valiklushnikov/input-duo/README.md

# Переключатель одной мыши между двумя ноутбуками

Устройство состоит из двух совместимых с Pro Micro плат на ATmega32U4, **5 В / 16 МГц**. К плате master подключается мышь, а receiver представляется второму ноутбуку как USB HID-мышь. Каждая плата получает питание по USB **от своего** ноутбука.

## Что прошивать

- `legacy/` — точно восстановленный исходный код. Это архивная версия для сравнения; не рекомендуется для новой сборки.
- `improved/` — рекомендуемая версия для новой сборки. Она допускает подключение плат в любом порядке и повторяет инициализацию мыши при неудаче.

Откройте в Arduino IDE `improved/mouse_switch_master/mouse_switch_master.ino` и прошейте её в плату со стороны мыши. Затем откройте `improved/mouse_switch_receiver/mouse_switch_receiver.ino` и прошейте её в другую плату, подключённую ко второму ноутбуку.

При обновлении уже работающей версии v4 до v5 достаточно заново прошить только master. Код receiver и протокол между платами не изменились.

Для компиляции выберите **Arduino Leonardo**: это совместимая цель для ATmega32U4/16 МГц. Для загрузки выбирайте фактическое определение платы Pro Micro, если оно доступно в вашей установке IDE. Если плата обычно не появляется как порт, дважды кратко нажмите Reset: второй сброс открывает загрузчик на несколько секунд. Выберите появившийся порт и начните загрузку сразу.

## Подключение

Перед подключением мыши проверьте распиновку USB-A. На версии Pro Micro 5V/16 MHz питание гнезда мыши берётся с рабочей линии VCC. Не полагайтесь на ориентацию разъёма «на глаз» — сверяйте её с конкретным гнездом и по возможности прозванивайте контакты.

```text
USB-A mouse pin 1 VBUS -> master VCC (только Pro Micro 5V/16 MHz)
USB-A mouse pin 2 D-   -> master D9 / PS2 Data
USB-A mouse pin 3 D+   -> master D10 / PS2 Clock
USB-A mouse pin 4 GND  -> master GND

master GND    -> receiver GND
master D2/SDA -> receiver D2/SDA
master D3/SCL -> receiver D3/SCL
```

Не соединяйте VCC или RAW двух плат между собой: USB каждого ноутбука питает только свою плату, а объединение шин питания ноутбуков опасно. D9/D10 используются только между гнездом мыши и master. На receiver они не нужны и в новой сборке их **нельзя** соединять между платами.

Если на платах нет подтяжек I²C, установите **одну** пару резисторов 4,7 кОм: один от SDA к локальным 5 В master, другой от SCL к локальным 5 В master. Общими между платами остаются только GND, SDA и SCL; не добавляйте соединение VCC/RAW и не объединяйте питающие линии ноутбуков.

Нужна мышь, умеющая режим PS/2 через пассивное USB-сопоставление. Произвольная современная мышь только с USB таким способом не заработает.

## Работа

После включения изначально выбран **ноутбук 2**. Боковая кнопка с маской `0x10` переключает ноутбуки один раз при каждом нажатии. Удержание не вызывает повторных переключений.

Вторая боковая кнопка с маской `0x20` всегда запускает на ноутбуке, подключённом к master, последовательность `Enter` → `/target KYPKYMA` → `Enter`. Текущая сторона управления мышью на это не влияет. Перед использованием на master-ноутбуке должна быть включена английская раскладка. Между символами выдерживается случайная задержка 35–80 мс, а после первого `Enter` и перед завершающим `Enter` — 80–140 мс. Макрос работает неблокирующе, поэтому движение мыши и передача на receiver продолжаются во время набора. Удержание `0x20` запускает только один макрос; для следующего запуска кнопку нужно отпустить и нажать снова.

Средняя кнопка полностью игнорируется. Движения, колесо, левая и правая кнопки направляются выбранной стороне.

## Если что-то не работает

- Нет реакции мыши: проверьте, не перепутаны ли D9 (PS/2 Data) и D10 (PS/2 Clock), подключён ли VBUS гнезда мыши к VCC платы 5V/16 MHz и совместима ли мышь с пассивным PS/2.
- Связи между платами нет: проверьте общий GND, SDA D2 и SCL D3; при необходимости добавьте описанную выше одну пару подтяжек I²C 4,7 кОм.
- Receiver не управляет ноутбуком: убедитесь, что в нём прошит `improved/mouse_switch_receiver`, а не master; проверьте адрес receiver I²C, заданный в скетчах.
- Макрос печатает другие символы: перед нажатием `0x20` переключите master-ноутбук на английскую раскладку. Прошивка отправляет американские HID-коды для точной строки `/target KYPKYMA`.
- После обрыва связи «залипла» кнопка: восстановите I²C, дождитесь повторного соединения improved-версии и отпустите/нажмите кнопку. Если состояние не очистилось, переподключите receiver к USB и проверьте все три линии I²C.

## Приёмка оборудования

Проверьте сборку до постоянного монтажа:

- [ ] Подключение сначала master, затем receiver; и в обратном порядке.
- [ ] После запуска выбран ноутбук 2.
- [ ] На обеих сторонах работают X/Y, колесо и кнопки.
- [ ] Переключение во время удержания левой и правой кнопок.
- [ ] Каждое нажатие выбранной боковой кнопки `0x10` даёт ровно одно переключение; удержание не повторяет переключение.
- [ ] Каждое нажатие боковой кнопки `0x20` на master вводит и отправляет ровно одну строку `/target KYPKYMA` с двумя `Enter`.
- [ ] Удержание `0x20` не повторяет макрос; после отпускания новое нажатие запускает его один раз.
- [ ] Во время макроса курсор продолжает двигаться плавно на обеих сторонах.
- [ ] Средняя кнопка полностью игнорируется.
- [ ] Отключение и повторное подключение мыши.
- [ ] Отключение и повторное подключение I²C.
