valiklushnikov/input-duo/docs/superpowers/specs/2026-08-02-two-board-diagnostics-design.md

# Диагностика двух Arduino Pro Micro

## Цель

Создать два временных диагностических скетча, которые без мультиметра проверяют обе платы ATmega32U4 и соединение между ними. Тесты не заменяют рабочие прошивки и после диагностики должны быть перезаписаны рабочими скетчами.

## Проверяемые узлы

1. USB CDC/Serial обеих плат.
2. USB HID Mouse второй платы.
3. Соединение `GND–GND`, `D2/SDA–D2/SDA`, `D3/SCL–D3/SCL`.
4. Передача I2C от первой платы ко второй по адресу `0x02`.
5. Ответ второй платы первой через `Wire.onRequest`.
6. Целостность и порядок тестовых пакетов.

PS/2-мышь, `D9` и `D10` проверяются отдельным скетчем `ps2_mouse_diagnostic_v2` и не входят в эту пару тестов.

## Скетч первой платы

`board1_link_tester.ino` работает как I2C-master и USB Serial-устройство.

- Каждую секунду запрашивает двухбайтовое состояние у адреса `0x02`: сигнатуру и номер последнего правильно обработанного пакета.
- При правильном ответе отправляет тестовый пакет с возрастающим номером последовательности.
- Пакет содержит сигнатуру, номер, направление небольшого движения и XOR-контрольную сумму.
- После передачи повторно запрашивает состояние второй платы и проверяет, что номер принятого пакета совпадает.
- В Serial Monitor на скорости 115200 печатает отдельный результат каждого цикла: `PASS`, отсутствие адреса, ошибка передачи, неверный ответ или несовпадение последовательности.
- Не использует PS/2-мышь и не формирует USB HID-команды.

## Скетч второй платы

`board2_full_test.ino` работает одновременно как I2C-slave с адресом `0x02`, USB Serial-устройство и HID-мышь.

- После запуска даёт пять секунд на открытие Serial Monitor.
- Один раз перемещает курсор по небольшому квадрату: вправо, вниз, влево, вверх. Нажатия кнопок не выполняются.
- Принимает только пакет ожидаемой длины, сигнатуры и контрольной суммы.
- Обработчик I2C сохраняет входные байты и состояние; вызовы `Mouse.move` выполняются только в `loop()`, не внутри прерывания.
- Для каждого правильного пакета выполняет небольшое движение курсора в заданном направлении.
- Через `Wire.onRequest` возвращает сигнатуру состояния и номер последнего правильно обработанного пакета.
- Serial Monitor показывает автономный HID-тест, правильные пакеты, ошибки длины/контрольной суммы и счётчики.

## Подключение и порядок проверки

### Автономный тест второй платы

1. Отключить провода `D2`, `D3` и `GND` от первой платы.
2. Загрузить `board2_full_test.ino` во вторую плату.
3. Открыть Serial Monitor 115200.
4. Убедиться, что курсор один раз описал квадрат и появилось сообщение `HID SELF-TEST COMPLETE`.

### Тест связи двух плат

1. Полностью отключить обе платы от USB.
2. Соединить только `GND–GND`, `D2–D2`, `D3–D3`; линии питания между платами не соединять.
3. Подключить вторую плату, затем первую.
4. Загрузить `board1_link_tester.ino` в первую плату, если он ещё не загружен.
5. Открыть Serial Monitor первой платы на 115200.
6. Наблюдать последовательные строки `I2C PASS` и небольшие движения курсора на компьютере второй платы.

## Критерии результата

- `HID SELF-TEST COMPLETE` и видимое квадратное движение означают, что USB, ATmega32U4 и HID второй платы работают.
- Последовательные `I2C PASS` без пропусков означают, что обе платы, общая земля и линии `D2/D3` работают в обоих направлениях.
- Отсутствие ответа `0x02` локализует проблему в питании второй платы, общей земле, `D2/D3`, адресе или I2C-периферии.
- Работа автономного HID-теста при неработающем I2C исключает USB/HID второй платы и переносит диагностику на межплатное соединение.

## Безопасность и ограничения

- Тест не нажимает кнопки мыши и не выполняет клавиатурных команд.
- Смещение курсора ограничено небольшими шагами и в автономном тесте возвращается в исходную точку.
- `VCC` и `RAW` двух плат не соединяются.
- Программная проверка не способна обнаружить ненадёжный контакт, который случайно работает во время теста; при нестабильных результатах требуется проверка пайки или прозвонка.

## Проверка реализации

- Оба скетча должны полностью компилироваться и компоноваться для Arduino Leonardo/ATmega32U4 5V 16 MHz.
- Формат пакета и вычисление контрольной суммы должны проверяться отдельными переносимыми unit-тестами до добавления Arduino-обвязки.
- После реализации выполняется полный существующий набор тестов проекта и полная AVR-сборка всех целей.
