valiklushnikov/input-duo/.superpowers/sdd/2026-08-01-dual-laptop-mouse-switch/task-2-report.md

# Task 2 report — I²C packet contract

## Status

Implementation complete and committed.  The required Arduino CLI compile could not reach preprocessing because the sandbox denies Arduino CLI access to its installed AVR platform/cache; the header itself compiled successfully with the already-installed AVR compiler as a local fallback.  No download or installation was performed.

## Files changed

- `improved/mouse_switch_master/mouse_switch_protocol.h`
- `improved/mouse_switch_receiver/mouse_switch_protocol.h`
- `tests/protocol_compile_test/mouse_switch_protocol.h`
- `tests/protocol_compile_test/protocol_compile_test.ino`
- `tests/test_protocol_copies.py`

## RED evidence

Before any protocol header existed, I created `tests/protocol_compile_test/protocol_compile_test.ino` with the required compile-time assertions and ran:

```powershell
& 'C:\Program Files\Arduino IDE\resources\app\lib\backend\resources\arduino-cli.exe' compile --fqbn arduino:avr:leonardo 'tests\protocol_compile_test'
```

It exited `1`, but before preprocessing: Arduino CLI attempted to initialize/install discovery tools and then reported `Access is denied` for `C:\Users\Valentyn\AppData\Local\Arduino15\packages`, followed by `Platform 'arduino:avr' not found`.  Therefore the intended missing-header diagnostic could not be reached; this is an infrastructure/sandbox failure, not a test result.

## GREEN evidence

After adding the three identical headers, the mandated Arduino CLI command was retried (including an isolated, copied local cache) and again exited `1` during CLI initialization with `Access is denied` for its `packages` path.  It did not parse the sketch, and network access was unavailable; no package was installed or downloaded.

The installed AVR compiler successfully compiled the required sketch and static assertions:

```powershell
& '.arduino-cli-temp\packages\arduino\tools\avr-gcc\7.3.0-atmel3.6.1-arduino7\bin\avr-g++.exe' -std=gnu++11 -mmcu=atmega32u4 -x c++ -I 'tests\protocol_compile_test' -c 'tests\protocol_compile_test\protocol_compile_test.ino' -o 'build\protocol_compile_test.o'
```

Output summary: exit `0`, no compiler diagnostics.  This verifies the header syntax, struct-size assertion, checksum assertion, and middle-button edge assertions using the installed AVR toolchain.

The copy-consistency test also passed:

```powershell
python -m unittest tests\test_protocol_copies.py
```

Output summary: `Ran 1 test in 0.001s` / `OK`.

## Commit

Implementation commit: `66450a45ee63913af67a2da34c17ba3f7d7fedb4` (`Define mouse switch packet protocol contract`).

## Self-review

- The packet is packed and asserted to exactly seven bytes in prescribed field order.
- The checksum XORs exactly the six transmitted bytes preceding the checksum.
- Validation rejects unknown types, unsupported button bits, malformed releases, and bad checksums.
- Report construction masks buttons; release construction zeroes motion and buttons.
- All three shipped headers are byte-identical, confirmed by `unittest`.
- The protocol never emits a middle-button output: the only middle-button-related API is the press-edge predicate.

## Concerns

- Arduino CLI 1.5.1 could not be fully exercised in this sandbox because it is denied access to its own platform cache (including an isolated in-repository copy) before compiling.  Direct AVR compilation is the available local fallback.
- `.arduino-cli-temp/` and `build/` are untracked temporary verification artifacts.  Automated removal was denied by the sandbox's destructive-command policy; they are intentionally not staged or committed.
