valiklushnikov/input-duo/docs/superpowers/specs/2026-09-04-file-transfer-design.md

# Передача файлов через общий буфер обмена — дизайн

**Дата:** 2026-09-04
**Статус:** утверждён для планирования
**Объём:** `configurator/` целиком; прошивка, протокол устройства и двоичный
формат конфигурации не меняются.
**Платформа:** Windows ↔ Windows. macOS — отдельный этап, здесь не реализуется.
**Предшествует:** `docs/superpowers/specs/2026-09-03-shared-clipboard-design.md`
(общий буфер обмена: текст, ссылки, изображения). Тот дизайн не отменяется и не
переписывается; файлы идут параллельным путём.

## Зачем

Общий буфер обмена уже переносит текст и картинки между двумя компьютерами и
подтверждён на живых машинах. Файлы остались за бортом, а именно их переносить
неудобнее всего: сейчас `Ctrl+C` в Проводнике отправляет на вторую машину путь
вида `file:///C:/...`, который там ни на что не указывает.

Задача: `Ctrl+C` в Проводнике на одном компьютере, `Ctrl+V` на другом —
включая папки целиком и файлы в гигабайты.

## Что установлено спайком, до всякого дизайна

Спайк от 2026-09-04 проверил выбранный путь экспериментом. Отчёт:
`.superpowers/sdd/2026-09-04-file-transfer-spike.md`, итог:
`.superpowers/sdd/2026-09-04-file-transfer-spike-verdict.md`.

**Путь выполним.** Объект COM, отданный в буфер обмена, оболочка Windows
принимает как настоящие файлы: 200 МиБ переданы, содержимое сверено независимо
посчитанным отпечатком, структура папок воссоздана точно. Проверено человеком
вручную: `Ctrl+V` в живом Проводнике работает, файл открывается, кнопка отмены
на месте.

**Новых зависимостей не нужно.** Всё делается на `ctypes`; `pywin32` и
`comtypes` не понадобились.

**Отдельный процесс не нужен, но потоки появляются.** Без настройки маршалинга
COM разносит чтения через цикл событий Qt и подвешивает его на каждый кусок
(замерено 0.25-0.52 с). С агрегированным free-threaded marshaler чтения уходят
в рабочие потоки RPC внутри нашего же процесса, и цикл событий не встаёт
(худшая пауза 0.063 с). Отложенная уступка про отдельный процесс из
предыдущего дизайна НЕ срабатывает.

**Оболочка ходит к концу файла за размером и обратно к нулю.** Чисто
последовательный сетевой поток не годится: `Seek` и `Stat` обязательны.

**Отмена приходит не сообщением, а отпусканием потока.** Отдельного колбэка
нет.

**Недокачанный файл на диске не остаётся** — это делает сама оболочка.

**Перечислять содержимое на каждый индекс не обязательно.** Проводник не
спрашивает формат, а сразу берёт данные по индексу. (Спайк сперва утверждал
обратное и сам исправил вывод, перепроверив.)

## 1. Объём

**Входит:** копирование файлов и папок между двумя спаренными компьютерами
Windows в обе стороны; любой размер; прогресс и отмена силами системы; ленивая
передача — содержимое уходит при вставке, а не при копировании; честный отказ
при обрыве без остатков на диске.

**Не входит намеренно:** возобновление после обрыва (решение владельца
продукта: начинать заново); macOS; вставка из архивов и других виртуальных
папок — только из настоящей файловой системы; права доступа и альтернативные
потоки NTFS; одновременные встречные передачи; объединение мелких файлов в один
поток.

## 2. Архитектура и потоки

Новые модули, все внутри существующего пакета:

```
clipboard/files/manifest.py     что копируют: список записей и сериализация
clipboard/files/source.py       сторона-источник: читает локальные файлы кусками
clipboard/files/sink.py         сторона-получатель: объявляет виртуальные файлы
clipboard/files/com_types.py    описания интерфейсов COM на ctypes
clipboard/files/data_object.py  объект для буфера обмена
clipboard/files/stream.py       поток на один файл: Read, Seek, Stat
clipboard/files/bridge.py       мост между потоком COM и циклом событий Qt
```

Ограничение предыдущего дизайна остаётся в силе: `duo_input/clipboard/**` не
импортирует `QtWidgets` и `QtGui`.

**Проект теряет свойство «ни одного потока».** До сих пор вся асинхронность
строилась на сигналах и таймерах, и это было сознательным решением. Теперь
поток, созданный COM, обращается к нам синхронно, а сеть живёт в цикле событий
Qt. Это осознанная плата за то, чтобы не заводить второй процесс со своим
запуском, обновлением и журналом.

**Мост — единственное место, где встречаются два мира.** Поток COM просит кусок
и блокируется; запрос уезжает в цикл событий Qt; ответ возвращается и поток
просыпается. Всё остальное — сеть, правила, координатор, интерфейс — остаётся
однопоточным и о потоках не знает.

**Правило, закрепляемое тестом:** никакой код вне `bridge.py` не трогает данные
из потока COM напрямую. Иначе через полгода гонки будут по всему пакету.

Ленивость, модель доверия, связывание, шифрование и обнаружение не меняются
вовсе. Текст и изображения продолжают работать прежним путём.

## 3. Манифест

Запись на каждый файл и каждую папку: относительный путь, размер, признак
каталога, время изменения. Плюс общее число записей и суммарный размер — чтобы
получатель мог показать «2.3 ГБ, 47 файлов» до всякой передачи.

Манифест едет в существующем объявлении отдельным дескриптором с именем формата
`application/x-duo-input-files`. Остальные поля дескриптора сохраняют смысл:
размер — суммарный размер всех файлов, отпечаток — отпечаток самого манифеста, а
не содержимого (содержимое к этому моменту ещё не читалось). Формат объявления
с самого начала был списком дескрипторов, а не парой «текст или картинка»,
поэтому совместимость не ломается: получатель старой версии просто не узнает
этот формат и покажет то, что понимает.

Сам манифест передаётся в теле объявления, а не отдельным запросом: он нужен
получателю сразу, чтобы объявить в буфере правильный набор файлов.

**Потолок: 65 536 записей** на одну операцию копирования. Сверх него — отказ с
внятным сообщением. Предел не в протоколе, а в здравом смысле: манифест на
десять тысяч файлов уже около мегабайта, а на потолке — порядка тринадцати, что
ещё умещается в кадр (32 МиБ), но передаётся заметно.

## 4. Чтение: запрос диапазона, а не поток

Четыре новых типа сообщений добавляются в перечисление `MessageType`
(`clipboard/wire.py`), следом за существующими, без изменения номеров прежних —
иначе разойдутся версии протокола:

```
FILE_READ    {seq, index, offset, length}
FILE_CHUNK   {seq, index, offset} + сырые байты
FILE_ERROR   {seq, index, reason}
FILE_CLOSE   {seq, index}
```

`FILE_CLOSE` отправляет получатель, когда оболочка отпустила поток — по отмене
или по завершении файла. Источник по нему закрывает файловый дескриптор.
Без этого сообщения отменённая передача гигабайта оставила бы открытый файл до
самого разрыва связи, и пользователь не смог бы, например, переименовать папку,
из которой копировал.

Старшая версия протокола буфера обмена поднимается на единицу: добавление типов
сообщений не ломает разбор кадров, но получатель прежней версии не поймёт
объявление с файлами, а расхождение старшей версии уже приводит к внятному
сообщению «обновите вторую машину» (предыдущий дизайн, раздел 11).

`Stat` отвечается из манифеста, не спрашивая сеть: размер уже известен. `Seek`
поэтому становится арифметикой смещения и не стоит ни одного байта по проводу.
Это и есть причина, по которой протокол адресный, а не потоковый — оболочка
ходит к концу файла и обратно, и последовательный поток так не сможет.

**Размер куска: 256 КиБ** — ровно столько запрашивает оболочка, замерено
спайком. Гигабайт это около четырёх тысяч запросов; на локальной сети
приемлемо, и каждый из них можно прервать.

## 5. Целостность и изменившийся источник

**Отпечатки файлов не считаем.** Для гигабайта это лишнее полное чтение на
отправителе, а целостность канала уже даёт TLS. Вместо этого сверяется размер:
если файл изменился между копированием и вставкой, длина разойдётся с
манифестом, и это ошибка.

- **Файл удалён после копирования** — чтение отказывает, пользователь видит
  ошибку оболочки, недописанного файла не остаётся.
- **Файл изменился** — расходится размер, тот же исход.
- **Файл занят другой программой** — открываем на чтение с разделением, как это
  делает сам Проводник; если не вышло, отказываем внятно.

## 6. Сторона получателя

В буфер кладётся объект COM, отдающий описание файлов и содержимое каждого из
них. Для Проводника он неотличим от настоящих файлов.

Существующий ленивый объект для текста и изображений остаётся как есть. Файлы —
отдельный объект: механизмы разные (там `QMimeData` с отложенной отрисовкой,
здесь COM), общий у них только принцип — обещание вместо данных.

Пользователь вставляет куда угодно: в любую папку, на рабочий стол, в
архиватор. О месте назначения мы не знаем ничего и знать не должны.

**Известное поведение, изменить нельзя:** при ошибке посреди передачи оболочка
показывает модальное окно и наш вызов висит, пока человек не ответит. При
обрыве связи пользователь увидит системный диалог ошибки, а не тихий отказ —
что скорее к лучшему, потому что тихий отказ он бы пропустил.

## 7. Отмена и обрыв

Отмена приходит тем, что оболочка отпускает поток. Мы это замечаем, перестаём
запрашивать куски и отправляем `FILE_CLOSE`, чтобы источник закрыл файл.

Отдельно надо предусмотреть то, чего оболочка не делает: если поток отпущен во
время того, как мост ждёт ответа из сети, ожидающий поток обязан проснуться, а
пришедший позже кусок — быть отброшенным, а не записанным в уже закрытый файл.
Это же требование проверяется тестом второго уровня.

Обрыв связи посреди передачи: **начинаем заново** — решение владельца продукта.
Незавершённая передача отказывает, оболочка убирает недокачанное. Состояния на
диске не храним, поэтому склеить повреждённый файл из двух попыток физически
нечем — это и есть причина, по которой возобновление отвергнуто.

## 8. Приватность

**Содержимое файлов не проходит через диск на стороне отправителя:** читаем из
исходного файла кусками и сразу отдаём в сеть. На стороне получателя пишет
Проводник, прямо в целевую папку — временных копий не создаём вовсе.

Маркеры приватности Windows работают как раньше: помеченное как не подлежащее
запоминанию не объявляется. Правило общее для текста, изображений и файлов.

## 9. Тестирование

**Уровень 1, чистая логика без COM и сети.** Манифест: обход папки,
относительные пути, вложенность, пустые каталоги, потолок записей,
сериализация. Арифметика смещений: `Seek` от начала, от конца, за пределы
файла. Быстрые обычные тесты, их большинство.

**Уровень 2, мост.** Самое опасное место, проверяется отдельно и придирчиво:
запрос из чужого потока получает ответ; одновременные запросы из нескольких
потоков не путают ответы; отказ сети будит ожидающий поток, а не оставляет его
висеть; остановка подсистемы во время ожидания не оставляет заблокированных
потоков. Настоящие потоки, никакого COM.

**Уровень 3, объект целиком без Проводника.** Мы сами вызываем те же методы,
что вызывает оболочка: описание, открытие потока, чтение кусками, отпускание на
середине. Основой служит потребитель, написанный в спайке.

**Уровень 4, сквозной на loopback.** Два узла в одном процессе, настоящий TLS,
настоящий манифест, чтение файла через мост целиком и сверка байтов. Медленный,
поэтому таких немного.

**Мутационная проверка** каждого защитного условия — правило, доказавшее себя
на предыдущем этапе. Особенно: сверка размера при чтении, потолок числа
записей, пробуждение потока при отказе. Тест на мост, проходящий при сломанном
мосте, опаснее отсутствия теста: гонки не воспроизводятся по требованию, и,
один раз поверив зелёному, к нему больше не возвращаются.

**Проверяется человеком, автоматика не заменяет:** `Ctrl+V` в живом Проводнике;
вид окна прогресса и работа отмены; обрыв Wi-Fi посреди гигабайта; вставка на
медленный носитель.

## 10. Риски

**Гонки в мосте** — самое вероятное место будущих загадочных ошибок.
Смягчение: мост мал, он единственное место с потоками, проверяется отдельно и
мутационно.

**Утечка объектов COM** — счётчики ссылок ведутся вручную на `ctypes`; ошибка
даёт либо преждевременное освобождение с падением, либо вечно живущий объект.
Смягчение: тест, проверяющий, что после отпускания объект действительно
освобождён.

**Модальное окно ошибки от оболочки** — вызов висит до ответа человека.
Изменить нельзя, фиксируется как известное поведение.

**Большие папки** — десять тысяч мелких файлов это десять тысяч отдельных
обменов, будет медленно. Потолок записей защищает от безумного, но медленно
всё равно будет. Если станет проблемой — объединение мелких файлов в один
поток, следующий этап.

## 11. Порядок работы

Восемь задач, каждая заканчивается работающим и проверенным куском:

1. Манифест: обход, сериализация, потолок, отказы.
2. **Мост между потоками** — раньше всего остального.
3. Описания интерфейсов COM на `ctypes`: перенос выверенного спайком кода в
   production-вид.
4. Поток на один файл: `Read`, `Seek`, `Stat`, отпускание.
5. Объект для буфера обмена.
6. Сторона источника: чтение кусками, исчезнувший и изменившийся файл.
7. Сетевые сообщения и связывание сторон.
8. Подключение к интерфейсу, приёмка, документация.

Первой идёт не самая заметная задача, а самая рискованная — как спайк на
предыдущем этапе, который окупился тем, что нашёл две вещи, о которых
спецификация не знала.

## 12. Открытых вопросов нет

Решения, принятые в обсуждении и зафиксированные здесь: большие файлы и папки
целиком; обрыв означает начать заново, без остатков на диске; отпечатки файлов
не считаем; потолок 65 536 записей; потоки в проекте появляются ради отказа от
отдельного процесса.
