valiklushnikov/input-duo/docs/superpowers/specs/2026-09-03-shared-clipboard-design.md

# Общий буфер обмена между компьютерами — дизайн

**Дата:** 2026-09-03
**Статус:** утверждён для планирования
**Объём:** `configurator/` целиком; прошивка, протокол устройства и двоичный
формат конфигурации не меняются.
**Платформа MVP:** Windows ↔ Windows. macOS — граница абстракции, не реализация.

## Зачем

Два ноутбука делят одну мышь и клавиатуру через Duo Input, но не делят буфер
обмена. Скопированное на одном приходится перенабирать на другом. Задача — дать
`Ctrl+C` на одной машине и `Ctrl+V` на другой, не заводя отдельную программу и
не отправляя ничего в интернет.

## Что установлено исследованием, до всякого дизайна

Три факта ограничивают решение сильнее, чем любые предпочтения.

**USB-HID-устройство не может прочитать буфер обмена хоста.** Ни `Ctrl+C`,
посланный устройством, ни какой-либо HID-механизм не дают ему содержимое.
Поэтому данные обязаны идти между программами на компьютерах, а не через железо.
Это же означает, что фича принципиально требует Duo Input, запущенного на
**обоих** компьютерах.

**У второго компьютера нет канала к железу вообще.** CDC есть только у U1;
`firmware/u2_endpoint/tusb_config.h:28` — `#define CFG_TUD_CDC 0`, с явным
обоснованием, что порт на U2 нежелателен. ПК2 не может спросить устройство ни о
чём.

**TLS доступен из Qt без новых сетевых зависимостей.** Замер на целевой машине:
`QSslSocket.supportsSsl()` равно `True`, backends `cert-only`, `openssl`,
`schannel`, активен openssl (сборка 3.0.7, runtime 3.5.7). Значит защищённый
транспорт живёт в том же event loop, что и всё остальное приложение.

Дополнительно, о существующем приложении: в `configurator/src/duo_input/` нет ни
одного потока и ни одной корутины (`QThread`, `asyncio`, `threading` не
встречаются) — вся асинхронность построена на сигналах Qt и `QTimer`.
Платформенной абстракции нет: единственная ветка по ОС во всём приложении —
`persistence/locations.py:28`. Трея нет: `QSystemTrayIcon` не встречается, а
`main_window.py:908` `closeEvent` просто принимает событие, то есть закрытие
окна сегодня завершает процесс.

## 1. Объём

**Входит в MVP (milestone 1):** фоновый режим и трей; автозапуск по
переключателю; парринг двух компьютеров; TLS с закреплением отпечатка;
обнаружение в LAN и ручной ввод адреса; ленивая синхронизация обычного текста,
Unicode, URL и изображений в обе стороны; три пояса подавления петель;
приватность и уважение маркеров Windows; страница «Общий буфер»; внятные
сообщения об ошибках.

**Отложено явно:** файлы (milestone 2); macOS (milestone 3); история буфера —
не делается без отдельного решения; больше одного пира; сигнал активного хоста
от RP2040; вынос подсистемы в отдельный процесс.

## 2. Архитектура

Один процесс. Новый пакет `configurator/src/duo_input/clipboard/` **импортирует
только `QtCore` и `QtNetwork` и никогда `QtWidgets`**.

Это правило — не стиль, а сохранённая возможность: пока оно соблюдается,
подсистему можно вынести в отдельный процесс, когда передача файлов в
milestone 2 начнёт мешать отрисовке. Оно проверяется тестом на импорты, потому
что правило, которое ничто не проверяет, перестаёт действовать примерно через
месяц.

```
app.main
 ├── DeviceService      (существует)   ── CDC → U1
 ├── ClipboardService   (новое)        ── правила; ничего не знает об ОС и о сокетах
 │    ├── ClipboardBackend             ── граница платформы (реализация: Windows)
 │    ├── PeerLink                     ── одно TLS-соединение
 │    ├── Discovery                    ── UDP-маячок
 │    ├── PairingFlow + TrustStore     ── кто нам свой
 │    └── OfferRegistry                ── что объявлено нами и нам
 ├── MainWindow         (существует, + страница «Общий буфер»)
 └── TrayIcon           (новое, QtWidgets)
```

Разделение проведено так, что о каждом узле можно ответить на три вопроса
самостоятельно: `ClipboardBackend` знает про ОС и ничего про сеть; `PeerLink`
знает про байты и ничего про буфер обмена; `ClipboardService` знает про правила
и ничего про Win32 и сокеты.

Вариант с отдельным фоновым сервисом отклонён по существу: служба Windows
работает в сессии 0 и **не может читать буфер обмена интерактивной сессии**, а
до входа пользователя буфера обмена не существует вовсе. Единственное
преимущество такого разделения — изоляция падений — не окупает второй процесс,
IPC, второй журнал и согласованное обновление двух бинарников, пока файлов нет.

Вариант с платформенными оболочками отклонён как абстракция, у которой сейчас
была бы ровно одна реализация и ни одного второго потребителя, способного
проверить, что граница проведена в верном месте.

## 3. Компоненты

```
clipboard/identity.py        origin_id, ключ и сертификат узла, их создание
clipboard/trust.py           TrustStore: доверенные пиры на диске
clipboard/offer.py           ClipboardOffer и дескрипторы содержимого
clipboard/wire.py            кадрирование и типы сообщений
clipboard/backend.py         ClipboardBackend (Protocol), RemoteMimeData
clipboard/windows_backend.py реализация для Windows
clipboard/peer.py            PeerLink: исходящее и входящее TLS-соединение
clipboard/listener.py        QTcpServer, принимающий только доверенного пира
clipboard/discovery.py       UDP-маячок
clipboard/pairing.py         поток парринга и код сравнения
clipboard/service.py         ClipboardService: связывает всё, держит правила
ui/clipboard_page.py         страница в rail
ui/tray.py                   QSystemTrayIcon и его меню
```

## 4. Жизненный цикл приложения

Сегодня закрытие окна завершает процесс. Становится так:

**Решение продукта (владелец продукта, 2026-09-03):** окно уходит в трей по
закрытию **всегда**, независимо от того, включён общий буфер или нет.
Резидентность больше не следствие включённой фичи — это свойство самой
программы, а не подсистемы общего буфера. Прежнее правило («тот, кто
настраивает макросы и не пользуется общим буфером, не должен получить
постоянно висящее приложение») отменено этим решением явно, а не по ошибке.

- `MainWindow.closeEvent` всегда прячет окно и отвергает событие закрытия —
  ветки по состоянию общего буфера в нём больше нет.
- Значок в трее (`TrayIcon`) создаётся при старте программы и существует всё
  время её работы, при любом состоянии общего буфера. Это необходимое
  условие, а не удобство: раз окно теперь всегда прячется по закрытию, без
  всегда-живого трея скрытое окно стало бы недоступным — показать его нечем,
  выйти из программы нечем, а процесс просто висел бы. Трей и жизненный цикл
  окна собираются в `app.py` отдельно от подсистемы общего буфера
  (`_ClipboardRuntime.__init__`, а не `_start()`), которая по-прежнему
  поднимается и останавливается только переключателем «Общий буфер».
- `QApplication.setQuitOnLastWindowClosed(False)` по-прежнему включается и
  выключается вместе с подсистемой общего буфера (`_start()`/`_stop()`) — это
  не противоречит новому правилу, поскольку `closeEvent` в принципе больше не
  принимает закрытие окна ни при каком состоянии фичи.
- Выход — единственный пункт «Выход» в меню трея; он доступен независимо от
  того, поднята ли подсистема общего буфера.

**Трей** (`QSystemTrayIcon`): открыть Duo Input; состояние пира (не спарен /
поиск / подключён / ошибка); переключатель «Общий буфер»; переключатель
«Передача файлов» — присутствует, но в milestone 1 всегда выключен и
недоступен, чтобы меню не переделывать; Выход. Иконка отражает состояние
соединения: когда окно скрыто, это единственный индикатор. Переключатель
«Общий буфер» в трее всегда отражает настоящее сохранённое состояние настройки
(а не принудительное «включено») и работает в обе стороны даже тогда, когда
подсистема ещё не запущена: галочка поднимает её, снятие — останавливает.

**Автозапуск:** ярлык в `shell:startup`, а не ключ реестра — ярлык виден в
«Автозагрузке» диспетчера задач и убирается руками. Ставится переключателем в
приложении, **по умолчанию выключенным**, и никогда инсталлятором. Прав
администратора не требует, то есть `PrivilegesRequired=lowest` в
`configurator/packaging/duo-input.iss` остаётся в силе. При автозапуске окно не
показывается.

**Один экземпляр:** замок на `QLocalServer`; второй запуск поднимает окно
первого и завершается. Без этого два процесса дерутся за порт и оба реагируют
на изменение буфера — то есть петля возникает на одной машине.

**Пока общий буфер выключен, ни один сокет не открывается.** Брандмауэр не
спрашивает, поведение программы не отличается от сегодняшнего.

Docstring `app.py` сейчас утверждает, что программа не делает сетевых запросов.
Он переписывается на правду: соединения только внутри локальной сети, только к
явно спаренному компьютеру, только при включённой фиче; телеметрии по-прежнему
нет.

## 5. Буфер обмена Windows: снимок и ленивая отдача

**Наблюдение.** `QClipboard.dataChanged` с дебаунсом 200 мс: одна операция
`Ctrl+C` порождает несколько событий, потому что приложения выкладывают форматы
по очереди. Берётся последнее состояние. Буфер бывает заперт другим процессом, и
Qt тогда отдаёт пустой `QMimeData`; пустой снимок не объявляется, попытка
повторяется через 200 мс до трёх раз.

**Снимок делается локально и сразу.** Ленивость относится к сети, а не к
локальному чтению: если отложить чтение до момента вставки, исходный буфер уже
может смениться, и будет отдано не то, что обещано. Снимок живёт в оперативной
памяти исходной машины до следующего копирования. Наружу уходит только описание.
Снимки больше 32 МиБ не объявляются (запись в журнал, без ошибки на экране).

**Отдача.** Подкласс `QMimeData`, у которого `formats()` возвращает объявленные
типы, а `retrieveData()` запрашивает данные у пира. `retrieveData` синхронный, а
сеть асинхронная, поэтому внутри крутится локальный `QEventLoop`: 30 секунд на
всю передачу целиком. Отдельного срока на "первый ответ" нет и не заведено:
содержимое приходит одним кадром `CONTENT`, а не потоком, поэтому у этого слоя
нет наблюдаемой границы между "пир начал отвечать" и "пир закончил отвечать" -
такая константа была объявлена и не использовалась (ревью, M1) и убрана вместе
с этим упоминанием. Windows даёт на `WM_RENDERFORMAT`
порядка 30 секунд, а вставляющее приложение всё равно ждёт. На время отдачи
обработка новых clipboard-событий подавляется — иначе получается реентрантность
в единственном event loop.

**Это допущение проверяется первым шагом реализации, до всего остального.**
Нужно убедиться, что Qt на Windows действительно вызывает `retrieveData` в
момент вставки, а не материализует данные сразу при `setMimeData`. Если
материализует, у ленивой модели остаются два выхода — нативный `IDataObject`
через COM либо отказ от ленивости для мелких данных, — и узнать об этом надо до
того, как вокруг допущения построена подсистема.

**Форматы MVP:** `text/plain` (UTF-8), `text/uri-list`, `image/png`. URL
переносится как обычный текст; отдельного типа он не требует. Изображение
передаётся как PNG: обе стороны Windows, и Qt конвертирует `CF_DIB` в PNG и
обратно средствами `QImage`.

**Имена форматов сравниваются без параметров.** Спайк показал, что Qt
запрашивает `text/plain;charset=utf-8`, тогда как объявляется `text/plain`.
Точное сравнение строк означало бы, что вставка текста не работает никогда, а
выглядело бы как пустой буфер без единой ошибки в журнале. Поэтому всё, что
следует за `;`, отбрасывается перед сравнением.

**Выход из программы — тоже запрос содержимого.** Тот же спайк показал второй
вызов `retrieveData` уже после `exec()`: Windows забирает данные при завершении
процесса-источника, чтобы буфер пережил его закрытие. Значит остановка
подсистемы обязана предшествовать завершению приложения — иначе выход уйдёт в
сеть и будет ждать до предела передачи. После разрыва связи запрос отказывает
сразу, поэтому достаточно останавливать координатор раньше, чем закрывается
приложение.

## 6. Подавление петель

Три пояса, потому что ни один из них не полон в одиночку.

1. **Маркер происхождения.** Кладя удалённое содержимое в свой буфер, узел
   добавляет формат `application/x-duo-input-origin` со значением
   `<origin_id>:<seq>`. Собственный монитор, увидев маркер, ничего не объявляет.
2. **Отпечаток.** Объявление несёт sha256 содержимого. Узел, сделав локальный
   снимок, считает его sha256 и не объявляет снимок, чей хеш совпадает с хешом
   из последнего принятого объявления. Сравниваются именно хеши, а не данные:
   на принимающей стороне содержимого нет — в этом и смысл ленивой модели. Это
   ловит случай, когда приложение-получатель пересоздало содержимое и маркер
   потерялся.
3. **Собственный origin.** Объявление, вернувшееся со своим `origin_id`,
   отбрасывается.

Второй пояс не срабатывает, если пользователь осмысленно скопировал ровно тот же
текст ещё раз; тогда работает третий, и повторная синхронизация корректна.

Каждый пояс проверяется мутационно: при удалённом условии соответствующий тест
обязан упасть.

## 7. Приватность

- **Истории буфера нет.** Она не входит в задачу и умножает риск.
- **Содержимое никогда не пишется на диск.** Только оперативная память, только
  последний снимок. Временных файлов в milestone 1 не существует.
- **Маркеры приватности Windows уважаются.** Если буфер несёт
  `ExcludeClipboardContentFromMonitorProcessing` или
  `CanIncludeInClipboardHistory` со значением 0 — их ставят менеджеры паролей, и
  на них же смотрит собственная «История буфера обмена» Windows — содержимое не
  объявляется. Qt показывает такие форматы как
  `application/x-qt-windows-mime;value="..."`. Проверяется на настоящем
  менеджере паролей: тест на выдуманном формате пройдёт и не докажет ничего.
- **Один переключатель** в трее прекращает всё: снимки не делаются, соединение и
  сокеты закрываются.
- **При разрыве** уже объявленное удалённое содержимое из буфера пользователя не
  стирается: вставка не сработает, трей показывает разрыв, событие идёт в
  журнал. Стирать чужой буфер обмена приложение права не имеет.

## 8. Сеть

**Транспорт:** TCP + TLS через `QSslSocket`, порт 47654 — фиксированный, чтобы
правило брандмауэра было одно. Асинхронно, в том же event loop, без потоков.

QUIC отклонён: общего QUIC API в Qt 6 нет, а мультиплексирование и 0-RTT ничего
не покупают для одного соединения в локальной сети. Голый TCP отклонён: в буфере
бывают пароли, Wi-Fi доверенной сетью не является.

**Аутентификация:** самоподписанный сертификат у каждого узла (RSA-2048, срок
10 лет — доверие даёт отпечаток, а не срок), `VerifyPeer` плюс собственная
проверка точного совпадения отпечатка с закреплённым в `TrustStore`.

Изначально здесь стояла ECDSA P-256 - более дешёвый и современный выбор. Смена
на RSA была вынужденной, а не эстетической: на целевой платформе (Windows,
backend Schannel) `QSslKey` не смог импортировать приватный EC-ключ,
сгенерированный `cryptography` - рукопожатие TLS не поднималось вообще, и это
выглядело бы у пользователя как "нет связи" без единой подсказки почему.
`identity.py` дополнительно проверяет тип ключа при чтении с диска и
пересоздаёт идентичность целиком, если находит EC-ключ, оставшийся от более
старой сборки, - см. `_read_if_consistent()`.

Отсюда единственная новая runtime-зависимость проекта помимо PySide6:
**`cryptography`**, потому что Qt умеет читать ключи, но не создавать их.
Вариант TLS-PSK, который позволил бы обойтись без неё, отклонён: PSK-шифры
поддерживает openssl-backend и не поддерживает schannel, а какой backend
окажется активным на чужой машине, мы не контролируем. Экономия одной
зависимости не стоит канала, который на части машин молча не поднимется.

**Кадр:** 4 байта длины (big-endian, потолок 32 МиБ) + 1 байт типа + payload.
CRC не нужен: целостность даёт TLS.

Payload устроен одинаково у всех типов: 2 байта длины заголовка (big-endian) +
заголовок в виде JSON в UTF-8 + сырые байты. У всех сообщений, кроме `CONTENT`,
сырая часть пуста; у `CONTENT` она и есть содержимое буфера. Один формат вместо
двух — чтобы разбор кадра не зависел от того, какой у кадра тип.

```
HELLO(1)          {protocol_major, protocol_minor, origin_id, machine_name}
OFFER(2)          {seq, descriptors: [{mime, size, sha256}]}
FETCH(3)          {seq, mime}
CONTENT(4)        {seq, mime} + сырые байты
CONTENT_ERROR(5)  {seq, mime, reason}
PING(6) / PONG(7)
PAIR_REQUEST(8)   {origin_id, machine_name}
PAIR_CONFIRM(9)   {accepted}
```

Версия протокола буфера обмена своя, не связанная с `protocol_version`
устройства из `protocol/schema.json`. Расхождение в major при `HELLO` разрывает
соединение с внятным сообщением.

Файлы в milestone 2 добавляются новым типом дескриптора и манифестом; формат
объявления уже является списком дескрипторов, а не парой «текст или картинка»,
поэтому совместимость не ломается.

## 9. Обнаружение

UDP-маячок на группе 239.255.76.67, порт 47655. Содержимое: `origin_id`,
отпечаток сертификата, имя машины, порт, версия протокола. **Содержимое буфера в
маячке не передаётся никогда.**

mDNS отклонён: искать нужно исключительно собственное приложение, поэтому
интероперабельность Bonjour не покупает ничего, а `zeroconf` — это зависимость и
конфликты со службой Bonjour на Windows.

Маячок рассылается активно **только в режиме парринга**. После парринга узлы
соединяются напрямую по последнему известному адресу, а маячок используется
редко и только когда пир не найден — так присутствие Duo Input не светится в
сети постоянно.

**Ручной ввод адреса обязателен** как запасной путь: сети с изоляцией клиентов и
разные подсети встречаются постоянно, и без него фича у части пользователей
просто не заработает.

## 10. Парринг и модель угроз

1. Пользователь на обеих машинах нажимает «Связать компьютеры»; обе входят в
   режим парринга на 2 минуты.
2. Машины находят друг друга и поднимают TLS с пока недоверенными сертификатами.
3. Обе показывают **один и тот же шестизначный код**: `sha256` от двух
   отпечатков, склеенных в отсортированном порядке; первые 8 байт результата
   читаются как целое без знака и берутся по модулю 1 000 000, с ведущими
   нулями. Сортировка отпечатков нужна, чтобы обе стороны получили одно и то же
   число независимо от того, кто из них кто.
4. Пользователь сверяет коды и подтверждает **на обеих машинах**; только тогда
   сертификаты попадают в `TrustStore`.

Код сравнивается, а не вводится: введённый код пришлось бы где-то показать, и он
стал бы секретом, который надо защищать. Сравнение секретом не является и при
этом ловит подмену, потому что подобрать пару сертификатов с тем же кодом
атакующий не может.

| Угроза | Что её закрывает |
|---|---|
| Чужой компьютер в той же сети | Подтверждение на обеих машинах |
| Подмена обнаружения | Маячок не даёт доверия; доверие даёт только парринг |
| MITM | Сравнение кода из обоих отпечатков |
| Инъекция буфера или файлов | Соединение принимается только от закреплённого сертификата |
| Replay | TLS плюс монотонный `seq`; объявление с номером не больше последнего отбрасывается |
| Случайная связь с другим Duo Input | Требуется явное подтверждение на обеих сторонах |
| Утечка другим устройствам | Данные уходят только в установленное соединение с этим пиром |

**Ровно один пир.** Устройство существует про два компьютера. Хранилище
структурно допускает список, логика и интерфейс — нет.

## 11. Ошибки и восстановление

- **Кто кому звонит:** после парринга соединяется узел с меньшим `origin_id`,
  второй слушает. Детерминированно, без переговоров и без гонки встречных
  соединений. Во время самого парринга `origin_id` пира ещё не известен, поэтому
  там соединяются оба, и лишнее из двух соединений закрывается по тому же
  правилу, как только `HELLO` назвал обе стороны.
- **Переподключение:** 1 → 2 → 4 → 8 → 30 секунд, потолок 30.
- **Heartbeat:** `PING` раз в 10 секунд; молчание 30 секунд считается разрывом.
- **Брандмауэр отказал:** обнаруживается отдельно (не удалось слушать либо нет
  входящих при известном адресе) и сообщается словами. «Нет связи» вместо
  «Windows не пустил» — худший ответ, потому что пользователь начнёт чинить не
  то.
- **Пир исчез между копированием и вставкой:** `CONTENT_ERROR` или таймаут,
  пустая вставка, запись в журнал, разрыв в трее.
- **Расхождение major версии протокола:** разрыв и сообщение о необходимости
  обновить вторую машину.

## 12. Интерфейс

Новая страница «Общий буфер» в rail `MainWindow` (`PAGE_CLIPBOARD` в
`PAGE_ORDER`): состояние соединения, имя и отпечаток спаренного компьютера,
кнопки «Связать компьютеры» и «Забыть компьютер», ручной адрес, переключатели
«Общий буфер» и «Автозапуск», последние события. Диалог парринга показывает
шестизначный код и требует подтверждения.

Строки идут в оба каталога переводов, русский по умолчанию, как задано в
`i18n.py`. Идентификаторы протокола не переводятся — по тому же правилу, что уже
записано в `i18n.py`.

Ключи `QSettings`: `clipboard/enabled` (по умолчанию false),
`clipboard/autostart` (false), `clipboard/peer_origin_id`,
`clipboard/manual_address`, `clipboard/files_enabled` (в milestone 1 всегда
false).

Файлы состояния — рядом с журналами, в `%LOCALAPPDATA%\DuoInput\`:
`node-key.pem`, `node-cert.pem`, `peers.json`.

## 13. RP2040

**В MVP не интегрируется.** Причины конкретны: сигнал доступен только ПК1,
потому что у U2 нет CDC; маршрута PC1/PC2 в `GET_STATUS` сегодня нет
(`device/transactions.py:366`), то есть `ACTIVE_HOST_CHANGED` — это новое
CDC-сообщение в `protocol/schema.json`, новая прошивка U1 и подъём версии
протокола; а покупает это ровно предзагрузку содержимого к моменту
переключения, которой в локальной сети нечего оптимизировать. Вдобавок сигнал
асимметричен: до ПК2 он всё равно поедет по той сети, по которой мы уже
общаемся.

Как добавить позже, если понадобится: push из U1 по образцу `CAPTURE_EVENT`
(`device/service.py:324`), `DeviceService` эмитит сигнал, `ClipboardService` его
слушает. Интерфейс «на будущее» сейчас **не заводится**: абстракция с нулём
реализаций хуже, чем её отсутствие, потому что её некому проверить.

## 14. Файлы — milestone 2

Желаемое поведение: `Ctrl+C` в Проводнике, переключение, `Ctrl+V` на второй
машине; содержимое передаётся при вставке, а не при копировании.

Путь реализации выбирается спайком в начале milestone 2 из двух: COM
`IDataObject` с `CFSTR_FILEDESCRIPTORW` и `CFSTR_FILECONTENTS` либо локальный
WebDAV-диск, на который указывает `text/uri-list`. Предпочтителен второй:
Проводник сам даёт потоковое чтение, индикатор прогресса и отмену, то есть три
требования закрываются без собственного кода. `QMimeData` здесь не
переиспользуется вообще — он умеет `text/uri-list`, а тот требует реальных путей
на локальном диске.

К milestone 2 относятся целиком: несколько файлов, каталоги, большие файлы,
прогресс, отмена, временные файлы и их очистка, прерванная передача, проверка
целостности, исчезнувший после копирования исходный файл, сменившийся до вставки
буфер. В milestone 1 этих ситуаций не существует. Вероятно, тогда же сработает
отложенная уступка про отдельный процесс — и уедет в него именно передача
файлов, а не подсистема целиком.

## 15. macOS — milestone 3

Не реализуется. Единственное место, куда macOS придёт, — вторая реализация
`ClipboardBackend`. Всё остальное (сеть, обнаружение, парринг, правила)
платформы не касается. Что потребуется тогда, зафиксировано здесь, чтобы не
выяснять заново: `.app`-бандл вместо Nuitka и Inno Setup, `LSUIElement` для
строки меню, подпись Developer ID и нотаризация, разрешение Local Network (без
него обнаружение и соединение не работают), `NSPasteboard` с ленивым провайдером
вместо `QMimeData`, автозапуск через `SMAppService`.

## 16. Тестирование

1. **Чистая логика** без Qt-сети: сериализация объявления, три пояса подавления
   петель, `TrustStore`, вывод кода парринга.
2. **Эмулятор пира** по образцу `device/emulator.py`: весь сценарий
   «скопировал → объявили → запросили → отдали» без единого сокета.
3. **Настоящая сеть на loopback**: два `ClipboardService` в одном процессе с
   реальным TLS — парринг, закрепление отпечатка, отказ недоверенному
   сертификату, переподключение.
4. **Backend буфера обмена**: сначала выяснить, работает ли `QClipboard` под
   `QT_QPA_PLATFORM=offscreen`, который установлен в `tests/ui/conftest.py`. Если
   нет — эти тесты идут отдельным маркером для Windows. Предполагать нельзя:
   offscreen уже скрывал в этом проекте целый класс дефектов.
5. **Контракт сборки**: в `configurator/tests/packaging/test_dist.py`
   добавляется проверка, что в собранном `dist/DuoInput` TLS реально
   поднимается, а TLS-плагин и OpenSSL на месте. Сейчас их там нет, потому что
   QtNetwork не используется; молча недостающая библиотека превратится в «нет
   связи» у пользователя.
6. **Тест на импорты**: `clipboard/` не тянет `QtWidgets`.
7. **Мутационная проверка каждого защитного условия**: три пояса от петель,
   сверка отпечатка, отказ по расхождению major. Удаляем условие — тест обязан
   упасть.
8. **Тест через `app.main`**: при включённой фиче сервис действительно
   создаётся, трей ставится, `setQuitOnLastWindowClosed` переключается.
   Работающий модуль, до которого production не дотягивается, — это неработающая
   функция.
9. **Трей всегда, подсистема — по галочке** (решение продукта, 2026-09-03):
   значок в трее существует и при выключенном общем буфере; закрытие окна с
   выключенной фичей прячет его, а не завершает программу; галочка «Общий
   буфер» в трее при старте отражает настоящую настройку, а не принудительное
   «включено», и поднимает/останавливает подсистему в обе стороны через
   настоящий пункт меню, а не через запись ключа настроек в обход UI; пока
   фича выключена, ни один сокет не слушается — тест это проверяет пробным
   `QTcpServer` на порту координатора, а не чтением внутреннего состояния.

Ручные проверки, которые автотест не заменяет: настоящий менеджер паролей и его
маркеры; отказ в диалоге брандмауэра; две физические машины на одном Wi-Fi;
Wi-Fi с изоляцией клиентов и ручной адрес.

## 17. Упаковка, автозапуск, зависимости

Nuitka дополнительно тянет QtNetwork, TLS-плагин, OpenSSL и `cryptography` с её
нативной частью; то, что всё это упаковалось, проверяется тестом из пункта 16.5,
а не предполагается. `configurator/packaging/duo-input.iss` не меняется:
автозапуск ставит приложение по переключателю, правило брандмауэра создаётся
операционной системой при первом `listen`, администратор не требуется ни для
чего. `requirements-build.txt` получает `cryptography` с точной версией, по
принятому в файле правилу пиновать всё.

## 18. Риски

**Ленивая отдача может не работать так, как предполагается.** Единственный риск,
способный обвалить принятое решение. Снимается спайком до начала реализации;
запасные пути названы в разделе 5.

**`cryptography` может плохо упаковываться Nuitka** из-за нативной части.
Обнаруживается тестом сборки; запасной путь — создать ключ и сертификат один раз
при первом запуске сторонним способом либо вернуться к PSK ценой привязки к
openssl-backend.

**`QClipboard` может не работать в offscreen**, что оставит backend без
автотестов на CI. Обнаруживается сразу; запасной путь — маркер и запуск на
Windows-агенте с реальной сессией.

**Реентрантность `QEventLoop` внутри `retrieveData`.** Смягчается подавлением
clipboard-событий на время отдачи; проверяется тестом, который копирует во время
незавершённой отдачи.

**Брандмауэр молча блокирует.** Смягчается отдельным обнаружением и отдельным
сообщением, а не общим «нет связи».

## 19. Открытых вопросов нет

Решения, принятые в ходе обсуждения и зафиксированные здесь: MVP только
Windows ↔ Windows; передача при вставке, а не при копировании; текст, URL и
изображения в первом выпуске, файлы во втором; один процесс с узкой
платформенной границей и запретом `QtWidgets` внутри подсистемы; `cryptography`
вместо TLS-PSK; собственный UDP-маячок вместо mDNS; парринг сравнением кода на
обеих машинах.
