valiklushnikov/input-duo/docs/superpowers/plans/2026-09-02-generic-keyboard-report-protocol.md

# Generic Keyboard Report Protocol Implementation Plan

> **For agentic workers:** REQUIRED SUB-SKILL: Use superpowers:subagent-driven-development (recommended) or superpowers:executing-plans to implement this plan task-by-task. Steps use checkbox (`- [ ]`) syntax for tracking.

**Goal:** Route ordinary USB HID keyboards in their declared report protocol so short Aula F75 receiver keystrokes are not lost, while retaining boot fallback and all existing mouse behaviour.
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
