valiklushnikov/input-duo/configurator/requirements-build.txt

# Locked build inputs for the Windows standalone build.
#
# Nothing here is a runtime dependency of the configurator itself: this file
# describes the machine that produces dist/DuoInput, so a build made six months
# from now uses the same Qt and the same compiler front end as this one.
#
# Versions are pinned exactly. Bump them deliberately, rebuild, and re-run
# configurator/tests/packaging/test_dist.py before shipping.

PySide6==6.10.1
# Qt читает ключи, но не создаёт их: сертификат узла для взаимного TLS
# генерируется здесь.
cryptography==46.0.3
Nuitka==4.1.3

# The test suite runs inside the build, so a broken build cannot be packaged.
pytest==9.1.1
pytest-qt==4.5.0
