valiklushnikov/input-duo/firmware/u1_main/ch375/device.cpp

#include "ch375/device.hpp"

#include <cstring>

namespace duo_input::u1::ch375 {

void Ch375Device::tick(std::uint32_t now_us) {
    // A command's status byte is on the wire and nobody has collected it.
    //
    // First, before even chip setup: whatever else this tick might want to do
    // begins by writing to the same port, and the chip answers in the order it
    // was asked, so the next question's byte would arrive behind this one and
    // each reader would take the other's. Collecting it is also the only way
    // to stop it being read as the answer to a command asked minutes later.
    if (pending_command_ != PendingCommand::None) {
        finish_pending_command(now_us);
        return;
    }

    // The chip is put into host mode lazily rather than in a constructor: a
    // controller that is not powered yet would otherwise fail at construction
    // time, with nowhere to report it and no way to try again.
    if (!chip_ready_ && !bring_chip_up(now_us)) {
        return;
    }

    InterruptStatus status = InterruptStatus::Success;
    const bool interrupted = poll_interrupt(status);
    if (transport_.pending_reply() == PendingReply::Status) {
        // Asked, and not answered yet. Nothing else may be said to the chip
        // until it is: the chip answers commands in the order they arrive, so
        // any command written now would be answered after this byte - and each
        // reader would take the other's. This byte is the one that says a
        // device arrived, a transaction finished, or a cable was pulled, so
        // losing it is not something a later tick can repair.
        //
        // Nothing is lost by waiting. Every deadline in this machine is an
        // absolute time, so they all still fire; the tick simply does no work
        // this pass, which costs microseconds rather than the 20 ms the
        // blocking read used to take out of the other channel.
        return;
    }
    if (interrupted) {
        last_status_ = static_cast<std::uint8_t>(status);
        const std::uint8_t raw = last_status_;
        if (raw < 0x10) {
            // DS1 5.12: 00-0F is the device-mode band. A chip in host mode
            // cannot produce one, so this is the port out of step rather than
            // the chip saying something.
            ++status_impossible_;
        } else if (status == InterruptStatus::Connect) {
            ++status_connect_;
        } else if (status == InterruptStatus::Disconnect) {
            ++status_disconnect_;
        } else if (status == InterruptStatus::Success) {
            ++status_success_;
        } else if (is_failure(status)) {
            ++status_failure_;
        }
    }

    // A disconnect outranks whatever was in progress. Anything being held on
    // the far side has to be let go, and no later step can succeed anyway.
    //
    // Except while this code is the one holding the bus down. Bringing a
    // device up means putting the bus into reset (DS1 5.9), and an attached
    // device looks gone to the chip's own detection for as long as that lasts.
    // Believing it means announcing a detach, returning to Absent, finding the
    // device again and resetting the bus again - which on the bench was a
    // mouse attaching and detaching six times over without ever coming up.
    //
    // The exemption covers the reset and the pause after it, and stops there.
    // The chip's detection is not trustworthy until frames are flowing again -
    // on the bench a device was reported gone during that pause every time,
    // and configuring it was never once reached. Past that point a disconnect
    // is somebody pulling a cable, and a missed one leaves keys held down on
    // the far side.
    const bool bringing_up =
        state_ == Ch375State::Resetting || state_ == Ch375State::HostMode;
    if (interrupted && status == InterruptStatus::Disconnect && !bringing_up) {
        ++detach_from_disconnect_;
        handle_detach(now_us);
        return;
    }

    switch (state_) {
        case Ch375State::Absent: {
            // Three questions read this one port while a channel is idle - the
            // idle re-check below, the connect poll after it, and the
            // interrupt status at the top of the tick - and the chip answers
            // in the order it was asked. So exactly one of them is outstanding
            // at a time, and each is collected by the caller that asked it.
            // Two at once means each reader takes the other's byte, which is
            // not hypothetical: it is how a CHECK_EXIST reply was read as an
            // interrupt status and a device that had just been plugged in was
            // reported as a chip that had stopped answering.

            // An idle channel re-proves its chip, not just its socket.
            //
            // Absent asks whether a device is attached and reads silence as
            // "no device". It has no way to notice that the chip stopped
            // being a configured chip at all - and a CH375 whose 5 V was
            // cycled under a running U1 is back at 9600 with no working mode,
            // deaf at the rate this side raised it to. The channel then waits
            // here for ever. There is no reset line to reach it with either
            // (docs/hardware/ch375-wiring.md), so asking is the whole of the
            // available diagnosis.
            //
            // Asked and left, like every other question put to a chip that
            // may not answer: a spin here would cost the other channel its
            // 8 ms poll window once a second.
            if (presence_probe_running_) {
                const ReplyProgress answer = transport_.poll_presence_probe();
                if (answer == ReplyProgress::Waiting) {
                    return;
                }
                presence_probe_running_ = false;
                if (answer == ReplyProgress::Answered &&
                    transport_.presence_probe_matched()) {
                    unanswered_presence_ = 0;
                    last_presence_us_ = now_us;
                } else if (++unanswered_presence_ >= kPresenceProbesBeforeLost) {
                    unanswered_presence_ = 0;
                    ++presence_lost_;
                    // Not a failure to recover from with a delay - there is
                    // nothing being held and nothing to release. Straight back
                    // through chip setup, which resets it and starts over.
                    chip_ready_ = false;
                    bring_up_ = ChipBringUp::Idle;
                    return;
                }
                // One missed byte is not a lost chip. last_presence_us_ is
                // deliberately left where it was, so the next tick asks again
                // instead of waiting another second to find out.
            }

            bool connected = interrupted && status == InterruptStatus::Connect;
            if (!connected && connect_probe_running_) {
                const ReplyProgress answer = transport_.poll_connect_probe(probed_connect_);
                if (answer == ReplyProgress::Waiting) {
                    return;
                }
                connect_probe_running_ = false;
                connected = answer == ReplyProgress::Answered &&
                            probed_connect_ == InterruptStatus::Connect;
            }
            if (!connected && !transport_.reply_outstanding()) {
                if (now_us - last_presence_us_ >= kPresenceRecheckUs) {
                    transport_.begin_presence_probe(kPortProbeByte);
                    presence_probe_running_ = true;
                    // Nothing else this tick: everything else here reads the
                    // same port and would take this question's answer.
                    return;
                }
                if (now_us - last_connect_poll_us_ >= kConnectPollUs) {
                    // Ask, rather than only waiting to be told. The
                    // announcement never comes for a device that was plugged
                    // in before the power, and it is consumed for nothing if
                    // the chip was answering nonsense when it arrived.
                    //
                    // Asked and left, like the rest: this runs every 100 ms
                    // against a chip that may be deaf, and blocking it was
                    // 20 ms out of every 100 taken from the other channel.
                    last_connect_poll_us_ = now_us;
                    transport_.begin_connect_probe();
                    connect_probe_running_ = true;
                    return;
                }
            }
            if (connected) {
                publish(Ch375EventKind::Attached);
                // A device to carry means the ladder is worth trying again.
                // Exhausting it says the chip refused every rung once, which
                // is a fact about a moment; resting at 9600 with a device on
                // the bus is a channel that provably cannot work, because one
                // report costs more time there than the hand takes to produce
                // the next.
                baud_exhausted_ = false;
                // Asked here, in mode 5, because DS2 1.2 says that is the only
                // mode the question is valid in - and the answer decides how
                // the bus has to run from now on.
                //
                // Asked and left. A device that has just arrived on a chip
                // that has stopped answering is the state the board was
                // measured in at 2026-08-29 12:06, and this is the first of
                // the two commands its 20 170 us pass was spent inside.
                transport_.begin_device_rate();
                pending_command_ = PendingCommand::DeviceRate;
            }
            return;
        }

        case Ch375State::Resetting:
            if (now_us - entered_us_ < kBusResetHoldUs) {
                return;
            }
            // Leaving mode 7 in place would hold the bus down forever, which
            // is indistinguishable from a dead port. The speed follows the
            // mode rather than preceding it, and that happens where the answer
            // is collected.
            transport_.begin_set_usb_mode(UsbMode::HostWithSof);
            pending_command_ = PendingCommand::ResetDone;
            return;

        case Ch375State::HostMode:
            if (now_us - entered_us_ < kBusSettleUs) {
                // Still coming round from the reset. See kBusSettleUs.
                return;
            }
            setup_.begin(now_us);
            enter(Ch375State::Enumerating, now_us);
            return;

        case Ch375State::Enumerating: {
            // A rung is proved by the traffic it has to carry, not by two
            // CHECK_EXIST replies. Measured by the port's real rate:
            //
            //     byRate(9600/37500/62500/115200):  ok=0/1/0/0  fail=0/0/24/24
            //
            // CHECK_EXIST answered at 115200 and 62500 and every block read
            // there failed, so the device stayed attached and never reached
            // Ready - and the ladder's only step-down runs from a device that
            // did reach Ready. That is why a channel sat at 115200 for ever.
            const std::uint32_t reads_ok = transport_.block_reads_ok();
            const std::uint32_t reads_failed = transport_.block_reads_failed();
            const SetupProgress progress = setup_.poll(now_us, interrupted, status);
            if (transport_.block_reads_ok() != reads_ok) {
                // The rate carried what it has to carry.
                block_read_failures_ = 0;
            } else if (transport_.block_reads_failed() != reads_failed) {
                block_read_failures_ = static_cast<std::uint16_t>(
                    block_read_failures_ + (transport_.block_reads_failed() - reads_failed));
                if (block_read_failures_ >= kBlockFailsBeforeStepDown) {
                    block_read_failures_ = 0;
                    step_ladder_down();
                    // The rate is chosen during chip setup and nowhere else,
                    // so the new rung only takes effect by going back through
                    // it.
                    chip_ready_ = false;
                    bring_up_ = ChipBringUp::Idle;
                    raised_baud_ = kCh375DefaultBaud;
                    ++enumerate_failures_;
                    handle_detach(now_us);
                    fail(now_us);
                    return;
                }
            }
            if (progress == SetupProgress::Busy) {
                return;
            }
            if (progress == SetupProgress::Failed) {
                ++enumerate_failures_;
                // SET_RETRY may still have the chip repeating the failed
                // control transfer after our setup deadline. End that exact
                // transaction before recovery sends a mode command; do not do
                // this from generic fail(), which is also reached when the
                // serial rate has not been proved safe for any command.
                transport_.abort_nak();
                fail(now_us);
                return;
            }
            endpoint_ = setup_.interrupt_endpoint();
            auxiliary_endpoint_ = setup_.auxiliary_endpoint();
            secondary_auxiliary_endpoint_ = setup_.secondary_auxiliary_endpoint();
            // A new device starts its data toggle at DATA0, and the chip has
            // to be told - it does not track this itself (DS2 1.6). Without
            // it the first IN transaction never completes: no data, no error,
            // and no interrupt, which on the bench was 120 polls in a row
            // producing nothing at all.
            expect_data1_ = false;
            auxiliary_expect_data1_ = false;
            secondary_auxiliary_expect_data1_ = false;
            token_slot_ = 0;
            poll_slot_count_ = static_cast<std::uint8_t>(
                1 + (auxiliary_endpoint_ != 0 ? 1 : 0) +
                (secondary_auxiliary_endpoint_ != 0 ? 1 : 0));
            poll_primary_next_ = true;
            next_auxiliary_slot_ = 1;
            largest_report_ = 0;
            transport_.set_receive_toggle(kToggleData0);
            // The control transfers are over and the polling begins, so the
            // NAK changes meaning: from a device that is busy to one that has
            // nothing to say, which is what a HID device says between the
            // keystrokes and the movements. Waiting that out on the bus is a
            // transaction that never finishes and an interrupt that is never
            // raised, and a second of those was a keyboard declared lost for
            // being idle. Reported, it is the evidence that the device is
            // still there.
            //
            // Here rather than after the working mode, because no mode is
            // taken between this point and the first poll: the modes are all
            // behind it, and the policy they undo is the enumeration's.
            transport_.set_retry(kRetryReportNak);
            // A device that got this far fetched every descriptor over this
            // rate, so the rung is proved.
            block_read_failures_ = 0;
            enter(Ch375State::Ready, now_us);
            last_answer_us_ = now_us;
            token_outstanding_ = false;
            failed_polls_ = 0;
            relights_ = 0;
            if (!announced_ready_) {
                // Once per device, not once per attempt: a controller that
                // needed three tries still produced one working keyboard, and
                // saying so three times would be three keyboards.
                publish(Ch375EventKind::Ready);
                announced_ready_ = true;
            }
            last_poll_us_ = now_us;
            return;
        }

        case Ch375State::Ready: {
            if (interrupted) {
                // The transaction this token started has finished, whatever it
                // came to.
                token_outstanding_ = false;
                // Whether it finished as evidence that the device is still
                // there is a different question. A NAK is a device answering
                // that it has nothing to say, which every HID device does
                // between the keys and the movements, and a keyboard nobody is
                // typing on answers nothing else for hours.
                if (status == InterruptStatus::Success ||
                    (is_failure(status) && failure_response(status) == kResponseNak)) {
                    last_answer_us_ = now_us;
                    failed_polls_ = 0;
                } else {
                    ++failed_polls_;
                }
            }
            // A second without that evidence, and at least one poll that
            // actually failed in it. Both, because an absence of data is not
            // an absence of device: the polls have to have been issued and
            // gone unanswered, or this fires for a channel whose ticks went to
            // the other one's recovery and for a device that was answering the
            // whole time.
            if (now_us - last_answer_us_ >= kDeviceLostUs && failed_polls_ > 0) {
                // Quiet for a second with a device configured. That is not the
                // same as the device being gone - the controller has said
                // nothing about a disconnection - and the two have been
                // treated alike, at a cost the operator can see.
                //
                // Tearing the chip and the bus down re-enumerates the
                // peripheral: its lights go out and come back, and every key
                // or button held on it is released and re-acquired. Doing that
                // for a transient silence is a fault of its own, and on this
                // bench it is the fault the operator actually notices.
                //
                // So the endpoint is re-armed first. Setting the receive
                // toggle back to DATA0 and polling again costs four bytes and
                // recovers the case that is actually common: one transaction
                // lost, and the two ends one packet out of step over it.
                if (relights_ < kQuietRetriesBeforeTeardown) {
                    ++relights_;
                    ++quiet_rearms_;
                    expect_data1_ = false;
                    transport_.set_receive_toggle(kToggleData0);
                    transport_.set_retry(kRetryReportNak);
                    token_outstanding_ = false;
                    last_answer_us_ = now_us;
                    failed_polls_ = 0;
                    return;
                }

                // It has had its chances. Whatever it was holding would be
                // held forever otherwise: releasing a key nobody pressed is a
                // nuisance, and holding one nobody can release is not.
                ++detach_from_lost_;

                // A rate that shook hands and then dropped the link is not a
                // rate this channel has. Two CHECK_EXIST replies prove the
                // divider; they say nothing about whether the wire holds up
                // under seventeen hundred transactions, and on this bench it
                // did not - it ran, then fell over, and every fall costs the
                // operator a peripheral that goes dark and comes back.
                //
                // So the ladder is walked by what actually survives. Down a
                // rung on every collapse, but not below the floor: at the
                // bottom this used to go off the ladder entirely and park the
                // port at 9600, where the channel provably cannot carry the
                // traffic, so it collapsed harder and never came back.
                if (raised_baud_ != kCh375DefaultBaud) {
                    ++collapses_while_raised_;
                    step_ladder_down();
                    // raised_baud_ is deliberately left alone, but not for
                    // the reason this note used to give. It said the value was
                    // the only record of where the chip had been put and the
                    // one thing the recovery needed - which was true of
                    // recover_from, and recover_from was deleted in repair 2.
                    // The search walks the home rate and every rung, so it
                    // needs no hint about where to look.
                    //
                    // What is still true is the comparison above: raised_baud_
                    // says whether this channel had climbed off the default at
                    // all, and only a link that had is one whose collapse
                    // should cost it a rung.
                }

                handle_detach(now_us);
                fail(now_us);
                chip_ready_ = false;
                return;
            }
            if (interrupted && status == InterruptStatus::Success) {
                std::uint8_t buffer[kMaxBlockSize];
                std::size_t size = 0;
                if (transport_.read_block(buffer, sizeof(buffer), size) && size > 0) {
                    if (token_slot_ == 0) {
                        publish_report(buffer, size, now_us);
                    } else {
                        const std::uint8_t source_endpoint =
                            token_slot_ == 1 ? auxiliary_endpoint_
                                             : secondary_auxiliary_endpoint_;
                        publish_auxiliary_report(source_endpoint, buffer, size, now_us);
                    }
#if DUO_CH375_PROBE
                    if (token_slot_ != 0) {
                        const unsigned auxiliary = static_cast<unsigned>(token_slot_ - 1);
                        if (auxiliary < 2) {
                            ++auxiliary_probe_count_[auxiliary];
                            auxiliary_probe_previous_size_[auxiliary] =
                                auxiliary_probe_last_size_[auxiliary];
                            std::memcpy(auxiliary_probe_previous_[auxiliary],
                                        auxiliary_probe_last_[auxiliary],
                                        auxiliary_probe_last_size_[auxiliary]);
                            const std::size_t keep =
                                size < sizeof(auxiliary_probe_last_[auxiliary])
                                    ? size
                                    : sizeof(auxiliary_probe_last_[auxiliary]);
                            auxiliary_probe_last_size_[auxiliary] =
                                static_cast<std::uint8_t>(keep);
                            std::memcpy(auxiliary_probe_last_[auxiliary], buffer, keep);

                            const unsigned trace_slot = auxiliary_probe_trace_next_[auxiliary];
                            const std::size_t trace_keep =
                                size < sizeof(auxiliary_probe_trace_[auxiliary][trace_slot])
                                    ? size
                                    : sizeof(auxiliary_probe_trace_[auxiliary][trace_slot]);
                            auxiliary_probe_trace_size_[auxiliary][trace_slot] =
                                static_cast<std::uint8_t>(trace_keep);
                            std::memcpy(auxiliary_probe_trace_[auxiliary][trace_slot], buffer,
                                        trace_keep);
                            auxiliary_probe_trace_next_[auxiliary] = static_cast<std::uint8_t>(
                                (trace_slot + 1) % kAuxiliaryTraceDepth);
                            if (auxiliary_probe_trace_count_[auxiliary] < kAuxiliaryTraceDepth) {
                                ++auxiliary_probe_trace_count_[auxiliary];
                            }
                        }
                    }
#endif
                }
                // One transaction succeeded, so the device will send the other
                // packet type next. Told only after a success: a transaction
                // that failed did not consume anything, and moving the toggle
                // anyway would leave the two ends permanently one apart.
                if (token_slot_ == 1) {
                    auxiliary_expect_data1_ = !auxiliary_expect_data1_;
                } else if (token_slot_ == 2) {
                    secondary_auxiliary_expect_data1_ =
                        !secondary_auxiliary_expect_data1_;
                } else {
                    expect_data1_ = !expect_data1_;
                }
            }
            if (now_us - last_poll_us_ < token_interval_us()) {
                return;
            }
            // One token at a time. Giving the controller another before it has
            // answered the last is talking over it: it is running a real USB
            // transaction and raises its interrupt when that finishes, so a
            // token fired on a timer regardless lands in the middle of one.
            // On the bench that was a hundred and twenty-five tokens producing
            // seven interrupts, and then a device declared lost for the
            // silence they were causing.
            //
            // Unless the answer is simply not coming. Waiting for a lost
            // interrupt for ever would leave the device unpolled for good,
            // which looks like a mouse that stopped rather than a link that
            // dropped one reply.
            if (token_outstanding_ && now_us - token_at_us_ < kTokenAnswerUs) {
                return;
            }
            if (token_outstanding_) {
                // Asked, and the controller never came back. That is a poll
                // that failed rather than a device with nothing to say.
                ++failed_polls_;
            }
            last_poll_us_ = now_us;
            token_outstanding_ = true;
            token_at_us_ = now_us;
            // The routed endpoint gets every other token. Between those, all
            // auxiliary endpoints rotate: Keychron is 2,4,2,1. This preserves
            // the smooth pointer without ever abandoning either queue which
            // carries its side-button notification.
            if (poll_slot_count_ == 1) {
                token_slot_ = 0;
            } else if (poll_primary_next_) {
                token_slot_ = 0;
                poll_primary_next_ = false;
            } else {
                token_slot_ = next_auxiliary_slot_;
                next_auxiliary_slot_ =
                    poll_slot_count_ == 3 && next_auxiliary_slot_ == 1 ? 2 : 1;
                poll_primary_next_ = true;
            }
            const bool data1 = token_slot_ == 0
                                   ? expect_data1_
                                   : (token_slot_ == 1 ? auxiliary_expect_data1_
                                                       : secondary_auxiliary_expect_data1_);
            transport_.set_receive_toggle(data1 ? kToggleData1 : kToggleData0);
            // Ask the device whether it has anything. The answer arrives as an
            // interrupt, which the next tick picks up - nothing waits here.
            ++polls_issued_;
            if (token_slot_ == 0) {
                ++primary_polls_;
            }
            const std::uint8_t poll_endpoint =
                token_slot_ == 0 ? endpoint_
                                 : (token_slot_ == 1 ? auxiliary_endpoint_
                                                     : secondary_auxiliary_endpoint_);
            transport_.issue_token(poll_endpoint, TokenPid::In);
            return;
        }

        case Ch375State::RecoverWait:
            if (now_us - entered_us_ < kRecoverDelayUs) {
                return;
            }
            // Start the whole sequence again from the bus reset. Picking up
            // where it left off would carry the broken state along with it.
            //
            // This is the recovery loop of a channel that is already unwell,
            // so it is the one place the mode command is most likely to go
            // unanswered - and it runs once a second for as long as the fault
            // lasts.
            transport_.begin_set_usb_mode(UsbMode::HostReset);
            pending_command_ = PendingCommand::RecoverMode;
            return;

        case Ch375State::Fault:
            return;
    }
}

bool Ch375Device::bring_chip_up(std::uint32_t now_us) {
    switch (bring_up_) {
        case ChipBringUp::Idle:
            if (state_ == Ch375State::RecoverWait && now_us - entered_us_ < kRecoverDelayUs) {
                // Still counting down. Retrying flat out would hammer a
                // controller that is already unhappy, every tick, forever.
                return false;
            }
            // Start from a chip that is definitely idle. Whatever state the
            // last run left it in - including ones it does not leave by itself
            // - is gone after this, and the wait is the price.
            transport_.reset_all();
            chip_reset_at_us_ = now_us;
            // A status the chip is already holding is asked for now and
            // thrown away when it arrives. Left standing it would be
            // delivered as the answer to the next question, which is how a
            // device that has already gone gets configured.
            //
            // The wait for it runs inside the chip's own restart, which is
            // 60 ms this has to sit out anyway, so nothing is lost by
            // collecting it on a later tick - and a chip holding its line
            // down and answering nothing no longer costs the other channel
            // 20 ms of it.
            bring_up_ = transport_.begin_status_drain() ? ChipBringUp::Draining
                                                        : ChipBringUp::Resetting;
            return false;

        case ChipBringUp::Draining: {
            InterruptStatus discarded = InterruptStatus::Success;
            if (transport_.poll_status_read(discarded) == ReplyProgress::Waiting) {
                return false;
            }
            // Whatever it was, it belonged to whatever the chip was doing
            // before the reset. Answered or timed out, the port is free again.
            bring_up_ = ChipBringUp::Resetting;
            return false;
        }

        case ChipBringUp::Resetting:
            if (now_us - chip_reset_at_us_ < kChipResetUs) {
                return false;
            }
            // The chip has just come back from RESET_ALL, which returns its
            // port to 9600 whatever it was doing before. This side has to go
            // back with it before anything can be said at all.
            transport_.reset_port_speed(kCh375DefaultBaud);

            // Nothing is said to the chip until it has said something first.
            //
            // CHECK_EXIST is one command and one data byte and it proves the
            // port by construction (DS1 5.5), so it is the cheapest thing that
            // can be wrong. A mode command sent to a controller that is still
            // coming back from its reset is read as part of that restart, and
            // then every byte after it is out of step - a chip that worked a
            // second ago and now answers nothing at all.
            //
            // Asked and left. The answer is picked up on a later tick, because
            // a chip that is not coming back would otherwise hold this core
            // for 20 ms while the other channel's endpoint goes unpolled.
            transport_.begin_presence_probe(kPortProbeByte);
            bring_up_ = ChipBringUp::Probing;
            return false;

        case ChipBringUp::Probing: {
            const ReplyProgress progress = transport_.poll_presence_probe();
            if (progress == ReplyProgress::Waiting) {
                return false;
            }
            if (progress == ReplyProgress::Answered && transport_.presence_probe_matched()) {
                unanswered_probes_ = 0;
                // Mode 5 is where DS1 5.9 says to wait: enabled, generating no
                // frames, watching for a device by itself. Asked and left -
                // this is a chip that has answered exactly one probe, and the
                // blocking form spent a whole reply timeout on the ones that
                // answer a probe and then nothing else.
                transport_.begin_set_usb_mode(UsbMode::HostNoSof);
                bring_up_ = ChipBringUp::Moding;
                return false;
            }
            ++chip_not_back_yet_;
            bring_up_ = ChipBringUp::Idle;

            // Silent at the rate it should have come back to. If this code had
            // raised it, that is where it may still be - the reset was sent at
            // a rate it had stopped holding, so it never heard it. And there
            // is no other way to reach it: this board wires RXD, TXD and INT
            // to each CH375 and no reset line (docs/hardware/ch375-wiring.md),
            // so a chip that stops listening cannot be told anything except
            // over the port it has stopped listening on.
            //
            // Not on the first silence, because the search writes at rates the
            // chip may not be using and a half-heard byte swallows the command
            // after it. After this many, the channel is already unreachable.
            if (++unanswered_probes_ >= kProbesBeforeChipSearch) {
                unanswered_probes_ = 0;
                transport_.begin_chip_search(kCh375DefaultBaud);
                bring_up_ = ChipBringUp::Searching;
                return false;
            }
            fail(now_us);
            return false;
        }

        case ChipBringUp::Searching: {
            const SearchProgress found = transport_.poll_chip_search();
            if (found == SearchProgress::Waiting) {
                return false;
            }
            if (found != SearchProgress::Found) {
                // It answered nowhere. A chip in that state transmits nothing
                // at any rate, and on this board nothing else can be done to
                // it - which is why the wiring note asks for a GPIO on RSTI.
                bring_up_ = ChipBringUp::Idle;
                fail(now_us);
                return false;
            }

            const unsigned at = transport_.chip_search_found_at();
            bring_up_ = ChipBringUp::Resetting;
            if (at == kCh375DefaultBaud) {
                // It was at home after all, merely slow to answer. Nothing was
                // reset, so there is nothing to wait out.
                chip_reset_at_us_ = now_us - kChipResetUs;
                return false;
            }
            ++chip_found_elsewhere_;
            chip_found_at_ = at;
            raised_baud_ = kCh375DefaultBaud;
            // It was reset where it was found, so it needs the wait every
            // reset needs before anything else is said to it.
            chip_reset_at_us_ = now_us;
            return false;
        }

        case ChipBringUp::Moding: {
            const ReplyProgress progress = transport_.poll_command_status();
            if (progress == ReplyProgress::Waiting) {
                return false;
            }
            if (progress != ReplyProgress::Answered ||
                !transport_.command_status_succeeded()) {
                // Counted. Without this the channel can spin here forever with
                // every reading frozen, which looks from outside exactly like a
                // board that has stopped running - and cost an evening of being
                // read as one.
                ++setup_mode_failures_;

                // What it answered, not merely that it refused. A chip that
                // takes CHECK_EXIST and refuses a mode is a different fault
                // from one that is deaf, and the two have looked identical
                // from out here all along: both are just a channel that does
                // nothing.
                mode_reply_ = transport_.last_status_reply();
                mode_answered_ = transport_.last_status_answered();

                bring_up_ = ChipBringUp::Idle;
                if (transport_.check_exist(kPortProbeByte)) {
                    ++alive_but_refusing_;
                }

                // Nothing else is sent. Searching for the chip at other rates,
                // flushing it with filler and sweeping the receiver all write
                // bytes at rates it may not be using, and each of those can
                // wedge a chip that was about to come good on its own.
                fail(now_us);
                return false;
            }
            return finish_chip_setup(now_us);
        }
    }

    return false;
}

bool Ch375Device::finish_chip_setup(std::uint32_t now_us) {
    bring_up_ = ChipBringUp::Idle;

    // The chip's own default is to retry a NAK for ever (DS2 1.3). A device
    // that stops answering would then hold the chip inside a single
    // transaction with nothing able to end it. Waiting one out is what the
    // control transfers ahead of this need; ending is what everything else
    // does.
    transport_.set_retry(kRetryWaitOutNak);

    // Only now is the rate raised - after the chip has proved it is alive by
    // taking a mode command.
    //
    // This is still synchronous. On hardware a successful try_speed costs
    // about 67 ms in this tick: one SET_BAUD_RATE answer, two CHECK_EXIST
    // proofs and the port's mandated rate-change sleeps. The Resetting step
    // also paid about 3.5 ms to return the local port to 9600. This is bounded
    // attach/recovery work, but it does exceed the other channel's 8 ms poll
    // period; do not describe this state machine as latency-safe per tick.
    //
    // At 9600 one mouse report costs fifteen bytes of eleven bits each:
    // seventeen milliseconds for something a moving hand produces every eight.
    // The deficit never closes while the hand keeps moving, and the peripheral
    // is reset and re-enumerated for a silence this side is causing. That is
    // the fault this exists to fix.
    //
    // But asking costs a write at a rate the chip may not be using, and a chip
    // that half-hears one stops answering entirely. Asked before the chip had
    // answered anything, that barrage met every dead channel once a second -
    // including the freshly powered one somebody had just walked over to
    // revive, wedged again before they got back to their chair. A chip that
    // has just accepted a mode command is not in that state, and is the only
    // kind worth asking.
    if (!baud_exhausted_) {
        // Remembered, because it is the only other place the chip can be.
        raised_baud_ = transport_.try_speed(kBaudLadder[baud_rung_], kCh375DefaultBaud);
        // A rung that has not carried a block read has not been proved by
        // anything that matters yet.
        block_read_failures_ = 0;
        if (raised_baud_ == kCh375DefaultBaud) {
            ++baud_change_failures_;
            if (baud_rung_ + 1 < kBaudLadderSize) {
                ++baud_rung_;
            } else {
                // The chip refused every rung. Nothing here can make it move,
                // and 9600 is what is left.
                baud_exhausted_ = true;
            }
        }
    }
    chip_ready_ = true;
    enter(Ch375State::Absent, now_us);
    last_connect_poll_us_ = now_us - kConnectPollUs;
    // The chip has just proved itself, so the idle re-check starts its clock
    // here rather than firing immediately on a chip that answered a moment ago.
    last_presence_us_ = now_us;
    presence_probe_running_ = false;
    connect_probe_running_ = false;
    unanswered_presence_ = 0;
    return true;
}

bool Ch375Device::poll_interrupt(InterruptStatus& status) {
    // The answer to a status already asked for, if it has arrived.
    //
    // True only on the tick the byte is in hand. Asking and waiting inside one
    // tick is what this replaced: on hardware a channel whose device was
    // attached and stuck before Ready held INT asserted and answered nothing,
    // so the pass round Core 1's loop measured 20 168 us - one whole reply
    // timeout - and the other channel lost two and a half poll windows to it
    // every tick.
    if (transport_.pending_reply() == PendingReply::Status) {
        const ReplyProgress progress = transport_.poll_status_read(status);
        if (progress == ReplyProgress::Waiting) {
            return false;
        }
        if (progress == ReplyProgress::Answered) {
            return true;
        }
        ++status_reads_failed_;
        return false;
    }

    // Somebody else's byte is already on its way.
    //
    // The presence probe and the connect poll read this same port, and the
    // chip answers in the order it was asked. GET_STATUS written now would be
    // answered *after* their byte, so this reader would take theirs and they
    // would take the status. That is not hypothetical: a CHECK_EXIST reply
    // sitting in the receive FIFO was read here as an interrupt status, the
    // Connect it displaced was then read as the probe's answer, and a healthy
    // chip whose device had just been plugged in was declared lost and put
    // through the whole of chip setup again.
    //
    // Their questions have deadlines of their own, so this only ever waits for
    // as long as one unanswered reply takes to expire.
    if (transport_.reply_outstanding()) {
        return false;
    }

    // Reading the status is what clears the chip's request, so this is only
    // done when the line is actually asserted. Asking otherwise would consume
    // a status that belongs to nothing.
    if (!transport_.interrupt_pending()) {
        return false;
    }
    ++interrupts_seen_;
    transport_.begin_status_read();
    return false;
}

void Ch375Device::finish_pending_command(std::uint32_t now_us) {
    if (pending_command_ == PendingCommand::DeviceRate) {
        // Not a status byte, so it has its own collector.
        bool low_speed = false;
        const ReplyProgress rate = transport_.poll_device_rate(low_speed);
        if (rate == ReplyProgress::Waiting) {
            return;
        }
        pending_command_ = PendingCommand::None;
        if (rate != ReplyProgress::Answered) {
            // Silence is not full speed. Folding the two together is how a
            // low-speed mouse gets addressed at eight times its rate, answers
            // nothing, and is reported gone - and it would be done here on the
            // strength of a chip that has just failed to answer at all, which
            // is a channel to recover rather than a bus to configure.
            device_rate_known_ = false;
            fail(now_us);
            return;
        }
        device_is_low_speed_ = low_speed;
        device_rate_known_ = true;
        // DS1 5.9: mode 7 first, then mode 6. Mode 7 holds the bus in reset
        // and keeps holding it, so it is a step, not a state to rest in.
        transport_.begin_set_usb_mode(UsbMode::HostReset);
        pending_command_ = PendingCommand::AttachMode;
        return;
    }

    const ReplyProgress progress = transport_.poll_command_status();
    if (progress == ReplyProgress::Waiting) {
        return;
    }
    const PendingCommand who = pending_command_;
    pending_command_ = PendingCommand::None;
    // A question that timed out is not a command that was taken. Nothing below
    // may read silence as agreement: a chip that never heard the mode is still
    // in whatever mode it was in, and going on would run a bus reset against a
    // controller that is not in host mode at all.
    const bool taken =
        progress == ReplyProgress::Answered && transport_.command_status_succeeded();

    switch (who) {
        case PendingCommand::AttachMode:
            if (!taken) {
                ++mode_failures_;
                fail(now_us);
                return;
            }
            enter(Ch375State::Resetting, now_us);
            return;

        case PendingCommand::ResetDone:
            if (!taken) {
                fail(now_us);
                return;
            }
            // After the mode, never before: setting a working mode puts the
            // bus back to 12 Mbps (DS2 1.1). A low-speed device addressed at
            // full speed says nothing, and a controller reports something that
            // says nothing as gone.
            transport_.set_usb_speed(device_is_low_speed_ ? UsbSpeed::Low1_5Mbps
                                                          : UsbSpeed::Full12Mbps);
            // And with it the retry policy, for the same reason and on the
            // same evidence: the one set during chip setup is two working
            // modes ago by the time this device is enumerated, and a mode is
            // where the other per-transaction setting is already known to be
            // undone.
            //
            // Everything between here and Ready is a control transfer, and a
            // NAK to one of those means "busy, ask again". The chip is what
            // asks. Reporting it here instead was fifty-five setup attempts
            // that all ended 0x2A on a mouse that had enumerated the day
            // before.
            transport_.set_retry(kRetryWaitOutNak);
            enter(Ch375State::HostMode, now_us);
            return;

        case PendingCommand::RecoverMode:
            if (!taken) {
                // Still unhappy. Wait out another delay rather than spinning,
                // and go back through chip setup: a controller this broken may
                // have lost its mode entirely.
                ++recover_mode_failures_;
                chip_ready_ = false;
                entered_us_ = now_us;
                return;
            }
            enter(Ch375State::Resetting, now_us);
            return;

        case PendingCommand::DeviceRate:
        case PendingCommand::DetachMode:
        case PendingCommand::None:
            // Collected so that it is not read as somebody else's answer, and
            // otherwise of no interest: there is nothing left to configure.
            return;
    }
}

void Ch375Device::handle_detach(std::uint32_t now_us) {
    const bool had_device = state_ != Ch375State::Absent;
    detach_state_ = state_;

    // Whatever question was on the wire belongs to nobody now.
    //
    // Before the transport had one slot for it, this cleared its own flag and
    // left the byte: the mode command below reads the same port, so an
    // abandoned probe's answer was read as the mode's reply - and the chip's
    // real reply as the answer to the command after that. The return value was
    // not even looked at, so nothing could have noticed.
    transport_.abandon_reply();
    presence_probe_running_ = false;
    connect_probe_running_ = false;

    // Back to the mode this waits in. Mode 5 is where DS1 5.9 says to sit with
    // nothing attached, and DS2 1.2 says it is the only mode in which the chip
    // can be asked how fast a device is. Left in mode 6, that question returns
    // nonsense - and a low-speed mouse read as full speed is addressed at
    // eight times its rate, answers nothing, and is reported gone.
    //
    // Not asked at all when the chip is on its way back through setup: it is
    // about to be reset, so the mode would not survive, and its status byte
    // would still be crossing the wire when RESET_ALL went out.
    //
    // Nothing here reads that byte for its content, but somebody has to read
    // it: one left in the receive FIFO becomes the answer to the next question
    // asked, and to the one after that.
    if (chip_ready_) {
        transport_.begin_set_usb_mode(UsbMode::HostNoSof);
        pending_command_ = PendingCommand::DetachMode;
    }
    device_is_low_speed_ = false;
    device_rate_known_ = false;
    endpoint_ = 0;
    announced_ready_ = false;
    // The chip answered a mode command just now, so the idle re-check has
    // nothing to establish for another interval.
    unanswered_presence_ = 0;
    last_presence_us_ = now_us;
    enter(Ch375State::Absent, now_us);
    if (had_device) {
        publish(Ch375EventKind::Detached);
    }
}

std::uint32_t Ch375Device::poll_interval_us() const {
    return report_poll_interval_us(packet_bytes(), transport_.port_baud());
}

std::uint32_t Ch375Device::token_interval_us() const {
    const std::uint8_t slots = poll_slot_count_ == 0 ? 1 : poll_slot_count_;
    return poll_interval_us() / slots;
}

std::size_t Ch375Device::packet_bytes() const {
    // wMaxPacketSize is a ceiling. Once a primary report has arrived, use the
    // largest size actually observed; otherwise a Keychron 64-byte endpoint
    // carrying eight bytes remains needlessly limited after its other two IN
    // endpoints are added to the schedule.
    if (largest_report_ != 0) {
        return largest_report_;
    }
    return setup_.max_packet() != 0 ? static_cast<std::size_t>(setup_.max_packet())
                                    : kAssumedPacketBytes;
}

std::size_t Ch375Device::slowest_usable_rung() const {
    const std::size_t packet = packet_bytes();
    // The *slowest* interval, deliberately. The floor says which rungs a
    // collapse may fall to, and every rung that can carry a report inside the
    // interval it will actually be polled at is one of them. Reading it off
    // the fastest interval instead would leave 115200 the only rung clearing
    // it, which is the whole ladder gone for the sake of a constant.
    const unsigned floor = report_rate_floor(packet, kSlowestReportPollUs);
    // Fastest first, so the last rung still at or above the floor is the
    // slowest usable one. Rung zero if none of them clears it, which keeps a
    // channel on the fastest rate there is rather than the slowest.
    std::size_t slowest = 0;
    for (std::size_t index = 0; index < kBaudLadderSize; ++index) {
        if (kBaudLadder[index].baud >= floor) {
            slowest = index;
        }
    }
    return slowest;
}

void Ch375Device::step_ladder_down() {
    const std::size_t slowest = slowest_usable_rung();
    if (baud_rung_ < slowest) {
        ++baud_rung_;
        return;
    }
    // The bottom of the usable band, and there is nowhere below it to go.
    //
    // The old rule stepped down on every collapse and, at the bottom, set
    // baud_exhausted_ and left the port at 9600 for good. On the bench that is
    // exactly what happened - three collapses, then baud=9600 - and its
    // premise is false for this device: the slower rate does not drop less, it
    // cannot carry the traffic at all, so it collapses harder, which stepped
    // the ladder down again. Collapse, slower, more collapse, 9600 for ever.
    baud_rung_ = slowest;
}

void Ch375Device::fail(std::uint32_t now_us) {
    enter(Ch375State::RecoverWait, now_us);
}

void Ch375Device::enter(Ch375State state, std::uint32_t now_us) {
    state_ = state;
    entered_us_ = now_us;
}

void Ch375Device::request_reenumeration() {
    if (state_ == Ch375State::Absent || state_ == Ch375State::Fault) {
        // Nothing is attached, so there is nothing to configure. Resetting a
        // bus with nothing on it every time the configurator asked would be
        // work that cannot succeed.
        return;
    }
    announced_ready_ = false;
    // Straight to the recovery path with no delay left to run: it already
    // does exactly this sequence, and having one route to it means one place
    // where it can be wrong.
    state_ = Ch375State::RecoverWait;
    entered_us_ -= kRecoverDelayUs;
}

void Ch375Device::publish(Ch375EventKind kind) {
    Ch375Event event;
    event.kind = kind;
    event.report_size = 0;

    if (count_ == kEventQueueDepth) {
        // The queue is full, so the oldest goes. Dropping the newest instead
        // would mean a detach could be lost behind a backlog of reports, and
        // that is the one event that must not be: it is what releases keys.
        head_ = (head_ + 1) % kEventQueueDepth;
        --count_;
    }
    events_[(head_ + count_) % kEventQueueDepth] = event;
    ++count_;
}

void Ch375Device::publish_report(const std::uint8_t* data, std::size_t size,
                                std::uint32_t now_us) {
    Ch375Event event;
    event.kind = Ch375EventKind::Report;
    event.received_us = now_us;
    event.report_size = size > kMaxBlockSize ? kMaxBlockSize : size;
    std::memcpy(event.report, data, event.report_size);
    if (event.report_size > largest_report_) {
        largest_report_ = static_cast<std::uint16_t>(event.report_size);
    }

    if (count_ == kEventQueueDepth) {
        head_ = (head_ + 1) % kEventQueueDepth;
        --count_;
    }
    events_[(head_ + count_) % kEventQueueDepth] = event;
    ++count_;
}

void Ch375Device::publish_auxiliary_report(std::uint8_t endpoint, const std::uint8_t* data,
                                           std::size_t size, std::uint32_t now_us) {
    Ch375Event event;
    event.kind = Ch375EventKind::AuxiliaryReport;
    event.endpoint = endpoint;
    event.received_us = now_us;
    event.report_size = size > kMaxBlockSize ? kMaxBlockSize : size;
    std::memcpy(event.report, data, event.report_size);

    if (count_ == kEventQueueDepth) {
        head_ = (head_ + 1) % kEventQueueDepth;
        --count_;
    }
    events_[(head_ + count_) % kEventQueueDepth] = event;
    ++count_;
}

bool Ch375Device::take_event(Ch375Event& event) {
    if (count_ == 0) {
        return false;
    }
    event = events_[head_];
    head_ = (head_ + 1) % kEventQueueDepth;
    --count_;
    return true;
}

}  // namespace duo_input::u1::ch375
