valiklushnikov/input-duo/firmware/u1_main/spi_master.hpp

#pragma once

// U1's half of the link to U2.
//
// U1 is the master: it decides when a transfer happens, so U2 never has to
// guess. Every transfer is exactly one 64-byte frame, which means the slave
// always knows how much to expect and a truncated transfer is visibly wrong
// rather than silently short.
//
// A frame is sent when the state changed, and a heartbeat goes out whenever
// nothing has been sent for a while. That second part is what keeps U2's
// watchdog alive during a pause in typing - without it, a quiet minute would
// look exactly like a severed cable.

#include <cstdint>

#include "hid/types.hpp"
#include "link/spi_protocol.hpp"
#include "protocol/generated.hpp"

namespace duo_input::u1 {

/// The four wires, as they are laid out on the board.
inline constexpr unsigned kPinSpiRx = 8;    // MISO, from U2
inline constexpr unsigned kPinSpiCs = 9;    // chip select, driven by U1
inline constexpr unsigned kPinSpiSck = 10;  // clock, driven by U1
inline constexpr unsigned kPinSpiTx = 11;   // MOSI, to U2

/// 1 MHz. A 64-byte frame therefore occupies 512 us of the bus, which is why
/// frames are sent on change rather than continuously.
inline constexpr unsigned kSpiBaudRate = 1'000'000;

/// Every transfer is this long, in both directions.
inline constexpr std::size_t kFrameSize = protocol::ProtocolLimits::SPI_FRAME_SIZE;

/// Send a heartbeat if nothing else has gone out for this long. Comfortably
/// inside U2's 100 ms timeout, with room for several to be lost in a row.
inline constexpr std::uint32_t kHeartbeatIntervalMs = 20;

/// What U2 said about itself in the last transfer.
struct EndpointStatus {
    bool answered = false;
    bool mounted = false;
    std::uint32_t crc_errors = 0;
    /// How many times U2 has lost the link and released everything.
    ///
    /// U2 counts this because U1 cannot: at the moment the link dies there is
    /// nothing left to carry the news. It arrives on the way back.
    std::uint8_t endpoint_drops = 0;

    /// The silence that caused U2's most recent release, in milliseconds.
    ///
    /// This is the 100 ms fail-safe reporting on itself from real hardware.
    std::uint16_t endpoint_release_ms = 0;

    /// Frames U1 received that only U1 could have sent.
    ///
    /// Non-zero means the outgoing line is reaching the incoming one, which no
    /// correct wiring does. It is worth counting separately from a CRC error
    /// because it is a different fault with the same symptom, and because the
    /// frames arrive perfectly intact - the CRC will never report it.
    std::uint32_t echoed_frames = 0;
};

class SpiMaster {
public:
#if DUO_SPI_DEBUG
    /// Bring-up only: run the SPI block against itself, no pins involved.
    ///
    /// The PL022 can connect its transmit shifter to its receive shifter
    /// inside the chip. What comes back proves the peripheral, the clock
    /// divider and the frame format on their own - and because the pads are
    /// bypassed, a result here says nothing about the wiring, which is
    /// exactly what makes it useful: it separates the two.
    static void internal_loopback(const std::uint8_t* tx, std::uint8_t* rx, std::size_t size);

    /// Bring-up only: drive the three outgoing lines and watch the incoming one.
    ///
    /// With U2 mirroring the parity of what it receives, every one of the four
    /// wires appears in the answer. Eight combinations are driven and the
    /// observed bits returned, one per bit, lowest first.
    ///
    /// Call before begin(), which hands the pins to the SPI block.
    static std::uint8_t wire_walk();

    /// Bring-up only: be the master by hand, one bit at a time.
    ///
    /// Drives chip select, clock and the outgoing line as ordinary pins and
    /// samples the incoming one, at microsecond speed rather than a megahertz.
    /// It depends on nothing in this chip's SPI block, so what comes back is
    /// U2's slave answering or U2's slave not answering, with no third
    /// explanation left.
    ///
    /// Call before begin(), which hands the pins back to the SPI block.
    static void bitbang_probe(std::uint8_t* rx, std::size_t count, unsigned half_period_us);
#endif

    /// Claim SPI1 and the four pins. Call once.
    void begin();

    /// Send whatever PC2 needs to know, if anything.
    ///
    /// Returns whether a frame went out. Called every loop; it sends only when
    /// the state changed or the heartbeat is due, so an idle device is quiet.
    ///
    /// ``source`` is anything that answers ``snapshot`` and ``take_snapshot``
    /// - the command runtime on hardware, a recorder in tests - and this asks
    /// it for the movement only on the branch that actually hands a mouse
    /// frame to the link. Consuming it up front, which is what the caller used
    /// to do, threw the pass's motion away whenever the keyboard changed in
    /// the same pass: poll returns after sending KBD_STATE, so every keystroke
    /// on PC2 cost the pointer a movement, as did every failed send. Movement
    /// is a delta and cannot be asked for twice; an endpoint that was busy has
    /// cost the pointer a millisecond, not a movement. UsbService::publish
    /// already does exactly this for PC1.
    template <typename StateSource>
    bool poll(std::uint32_t now_ms, StateSource& source) {
        bool consumed_mouse = false;
        bool told_keyboard = false;
        const bool sent = poll_snapshot(now_ms, source.snapshot(hid::Target::Pc2),
                                        consumed_mouse, told_keyboard);
        if (told_keyboard) {
            // PC2 has the keyboard state now held - either a frame carrying it
            // went out, or it already had it. Until this is said the source
            // holds that state rather than advancing past it, because a state
            // replaced before it was sent is a keystroke PC2 never receives,
            // or a release it never receives.
            source.keyboard_reported(hid::Target::Pc2);
        }
        if (consumed_mouse) {
            // Only here, and only because a mouse frame actually went out.
            // Movement is a delta and cannot be asked for twice.
            source.take_snapshot(hid::Target::Pc2);
        }
        return sent;
    }

    /// Tell U2 to let go of everything, now.
    ///
    /// Used on reset paths and by STOP AND RELEASE ALL. It is sent
    /// unconditionally rather than folded into the ordinary state frame,
    /// because "release everything" must not wait for a change to notice.
    bool send_release_all(std::uint32_t now_ms);

    const EndpointStatus& status() const { return status_; }

    /// How many frames have gone out. Diagnostic only.
    std::uint32_t frames_sent() const { return frames_sent_; }

    /// The raw bytes of the last reply, whatever they were. Diagnostic only:
    /// the difference between "nothing came back" and "something came back
    /// that did not decode" is the difference between a dead wire and a
    /// framing fault, and no counter distinguishes them.
    const std::uint8_t* last_reply() const { return rx_; }

private:
    /// poll's decision, with the state it was given.
    ///
    /// Out of line so that main's frame carries this function's payload buffer
    /// no more than it did when poll was out of line entirely - Core 0's whole
    /// stack is two kilobytes and the CDC path sits on top of main's frame.
    /// In its own translation unit rather than in spi_master.cpp, because
    /// nothing it does needs the SPI block and the branch it takes is the
    /// whole of what this file was getting wrong.
    ///
    /// ``consumed_mouse`` says whether PC2 was actually told about the
    /// movement, which is the only condition under which the caller may
    /// consume it. ``told_keyboard`` says whether PC2 now has the keyboard
    /// state it was shown - a frame that went out, or a state it already had -
    /// which is the only condition under which the caller may let that state
    /// move on.
    bool poll_snapshot(std::uint32_t now_ms, const hid::TargetSnapshot& pc2,
                       bool& consumed_mouse, bool& told_keyboard);

    bool send(protocol::SpiMessageType type, protocol::ByteView payload,
              std::uint32_t now_ms);
    void consume_reply(const std::uint8_t* reply);

    std::uint32_t frames_sent_ = 0;
    std::uint16_t sequence_ = 0;
    std::uint32_t last_sent_ms_ = 0;
    bool ever_sent_ = false;

    hid::KeyboardSnapshot last_keyboard_{};
    std::uint8_t last_buttons_ = 0;
    bool keyboard_valid_ = false;

    EndpointStatus status_{};
    link::SequenceTracker replies_;

    std::uint8_t tx_[kFrameSize] = {};
    std::uint8_t rx_[kFrameSize] = {};
};

}  // namespace duo_input::u1
