valiklushnikov/input-duo/(commit log)

2026-08-01 chore: initialize recovered mouse switch project
2026-08-01 Define mouse switch packet protocol contract
2026-08-01 Implement timeout-safe mouse switch master
2026-08-01 Add Russian build and wiring guide
2026-08-01 Fix PS/2 transmit timing and wheel decoding
    [mouse_switch_master.ino]
2026-08-01 Fix PS2 motion and protocol handling
    [mouse_switch_master.ino, mouse_switch_protocol.h, mouse_switch_ps2_logic.h, mouse_switch_receiver.ino, protocol_compile_test.ino]
2026-08-01 Prevent remote packet burst overwrite
    [mouse_switch_master.ino, mouse_switch_packet_queue.h, mouse_switch_receiver.ino, protocol_compile_test.ino]
2026-08-01 docs: design two-board diagnostics
2026-08-01 fix: preserve PS2 response framing
    [mouse_switch_master.ino]
2026-08-01 fix: tolerate isolated PS2 report errors
    [mouse_switch_master.ino, mouse_switch_ps2_logic.h, protocol_compile_test.ino]
2026-08-03 docs: design side-button switching
2026-08-03 docs: plan side-button finder
2026-08-03 test: decode PS2 Explorer side buttons
2026-08-03 feat: add PS2 side-button finder
2026-08-03 docs: explain side-button identification
2026-08-03 feat: switch laptops with side button
2026-08-03 feat: type target macro from side button
2026-08-25 fix: harden transport codec bounds
    [cobs.cpp, test_transport.cpp]
2026-08-25 feat: encode strict CDC and SPI frames
2026-08-25 fix: distinguish frame decode capacity errors
    [frame.cpp, test_frames.cpp]
2026-08-25 fix: harden config validation result
    [test_config_validator.cpp]
2026-08-25 fix: align binary ABI with approved design
    [frame.cpp, frame.hpp]
2026-08-26 fix: bound device-supplied read size and frame buffer
    Three Important review findings on the Qt device layer:
    - read_config now rejects a READ_CONFIG_BEGIN size above
    BINARY_CONFIG_MAX_BYTES instead of looping on an unbounded u32.
    - FrameAssembler caps retained undelimited bytes at MAX_PENDING_FRAME_BYTES
    and raises FrameOverflowError; _fail now clears the assembler so a failed
    operation cannot poison the next one.
    - A solicited reply no longer realigns the sequence counter, which could
    rewind it behind a capture event the device had already spent.
2026-08-26 feat: add configurator shell and project state
    ProjectSession keeps the three states apart: dirty editor, saved file hash
    and committed device hash. Saving clears dirty without touching the device
    hash, so a mismatch stays visible until a write actually lands.
    The shell adds the navigation, the eight-profile selector, the connection
    indicator and the Save/Write buttons, and Overview renders versions,
    routes, memory usage and recent events from DeviceService.
2026-08-26 feat: edit profiles bindings and mouse switching
    Editing is a stream of pure commands: a page renders a session and asks
    for a change, the shell applies it and hands back a new session. A command
    that the project refuses - a duplicate trigger, a full profile, an unknown
    slot - is reported and changes nothing.
    Protocol v1 tells the host that a mouse is attached, not how many buttons
    it has, so Button 4 and 5 are offered only after the device has actually
    reported one through a capture event; a binding on a button the attached
    mouse has not reported is called out rather than silently written.
    Validation issues are listed under the editor and each one navigates to
    the exact profile or binding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
2026-08-26 feat: edit and safely test macro sequences
    The step editor builds every step type through builders that refuse a
    payload the binary format would reject, so an invalid step never enters
    the project. Text steps keep the operator's Unicode and report the exact
    index of a character the profile layout cannot type; clicking the report
    selects that character.
    A test run is deliberately awkward to start: the operator names the target,
    ticks a confirmation, and the device must already hold exactly the project
    on screen - otherwise the macro that runs would not be the macro being
    edited. STOP AND RELEASE ALL stays enabled throughout, closing the dialog
    sends it, and losing the link closes the dialog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
2026-08-26 feat: add private diagnostics and autosave recovery
    A diagnostic ZIP is something an operator emails to a stranger, so it is
    built from device counters and versions only. The saved project - and with
    it every macro text the operator wrote - enters the archive only when the
    box is ticked, and that box stays unavailable until the project has a file
    of its own to name. Text step content is redacted before it can reach the
    rotating log under %LOCALAPPDATA%\DuoInput\logs.
    A recovery is offered only when the autosave is newer than the project
    file, so accepting one can never move the operator backwards; a tie is
    resolved in favour of offering it, because only unsaved work is ever
    autosaved. A bro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
2026-08-26 test: add Duo Input release acceptance workflow
    The HIL runner refuses to produce a report without hardware. A latency
    figure from a simulator is not evidence about a device, and a report that
    was generated with nothing attached looks exactly like one that was not -
    so there is no path to obtaining one. Its arithmetic is tested here
    instead: nearest-rank percentiles so a p95 is always a measurement that
    actually happened, gap detection in time order, and an empty sample set
    that never counts as a pass.
    Six scenarios encode the acceptance criteria: peripherals, 1000 route
    toggles, link faults, 100 writes with 20 power cuts, the eight-profile
    power cycle and the 24-hour soak. Each states what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
2026-08-26 docs: record which plan steps ran and which are blocked
    The four steps that did not run are annotated with the reason rather than
    left as unticked boxes: a clean Windows VM, the Pico SDK toolchain and the
    two-board rig are not present in this environment, and the release folder
    depends on the artefacts they would produce.
2026-08-26 build: add RP2040 main and endpoint targets
    Two UF2 images that do almost nothing, and a contract that checks where
    they land. The contract reads the UF2 blocks rather than a linker map: a
    block states the exact flash address its payload is written to, and that is
    the thing that matters. Firmware growing past 0x10100000 does not fail to
    link - it silently starts overwriting config slot A the first time the
    operator writes one.
    Both mains come up with nothing held and nothing driven, and neither arms
    the watchdog: it is fed only after USB, SPI and the command queue have been
    serviced, none of which exist yet, so arming it now would reset a board
    behaving exactly as built.
    The firmware and h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
    [main.cpp]
2026-08-26 feat: track independent HID output states
    A key can be down because the operator is pressing it and because a macro
    is holding it at the same time. So this does not store "is this key down";
    it stores who is holding it, and the key stays down while anyone is. A
    macro ending mid-word therefore cannot lift a key out from under a finger.
    The six-key report has no seventh slot. A rejected key records no ownership
    at all - a key held in the model but absent from every report would later
    be released by something that never appeared to press it.
    Movement saturates instead of wrapping, because a wrapped delta sends the
    pointer the other way across the screen, and take_snapshot consumes it
    exactly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
2026-08-26 feat: expose composite HID devices on both endpoints
    The keyboard, mouse and consumer controls each get their own HID interface
    rather than sharing one behind report IDs. The specification asks for a boot
    keyboard, and boot protocol reports carry no report ID at all - a BIOS reads
    the first eight bytes and nothing else. Sharing an interface would have
    forced report IDs onto all three and quietly cost boot compatibility in
    exactly the situation where a keyboard has to work. Two extra endpoints on a
    chip with sixteen is a cheap price.
    U2 offers the same three interfaces and no CDC: it holds no configuration,
    and a serial port there would only invite someone to point the configurator
    at the bo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
2026-08-26 fix: identify U1 by the fields Windows actually reports
    Flashing a real board found this. The whitelist required the port's
    description to equal "Duo Input U1", but Windows names a composite device's
    serial function from the driver, not from the strings the device supplies:
    the genuine U1 enumerated as VID/PID 1209/D101 with serial
    DIU1-E663B03597570C2C and a description of "Устройство с последовательным
    интерфейсом USB". find_u1_ports() returned nothing for a board sitting on
    COM18.
    The identity is now the vendor ID, the product ID and the serial number
    prefix. The prefix is model identity in its own right - the firmware builds
    every serial as its own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
2026-08-26 feat: add fail-safe SPI endpoint link
    Every message on this link carries absolute state, never a change. A link
    that carries changes has to be perfect, because one lost frame leaves the
    two ends disagreeing forever - and this one runs four wires across a
    connector someone can knock. Absolute state means a lost frame costs a
    millisecond of staleness and a duplicate costs nothing, which is why the
    sequence tracker reports gaps rather than refusing frames: discarding a
    state more current than the one being held is the opposite of useful.
    U2 counts the silence itself and releases everything after 100 ms. If the
    link dies with a key down, nothing else will ever say to let go - the thing
    that wou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
    [link_watchdog.cpp, link_watchdog.hpp, main.cpp, spi_master.cpp, spi_master.hpp, spi_slave.cpp]
2026-08-26 feat: route output commands across both computers
    Core 1 decides what input means; Core 0 owns USB, SPI and flash. Neither
    may ever wait for the other: a Core 0 that blocks stops answering the host,
    and Windows removes devices that stop answering. So they share a bounded
    lock-free queue, and a full queue is a fault to report rather than a place
    to wait.
    A full queue does not merely drop the overflow - it releases everything.
    Commands were lost, so what is held no longer corresponds to anything the
    operator did, and half a macro is worse than none of it. One of the lost
    commands might have been the release that stops a key repeating forever.
    Draining is bounded so a burst of input cannot st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
    [main.cpp, output_runtime.cpp, output_runtime.hpp, test_output_runtime.cpp]
2026-08-26 feat: persist configuration with atomic A B slots
    The device is a USB gadget on a desk. It will be unplugged mid-write, and
    not once - because the write seemed to hang, because the machine slept,
    because a hub dropped out. Every one of those has to leave it holding a
    configuration it can parse: the old one or the new one, never a mixture and
    never nothing.
    The order is the design. Erase the spare slot, write the payload, hash what
    is actually in flash, and only then program the header. Until that last page
    lands the slot describes nothing, so a reboot at any earlier point finds
    exactly what was there before. The digest is recomputed from flash rather
    than carried over from the wire; taking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
    [test_ab_store.cpp, test_sha256.cpp]
2026-08-26 feat: talk to the configurator over CDC and store what it sends
    The device now answers the program written to configure it. Hardware found
    four things no emulator could.
    DTR. QSerialPort does not raise it on open, and the firmware gated its
    replies on tud_cdc_connected(), which requires it. The board received every
    request and answered none - indistinguishable from a board that is not
    there. The configurator raises DTR now, and the firmware answers whoever
    asks rather than depending on a control line.
    Page granularity. Flash programs whole 256-byte pages and nothing else, and
    a default project compiles to 424 bytes. Chunks are buffered up to a page
    boundary before they go anywhere, with th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
2026-08-26 feat: add hardware recovery controls and diagnostics
    The two buttons are what someone reaches for when the software has already
    let them down, so the timing is pinned down exhaustively rather than by
    pressing one and hoping. A contact bouncing for a few milliseconds is not
    two presses; a finger resting on SW1 is one intention, not a thousand; and
    SW2 fires its short action on release, because until then the press might
    still become a five-second hold - and confirming a factory reset must not
    release every key on the way past.
    A button already down at the first reading is the baseline, not a press.
    Powering the device with a finger on SW2, or with that pin shorted, must not
    erase the operato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
    [buttons.cpp, buttons.hpp, config_service.cpp, config_service.hpp]
2026-08-26 Build for the Waveshare RP2040-Zero, which is the actual hardware
    PICO_BOARD was `pico`. The boards are RP2040-Zeros. Same chip and the same
    2 MB of flash, so the A/B layout is unaffected - but the Pico's LED on GP25
    is a pad this board does not route anywhere, while its only indicator is an
    addressable WS2812 on GP16.
    Built for the wrong board, the indicator code compiled and drove that dead
    pad. This cost real time during bring-up: a dark LED was read as evidence
    that U2 was decoding nothing, when in truth it could never have lit under
    any conditions. An indicator that cannot work is worse than no indicator,
    because absence looks like signal.
    Targeting the right board leaves PICO_DEFAULT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
2026-08-26 Drive the U2 slave with DMA armed before the master clocks
    The slave polled: it waited to see bytes arrive and then started a 64-byte
    transfer. Both halves of that are wrong, and neither can work.
    A slave does not choose when a transfer happens. Whatever is already in its
    transmit path is what goes out while the master's bytes come in, so deciding
    what to send once the clock is running means sending whatever happened to be
    there. And by the time bytes have been noticed, the clocks that would carry
    the remaining 64 have already gone by - they are not coming back.
    Both directions are now armed by DMA before the master clocks anything, and
    each moves exactly one frame, which is what keeps the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
    [config_service.cpp, config_service.hpp, main.cpp, spi_master.cpp, spi_master.hpp, spi_slave.cpp, spi_slave.hpp]
2026-08-26 Do not accept U1's own frame as U2's answer
    Found on real hardware during bring-up. A fault that returns U1's outgoing
    line to its own incoming one hands U1 back the frame it just sent - intact,
    and carrying a CRC that U1 computed itself. U1 accepted it as U2's reply and
    reported a healthy link while U2 was not running at all.
    The CRC cannot catch this and never will: the frame is not damaged. Only the
    message type can, and it separates the two cleanly, because U2 sends exactly
    one kind of message and U1 sends none of it.
    This is the worst failure this device has. The link watchdog exists so that
    U2 releases every key when U1 stops talking. A U1 that believes a dead link
    is alive keeps sen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
    [spi_master.cpp, spi_master.hpp, test_frames.cpp]
2026-08-26 Let the SPI block drive chip select, which is what makes the link work
    The link was silent in both directions for days while every part of it
    tested good on its own: U1's SPI block answered its own internal loop back
    byte for byte, U2's slave answered a hand-clocked master at three different
    speeds, and all four wires carried a signature that named each of them.
    The fault was one line of intent. U1 drove chip select by hand and held it
    down for a whole 64-byte transfer, so that one assertion would frame one
    frame. In this frame format that signal is not the boundary of a frame, it
    is the boundary of a *byte*. A select that never rises means a slave that
    shifts one byte and then waits foreve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
2026-08-26 Empty the transmit queue on resync, and report the link to the host
    Two things, both found by finally being able to see the wire.
    The frame arrived complete, correct, and three bytes late, every time. Bytes
    are handed to the transmit queue ahead of the clock, so when a transfer ends
    some are still sitting in it. Aborting the transfer does not discard them and
    disabling the block does not either - they simply wait, then lead the next
    frame. That pushes its checksum past the end of the master's 64-byte window,
    so it can never verify, and since each round leaves the same remainder the
    shift repeats forever. Only resetting the block empties that queue.
    The second thing is why this took days. E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
    [config_service.cpp, config_service.hpp, main.cpp, spi_slave.cpp, test_config_service.cpp]
2026-08-27 Have U2 report what it saw when the link died
    The 100 ms fail-safe could not be shown to work on hardware, only asserted in
    a unit test. Nothing can watch it happen: at the moment U2 lets go of every
    key, the link that would carry the news is the one that went silent.
    So U2 remembers instead - how many times the link has died, and how long the
    silence had lasted when it released - and says so in every reply once the
    link is back. U1 passes both to the host in GET_DIAGNOSTICS.
    That makes the fail-safe measurable without touching a wire: U1 is put into
    its bootloader over CDC, which stops it dead, and reflashed. Measured three
    times in a row, U2 released at exactly 100 ms each time, and each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
    [config_service.cpp, config_service.hpp, link_drop_log.cpp, link_drop_log.hpp, main.cpp]
2026-08-27 Drop the button checks from the gate, and record what blocks the rest
    The hardware will not have buttons, so a gate that asks someone to press one
    can never be met. The code stays and is safe without them: both pins are
    pulled up and read as closed-to-ground, so an unconnected pin is always "not
    pressed", and a pin that reads pressed at power-on is taken as the baseline
    rather than as an action. What the buttons would have done is reachable over
    CDC either way.
    The two-computer routing check is blocked rather than skipped: U2 cannot be
    connected to a second computer yet, and nothing else stands in its way.
2026-08-27 Define the CH375 command contract from WCH's own datasheets
    Every constant is transcribed from the manufacturer's documents and cited by
    section in docs/hardware/ch375-command-table.md. Libraries and forum posts
    disagree with each other about several of these bytes, and a wrong command to
    a USB host controller does not fail loudly - it answers with a number that
    looks reasonable.
    Reading them turned up three things worth having written down where they will
    be found:
    GET_DESCR cannot return a descriptor longer than 64 bytes (DS2 1.11), and
    real keyboards routinely exceed that, so enumeration cannot rely on it.
    DELAY_100US works only over the parallel port (DS2 1.4), which this board does
    no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
    [commands.hpp, scripted_ch375.cpp, scripted_ch375.hpp, test_ch375_transport.cpp, transport.hpp]
2026-08-27 Mark Task 1 done and correct the plan's hardware constraints
    The constraints described a board that was not built: they put the level
    shifter's output enable on GP7, where it is tied to VCCA, and asked for an
    8N1 UART where the chip's framing is nine data bits.
2026-08-27 Add a CH375 lifecycle state machine, and a probe that found the jumper
    Task 2's half that can be tested without hardware: one CH375 and whatever is
    plugged into it, as a state machine that never waits. Every step happens
    across ticks, so a controller that stops answering costs that one device its
    input and nothing else - U1 still has to service USB, the link to U2 and the
    watchdog on the same loop.
    Two things the tests forced out that were not in the plan:
    A controller that goes quiet while a device is configured is the dangerous
    case. Its reports cannot be read and its disconnection can never be noticed,
    so a key held at that moment would be held forever on the far side. It is now
    declare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
2026-08-27 Build the CH375's serial port out of PIO, and find what the wire is doing
    The chip's frame is nine data bits, the ninth marking a command from a data
    byte (DS1 6.2.2), and an RP2040's hardware UART does at most eight. Two state
    machines per chip do what the peripheral cannot: four of the eight available,
    in one block, so the other stays free.
    It works. The port reads whole nine-bit frames at 9600 with no framing errors,
    which is what a correct bit rate looks like, and it replaced a hand-timed loop
    that could send but never reliably receive.
    What it then measured is that the line is not usable. With nothing being
    transmitted at all, eight to nine complete frames per 100 ms arrive on each
    ch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
    [ch375_probe.cpp, ch375_probe.hpp, main.cpp, pio_transport.cpp, pio_transport.hpp, transport.hpp]
2026-08-27 Use one FIFO mechanism per direction, not two
    Both PIO programs pulled and pushed by hand while the configuration also
    enabled autopull and autopush. The receive side was doing real damage: with
    autopush at nine bits, the ninth IN pushed the word and emptied the register,
    and the PUSH after the stop bit queued a second, empty one. Every frame
    arrived followed by a zero that never crossed the wire, and those zeros were
    being counted as traffic.
    They are gone now, and the finding they were suspected of inflating survived
    without them: the line still carries frames nobody sent. Listening for a
    second before this firmware transmits anything at all - a measurement that had
    never been taken, so U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
    [ch375_probe.cpp, ch375_probe.hpp, main.cpp, pio_transport.cpp]
2026-08-27 Read the framing-error flag the receive program actually raises
    `irq 4 rel` sets flag 4 + n for state machine n. This checked flag n, so it
    reported no framing errors regardless of how many there were - and "no framing
    errors" had already been used here as evidence that a stream of frames was
    real data rather than noise. It was evidence of nothing.
    Read correctly, and counted as it goes rather than asked once at the end
    (the flag is sticky, so a single glitch and a line made of glitches give the
    same answer), the same second of listening shows 340 malformed frames against
    525 good ones on one channel and 295 against 570 on the other. Two in five
    wrong is what noise looks like; a real transm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
    [ch375_probe.cpp, ch375_probe.hpp, main.cpp, pio_transport.cpp]
2026-08-27 Reset the PIO block on startup, and measure the leads without PIO at all
    Reaching this code does not mean the chip just powered on. A firmware update
    over USB restarts the processor and leaves every peripheral exactly as it was,
    so state machines from the previous run were still executing when the new
    program was loaded underneath their program counters. They ran whatever landed
    there and pushed the results into their queues, which this code read as frames
    from the wire.
    That is where an evening of "the line is noisy" came from. Every one of those
    readings was taken after a reflash; the one taken after real power was removed
    showed silence.
    With the block reset, the question can be asked p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
    [ch375_probe.cpp, ch375_probe.hpp, main.cpp, pio_transport.cpp]
2026-08-27 Name the level shifter, now that it has been measured rather than suspected
    The same lead, at the same length, in the same place: attached to U1 and to
    the shifter, both receive pads are in motion a third of the time with more
    transitions than the counter can hold. Unsoldered at the shifter's A-side pads
    and left hanging from U1, both go back to steady high with zero transitions.
    Detached at both ends, the same.
    So the wire is not an antenna and the A side of the TXS0108E is driving this.
    The CH375s were powered and idle throughout, so nothing was being translated -
    the part was doing it on its own.
    Which is not the same as the part being faulty. TI documents the behaviour:
    the one-shot ac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
2026-08-27 Correct the last conclusion: the shifter relays the noise, it does not make it
    With the A side still wired to U1 and the B side lifted off the CH375's TXD
    pins, both receive pads go back to steady high with zero transitions. So the
    TXS0108E is not oscillating. It is in the path of something that starts
    further along.
    The previous commit said the A side was driving it. That was over-read: the
    evidence it rested on - quiet when the lead is lifted at the shifter - fits a
    part that relays exactly as well as one that generates, and separating them
    needed one more disconnection a pad further out. The document now carries the
    whole table rather than the row that suited the conclusion.
    Which means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
2026-08-27 Measure the shortest pulse on a pad, and pin the noise to one chip's TXD
    The instrument now times its own sampling loop, so the shortest run of samples
    a level holds for can be given in nanoseconds without depending on how fast
    the loop happens to be. A 12 MHz crystal two pins away and a chip driving its
    own output look nothing alike, and this is what tells them apart.
    More usefully, one channel at a time settles where the disturbance starts.
    With the keyboard's lead soldered back to its CH375's TXD and the mouse's left
    off, five readings in a row give eight or nine unasked frames per 100 ms on
    the keyboard channel and silence on the mouse - a live control sitting beside
    the measurement, re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
    [ch375_probe.cpp, ch375_probe.hpp, main.cpp]
2026-08-27 Both CH375s answer CHECK_EXIST with the shifter removed
    0xA8 back from 0x57, on both channels, which is the inverse the datasheet
    specifies (DS1 5.5). Neither chip had answered anything before this.
    It settles two things the level readings could not reach: the data lines are
    not swapped, and both chips are in serial mode. A chip wired backwards or left
    in parallel mode cannot return that byte.
    The static readings taken after the TXS0108E came out say the wiring is sane -
    steady highs, no transitions, clean drive on GP0 and GP4 - but a sane-looking
    line is not a working one, and only a command the chip has to answer can tell
    them apart. That is what this adds: the level record is left exact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
    [ch375_probe.cpp, ch375_probe.hpp, main.cpp, pio_transport.cpp, pio_transport.hpp, test_ch375_baud_scan.cpp]
2026-08-27 Withdraw the 5 V warning: the module regulates to 3.3 V itself
    The board carries an AMS1117-3.3, so the 5 V going in is regulated there and
    the CH375 runs at 3.3 V. Its pins drive 3.3 V into pins that expect 3.3 V, and
    the direct connection that now works is simply the right one. The previous
    commit warned that a pin was being over-driven and recommended dividers on
    four inputs; that assumed the chip ran at whatever the module was fed.
    It also offers a coherent reason for the noise that took the evening. The
    shifter's B side was wired to the external 5 V - told the far side was a 5 V
    world - while the chip there was driving 3.3 V. To an auto-direction
    translator that is a marginal high, and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
2026-08-27 Run the CH375 lifecycle on hardware, and find the lead that was not there
    Both controllers answer CHECK_EXIST with 0xA8 and both state machines run
    independently - one goes to work while the other, with an empty port, stays in
    Absent. That is the independence the plan asks for.
    The device on the first channel attaches and detaches over and over without
    ever reaching Ready, and three things came out of chasing it.
    Two owners of one chip. The periodic probe was still setting the working mode
    and reading statuses alongside the state machine, and reading a status is what
    clears it - so each consumed the interrupts the other was waiting for. The
    probe now runs once, before the machines take ove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
2026-08-27 Count why a device leaves, and find that the chip keeps losing it
    The interrupt line works and the statuses are being read: seventeen connects
    and thirty-five disconnects on the channel with a device, matching seventeen
    attaches and seventeen departures. So the controller sees the device arrive
    and sees it go, over and over, and reports both faithfully. Nothing above the
    chip is at fault.
    Three instruments had to be fixed before that was visible, and every one of
    them had lied confidently rather than fallen silent:
    A one-shot test that pulled the interrupt pin down and called it live only if
    it stayed high. That is true of an idle INT# and false of an asserting one -
    the signal is active l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
    [device.cpp, device.hpp, main.cpp]
2026-08-27 Run the bus at the speed the device answers to, and wait in the right mode
    Three things from the datasheets that this was not doing, each of which alone
    keeps a device from ever coming up.
    The bus speed. A CH375 runs at 12 Mbps until told otherwise and returns there
    every time a working mode is set (DS2 1.1), while nearly every wired mouse is
    a 1.5 Mbps device. Addressed eight times too fast it answers nothing, and a
    controller reports something that answers nothing as gone. The device is now
    asked what it is (DS2 1.2) and the bus is set after the mode, never before.
    Where to wait. DS2 1.2 says the speed question is only valid in host mode 5,
    and this was leaving the chip in mode 6 after a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
    [commands.hpp, config_service.hpp, device.cpp, device.hpp, main.cpp, scripted_ch375.cpp, scripted_ch375.hpp, test_ch375_device.cpp]
2026-08-27 One reader of the chip's status, and a controller that is reset before use
    The device machine read the interrupt status at the top of every tick, and
    reading it is what clears the chip's request - so the enumerator, polled a few
    lines later, found nothing and timed out against a chip that had answered
    immediately. On the bench that read as "no interrupt before the deadline"
    beside four successful statuses in the same report.
    The status is now read once, above, and handed down. IDeviceSetup::poll takes
    it rather than fetching it, which removes the shape of the bug rather than
    this instance of it. It is the third time in this bring-up that two owners of
    one chip have produced a symptom that l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
    [ch375_probe.cpp, device.cpp, device.hpp, enumerator.cpp, enumerator.hpp, main.cpp, scripted_ch375.cpp, scripted_ch375.hpp]
2026-08-27 Reach Ready on hardware, and stop the fail-safe from undoing it
    The device came up. AUTO_SETUP returned 0x14 - success - the state machine
    entered Ready, and everything the last several commits fixed was needed to get
    there: the bus speed, the mode to wait in, the recovery pause, the single
    reader of the chip's status.
    Then the fail-safe threw it away. A quarter of a second without an interrupt
    was treated as the controller having gone quiet, and the device that had just
    finished coming up was declared gone. That number was chosen for a controller
    that stops answering, not for an endpoint with nothing to report, and it is
    now a second - long enough that a quiet mouse survives, short enough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
    [device.cpp, device.hpp, main.cpp, test_ch375_device.cpp, transport.hpp]
2026-08-27 Measure the loop, and give the report the arguments its format asked for
    The text report had grown two fields whose arguments were never added, so
    both printed whatever happened to be on the stack. One of them read zero and
    was used here to conclude that a device had been declared lost without ever
    being polled - a conclusion about firmware drawn from a number that was not a
    number.
    Moving this report to text removed one class of instrument bug and this is
    another: a format string and its arguments can disagree just as quietly as a
    byte offset can. What made it visible was the same thing as before - a reading
    that could not be true, in this case a loop pass of 268 seconds.
    Read properly, t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
    [main.cpp]
2026-08-27 Set the data toggle, and record why AUTO_SETUP cannot finish the job
    The chip does not track the data toggle - the host sets it, and it has to be
    set before the first IN transaction of a new device (DS2 1.6). That was
    missing, so it is here now: DATA0 when a device comes up, and the other packet
    after each transaction that succeeds. Only after a success, because one that
    failed consumed nothing and moving the toggle anyway leaves the two ends
    permanently one apart.
    It did not fix the symptom. A hundred and twenty tokens still produce no
    interrupt at all, where DS2 1.15 says a token always ends in one, so the chip
    is not executing them.
    What is left is the thing AUTO_SETUP does not tell any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
    [device.cpp, device.hpp, transport.hpp]
2026-08-27 Read a configuration descriptor without trusting it
    These bytes come from whatever someone plugged in. Every record carries its
    own length, and those lengths are the only thing saying where the next record
    starts, so a parser that believes them walks wherever it is pointed - which in
    firmware is past the end of the buffer and into whatever is next in memory.
    Every length is therefore checked against what is left rather than against
    what the descriptor claims to have, and a descriptor that does not add up is
    refused whole. Half a keyboard is not a keyboard: a device accepted with one
    field misread types the wrong thing on somebody's computer, which is worse
    than a device that reports itself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
    [hid_parser.cpp, hid_parser.hpp, test_hid_parser.cpp]
2026-08-27 Enumerate a device by hand, and read its first reports
    A real mouse now comes up and speaks. The configuration descriptor is fetched
    and parsed on hardware - found=mouse endpoint=1 packet=7 boot=yes, parse
    clean - and moving the mouse produced reports read from the endpoint the
    device itself named.
    That endpoint is the point of the whole task. AUTO_SETUP gives a device an
    address without saying which, while the host has to be told the same address
    separately (DS2 1.5), and it never reports where the reports will arrive. With
    it, a hundred and twenty polls in a row produced nothing at all; the steps are
    now taken one at a time and both facts are known rather than assumed:
    read the device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
2026-08-27 Read 218 reports from a real mouse
    It works. The device is enumerated by this firmware, reaches Ready, is
    recognised as the low-speed device it is, and moving it produces reports read
    from the endpoint its own descriptor named - 218 of them in one run, with the
    state machine sitting in Ready rather than cycling.
    What is left is not a protocol fault. The mouse browns out when it is moved:
    its lights dim at the moment it is used, and the module supplies it from its
    own 5 V input. From the firmware side that reads as a device attaching and
    departing repeatedly, which is what the last several rounds of chasing looked
    like. The wiring document now says so, with the give-away that needs no
    instru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
2026-08-27 Turn HID reports into events without inventing any
    A report says what is true now, not what changed, and the whole job is telling
    those apart.
    The keyboard's six key slots are a set, not a sequence: a keyboard reshuffles
    its own array whenever it likes, and two reports holding the same six keys in
    a different order mean nobody touched anything. So contents are compared,
    never positions. Comparing positions releases and re-presses every key
    somebody is holding, which lands on their computer as a stutter of characters
    they did not type.
    A rollover report - 0x01 in every slot - means the keyboard cannot say what is
    held, not that six new keys went down. It changes nothing, and what was held
    b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
2026-08-27 Apply bindings, and move the routes without stranding a key
    Most input passes straight through. A binding either replaces the key that
    triggered it or adds to it, and that single difference decides whether the far
    side sees a key that appears to do nothing or one that does its job and types
    a character nobody wanted. A key swallowed on the way down has its release
    swallowed too - letting that through would have the far side release something
    it never saw pressed, which on a modifier clears one the person is still
    holding.
    The dangerous part is changing where input goes. Whatever is down at that
    moment is down on the computer being left behind, and that computer will never
    hear about it agai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
    [test_binding_engine.cpp]
2026-08-27 Ask which key to bind without pressing it on the far computer
    Capture sees an event before the bindings do. While the configurator is
    asking "press the key you want to bind", that key belongs to the question:
    sending it on would mean asking somebody to bind Ctrl+W and closing their
    browser tab while they answer. Its release is swallowed too, because a
    computer that never saw a key go down must not be told it came up.
    Modifiers are not answers - they are recorded against whatever is pressed
    next, since capturing Control the instant it goes down makes Ctrl+W
    impossible to bind at all. Motion passes through: the operator still has
    to reach the window that is asking them the question. Ten secon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
    [core1_runtime.cpp, core1_runtime.hpp]
2026-08-27 Release what a device was holding when its cable is pulled
    A peripheral unplugged mid-keystroke is holding keys on a computer that
    will keep holding them. The device is gone, so no release will ever
    arrive from it, and the far machine has no way to find out - somebody
    yanks a USB cable and their other computer types until it is rebooted.
    A disconnect now synthesises the releases the device did not send, which
    is the only place anything here invents input.
    A controller that gave up is treated the same way, because from the far
    computer's side the two are indistinguishable.
    Reports that arrive before a device has been identified are counted and
    dropped rather than guessed at: one device's re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
    [test_input_pipeline.cpp]
2026-08-27 Type a capital letter as a capital letter
    A KEY_TAP step carries a modifier byte beside its usage, and TEXT carries
    a run of the same pairs - that is the compiled form the host sends. The
    scheduler was reading only the usage, so every macro with a capital letter
    in it typed a lower-case one, and TEXT did nothing at all.
    Both are now the same thing to run: pairs, one event per pass. The
    modifier goes down before the key and comes up after it, because a shift
    that arrives with the keystroke or leaves before it is a lower-case letter
    on somebody's screen. A macro stopped mid-word stops - it releases what it
    is holding and does not finish the word.
    The pairs are read from where the configurati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
2026-08-28 Stop reading a moving mouse twelve times slower than it moves
    The port ran at 9600 the whole time. A CH375 serial frame is eleven bits -
    the ninth data bit is the command flag - so one byte costs 1.15 ms, and
    collecting one mouse report takes fifteen of them: the status, the read
    command, the length, seven data bytes, the toggle and the next token.
    Seventeen milliseconds for something a moving hand produces every eight.
    An idle mouse costs four bytes a poll, which fits inside the eight
    comfortably. That is why the fault appeared only on movement, and why
    better power wiring did not change it: there was never a power problem to
    fix.
    The port is now raised to 115200 as soon as the chip answe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
    [commands.hpp, device.cpp, device.hpp, pio_transport.cpp, pio_transport.hpp, scripted_ch375.hpp, test_ch375_transport.cpp, transport.hpp]
2026-08-28 Ask the chip where it is rather than assuming after a failed rate change
    No answer to SET_BAUDRATE has two opposite causes. The chip may never have
    heard the command, and is still at the old rate; or it may have changed and
    had its one-byte answer lost, and is at the new one. Guessing picks the
    wrong one half the time and leaves a chip that is working and unreachable -
    which costs somebody a trip to the board to pull its power.
    CHECK_EXIST is the one command that proves the port itself works and is
    safe to repeat, so it is asked at both rates and whichever answers is where
    the chip is.
    The bring-up report now says what rate the port is set to and how often the
    chip refused to move, because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
    [commands.hpp, config_service.hpp, main.cpp, pio_transport.hpp, test_ch375_transport.cpp, transport.hpp]
2026-08-28 Measure which speed a channel can hold instead of assuming both can
    The two channels on this board do not manage the same rate. The empty one
    runs at 115200 with no refusals; the one the mouse is plugged into refused
    it every time - eighty-five times in three seconds of trying. Whether that
    is wiring, length or the module itself, the firmware cannot tell from here
    and does not need to: it can try, check, and step down.
    So there is a ladder - 115200, then 62500, then 37500, the last two exact
    on the chip's own divisor - and a rate is only kept if CHECK_EXIST answers
    twice with different bytes. A marginal rate answers sometimes, and taking
    it on one byte is how a link that half works gets cho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
2026-08-28 Stop bricking the chip while trying to make it faster
    The channel with the mouse on it reached 37500 and worked - 815 successful
    transactions, real reports, no enumeration failures. Then it went quiet and
    stayed quiet, refusing the rate change once a second, a hundred and
    eighty-six times.
    The recovery path was the cause. On a failed rate change it sent RESET_ALL
    at the rate the chip might have moved to. When the chip had not moved -
    the ordinary case, where the command simply did not take - that reset
    arrived as noise at the wrong rate. CH375 reads commands positionally, so a
    half-heard byte is swallowed as somebody's parameter and every byte after
    it is out of step. From outside that is a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
    [device.cpp, device.hpp, test_ch375_transport.cpp, transport.hpp]
2026-08-28 Find the chip instead of asking somebody to pull its power
    Two set_usb_mode failures were silent. A channel could spin between them
    for hours with every reading frozen - no counter moving, no state changing
    - which is indistinguishable from a board that has stopped running, and was
    read as one for twelve seconds of continuous polling before the gap showed
    up. Both are counted now.
    And when a chip will not take a mode command, it is often not deaf but
    elsewhere: left at a rate this side abandoned, where nothing is asking. So
    it is looked for across every rate the ladder can reach, using CHECK_EXIST
    alone - one command, one data byte, and it proves the port by construction
    (DS1 5.5). Found so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
    [commands.hpp, device.cpp, device.hpp, main.cpp, scripted_ch375.cpp, scripted_ch375.hpp, test_ch375_transport.cpp, transport.hpp]
2026-08-28 Separate a deaf chip from one that will not change mode, and try a flush
    Two failures looked identical from outside - a channel that does nothing -
    and wanted opposite repairs. CHECK_EXIST is now asked when a mode command
    is refused, so the report says which one it is.
    On the board that answered: neither. The chip on the wedged channel takes
    nothing at all, at any rate the ladder can reach, and the search found it
    nowhere. So the fault is not a chip stranded at an abandoned rate, which is
    what the last change assumed.
    The flush here is an attempt at the next hypothesis: that a chip whose
    receive line floated while U1 was being reflashed read start bits out of
    the noise, ended up part way t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
    [commands.hpp, device.cpp, device.hpp, main.cpp, scripted_ch375.cpp, scripted_ch375.hpp, test_ch375_transport.cpp, transport.hpp]
2026-08-28 Restart the state machines when the rate changes, not just the divider
    A running PIO state machine holds a program counter part way through a
    frame, a shift counter part way through a byte and a clock divider part way
    through a bit. Moving the divider underneath all of that leaves the
    receiver counting the new rate's bits from the old rate's phase, and
    nothing in the program resynchronises except the start bit it is no longer
    looking for. The channel goes deaf and stays deaf.
    That is the symptom that had both channels dead through three power cycles
    of the modules: a fault at the chip's end cannot survive its power being
    pulled, so it was never at the chip's end. Both state machines are sto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
    [pio_transport.cpp]
2026-08-28 Wait for the answer before asking again
    The controller was given a token every eight milliseconds whether or not it
    had answered the last one. It is not a register: a token starts a real USB
    transaction and the interrupt comes when that finishes. Firing the next one
    on a timer lands it in the middle of the one still running.
    On the bench that was a hundred and twenty-five tokens producing seven
    interrupts - and then the device declared lost, because a second passed
    with no interrupt and the reason there was no interrupt was us. The
    counters said disconnect=0 and detach_lost=1: the mouse never went
    anywhere, it was buried.
    One token outstanding at a time now. With a cap, because waiting for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
2026-08-28 Finish reading what the chip was told to send
    Both ways of abandoning a block read walked away with bytes already on
    their way. The read command has gone by then; the chip sends the packet
    whether or not this side still wants it. Those bytes do not vanish - they
    arrive as the answer to the next command, and the one after that, and every
    one after that. A port permanently one answer behind, which from outside is
    a controller that has stopped making sense and that only a power cycle
    appears to fix.
    That is the shape of what the board has been doing: a handful of good
    transactions after enumeration, one real report, then nothing ever again.
    The old comment on the impossible-length path said i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
    [test_ch375_transport.cpp, transport.hpp]
2026-08-28 Ask whether the chip is silent or this side is listening in the wrong place
    Those two are the same thing from outside - a channel that answers nothing
    - and they want opposite repairs. One is a wire or a module; the other is
    this code's own timing. Nothing has ever told them apart, so both have been
    guessed at in turn for weeks.
    A dead channel now asks the same question at the rate the chip uses and
    listens for the answer across seven sampling rates either side of it.
    CHECK_EXIST is what is asked, because its answer is the bitwise inverse of
    the byte it was given (DS1 5.5): a reply is either right or obviously not,
    with nothing in between to be hopeful about.
    The answer on this board is hi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
    [commands.hpp, device.cpp, device.hpp, main.cpp, pio_transport.cpp, pio_transport.hpp, scripted_ch375.hpp, test_ch375_transport.cpp]
2026-08-28 Ask for a faster rate only after the chip has answered something
    The rate was raised during bring-up, before the chip had proved it was
    alive. So every dead channel got the barrage too - a SET_BAUDRATE and its
    verification once a second, for ever - and that included the freshly
    powered chip somebody had just walked over to revive, wedged again before
    they got back to their chair. A board that used to come back when its
    module's power was pulled stopped coming back at all.
    The raise now happens after set_usb_mode has been accepted. A chip that has
    just taken a mode command is talking; a chip that has not is left alone.
    Removing the raise entirely was the wrong correction: it took the fix fo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
    [device.cpp]
2026-08-28 Move the receiver before the chip answers, not after
    An independent review found the defect the whole day was built on top of.
    SET_BAUDRATE is answered by a chip that has already moved: 51H arrives
    within microseconds of the last stop bit, at the new rate. The old code
    changed both ends together, which meant waiting for the transmitter's tail
    first - 1.5 ms - then clearing the receive FIFO, then sleeping 2 ms more
    before listening. The answer came and went inside that window against a
    receiver still divided for the old rate, and what survived was flushed on
    purpose.
    So every rate change reported failure on a chip that had taken it. The
    eighty-five "refusals" counted on this board were not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
    [device.cpp, device.hpp, main.cpp, scripted_ch375.cpp, scripted_ch375.hpp, test_ch375_device.cpp, test_ch375_transport.cpp, transport.hpp]
2026-08-28 Look for the chip at the one rate this code put it at
    A raised link that degrades takes the reset with it. The chip is told to
    come home at a rate it has stopped holding, so it never hears, and stays
    where it was put while this side returns to the default and knocks on an
    empty door for ever. That is the state the board reaches after ten good
    polls: the mouse enumerates, works, is lost, and the channel never returns.
    One rate is asked, not a sweep. This is not a search - the rate is known,
    because this code chose it and remembered it. Probing rates the chip was
    never put at is how a controller that was about to come good gets a
    half-heard opcode instead, which is the mistake that ran all da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
    [device.cpp, device.hpp, main.cpp, test_ch375_transport.cpp, transport.hpp]
2026-08-28 Re-arm a quiet endpoint instead of re-enumerating the peripheral
    The counters say the device never disconnected: disconnect=0 against
    detach_lost=3. Every one of those teardowns was this side deciding a
    silence meant the mouse was gone.
    And a teardown is not free to watch. It resets the chip and the bus, so the
    peripheral re-enumerates: its lights go out and come back, and everything
    held on it is released and re-acquired. That blink is the symptom the
    operator has been reporting all day, and for three of those seconds it was
    not the mouse's doing at all.
    A second of silence now buys a re-arm - the receive toggle back to DATA0
    and another token, four bytes - which recovers the case that is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
    [device.cpp, device.hpp, main.cpp, test_ch375_device.cpp]
2026-08-28 Keep only the speed the channel can actually hold
    The ladder proved a rate with two CHECK_EXIST replies. That proves the
    divider and nothing else: this channel answered twice at its raised rate,
    ran seventeen hundred transactions on it, and then dropped the link. A rate
    that shakes hands and later collapses was never this channel's rate, and
    only running at it finds that out.
    Every collapse now costs a rung, and the bottom of the ladder ends the
    raising for good. A link that keeps its speed and keeps dropping is worse
    than a slower one that stays up, because each drop is a peripheral that
    goes dark and comes back in front of the operator.
    The endpoint re-arm from the previous commit absorb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
2026-08-28 Fit main's frame inside the stack it was given
    An independent review found this and it outranks everything else today.
    Core 0's stack region is two kilobytes - 0x20041800 to 0x20042000. main's
    frame was 7972 bytes. The stack pointer after the prologue sat at
    0x200409F8: four kilobytes below its own floor, and straight across core 1's
    entire stack at 0x20040800..0x20041000.
    Nothing had faulted because nothing runs on core 1 in this build yet. The
    next task in the plan launches it. Two cores writing the same memory faults
    nothing, trips no watchdog, and leaves a board that keeps looping and keeps
    printing plausible counters while its data is rewritten underneath it -
    which would have made ev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
2026-08-28 Read the stored configuration the configurator actually writes
    The runtime had no way to get a profile off the device: IProfileSource had
    only a test double behind it. This reads the binary format - bindings,
    macros and their steps - from a validated configuration.
    One translation happens, and only here. The format numbers macros up to
    255; the output side tells a macro's keys apart from the operator's by an
    owner index and there are thirty-two of those. So a binding's RUN_MACRO
    argument is rewritten to a slot while the macro table and the binding table
    are both in view. Passing the wire number through would index off the end
    of the owner table, and carrying two numbering schemes together i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
    [config_profiles.cpp, config_profiles.hpp, test_stored_profiles.cpp]
2026-08-28 Ask for a capture and a profile rather than assert them
    The capture runs on Core 1 and the profile swap has to stop a macro and let
    go of held keys before the bindings change underneath them. Neither is
    something a USB callback on Core 0 can do, so CAPTURE_BEGIN, CAPTURE_END and
    SET_ACTIVE_PROFILE now record what was asked for and the main loop carries it
    across, the way STOP_AND_RELEASE_ALL already did.
    The reported profile follows Core 1's confirmation rather than the request,
    and the reported capture state is pushed in by the loop: a capture ends on its
    own after ten seconds and this class would otherwise go on saying one is
    running.
    A completed capture goes back out as an unsolicited C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
    [config_service.cpp, config_service.hpp, test_config_service.cpp]
2026-08-28 Give Core 1 the real input runtime instead of a test pattern
    Core 1 now ticks both CH375 controllers, turns their reports into events
    through the two pipelines, and runs the capture, the bindings and the macros -
    submitting commands into the queue Core 0 already drains. Core 0 keeps USB,
    the link, flash and the whole output state, and reads the controllers only to
    report on them: two cores ticking one chip made each consume the interrupts
    the other was waiting for.
    The stored configuration is read once, before Core 1 starts, and pointed at
    where it lies in flash. Core 1 installs the active profile's bindings and its
    macros, and reinstalls the macros whenever the profile changes underneath i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
    [core1_runtime.cpp, core1_runtime.hpp, main.cpp, pico_flash.cpp, pico_flash.hpp, test_core1_runtime.cpp]
2026-08-28 fix: make release input runtime safe
    [config_service.cpp, config_service.hpp, core1_runtime.cpp, core1_runtime.hpp, main.cpp, test_config_service.cpp]
2026-08-28 fix: let Core 1 own its own state, and keep Core 0 inside its stack
    Round 2 of the Task 7 review. Eight findings.
    C4/I11: RuntimeConfig stopped Core 1 with multicore_lockout and then rebuilt
    the binding table, the macro definitions and the step pool underneath it, and
    pushed a ReleaseAll into a queue whose only producer is Core 1. A lockout
    pauses a core at an arbitrary instruction, so both of those raced whatever
    Core 1 was in the middle of. Core 0 now posts the package through a
    ConfigHandoff and waits; Core 1 adopts it at the top of its own loop, where it
    is between one whole pass and the next, and says when it is done.
    C5: a rejected CDC frame walked handle_frame -> dispatch -> reply_e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
    [config_service.cpp, config_service.hpp, core1_runtime.cpp, core1_runtime.hpp, core_bridge.cpp, core_bridge.hpp]
2026-08-28 C1: let the output runtime recover from a full queue
    One submit() on a full queue latched OutputQueueFull, and from that instant
    every drain took the early branch forever: no keystroke, no mouse motion and
    no macro output reached the HID state again on either computer until the
    board was power-cycled. Nothing called clear_fault(), so nothing ever left
    that state.
    The latch now lives on Core 0. submit() - which runs on Core 1 - only
    increments an atomic refusal count, which is the one field the producer is
    allowed to write; drain() compares it against what it has already accounted
    for. A new refusal raises the fault, empties the queue and releases
    everything, exactly as before. A pass with n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
2026-08-28 C2: pace macro output so a TEXT macro reaches the far computer
    kMacroOutputsPerTick assumed both cores loop at the same rate. They do not:
    Core 1's pass is two controller ticks, Core 0's is tud_task, the CDC service,
    a drain, a publish and an SPI transaction. Core 1 offered sixteen commands per
    pass many times over while Core 0 removed thirty-two, so a TEXT step - up to
    1024 characters, four thousand edges, no delay between them - filled the
    127-slot queue within a millisecond and killed all input, and short of that
    typed nothing at all: Core 0 holds output state and not a queue of reports, so
    KeyDown 0x04 and KeyUp 0x04 applied in one drain leave the state exactly as it
    was and publish send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
    [core1_runtime.cpp, core1_runtime.hpp, main.cpp, test_core1_runtime.cpp, test_core_bridge.cpp, test_macro_reports.cpp]
2026-08-28 I1: stop throwing PC2's mouse motion away when the keyboard changed
    main consumed the PC2 snapshot before poll had decided anything with it:
    link.poll(now_ms, g_outputs.take_snapshot(Pc2)). poll sends one frame per pass
    and returns after KBD_STATE, so on every pass in which PC2's keyboard changed
    - every keystroke on that computer - the pass's accumulated mouse delta was
    consumed and never sent. The same happened whenever a send failed. Movement is
    a delta and cannot be asked for twice.
    poll now takes the source and asks it, in the shape UsbService::publish has
    always used for PC1: snapshot() up front, take_snapshot() only on the branch
    that has actually handed a mouse frame to the link. A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
    [main.cpp, spi_link.cpp, spi_link.hpp, spi_master.cpp, spi_master.hpp, spi_master_poll.cpp, test_spi_master_poll.cpp]
2026-08-28 I2/I3: make firmware, emulator and the contract agree on staging and release_all_count
    I3 - GET_STATUS's fourth field was reading diagnostics_.aborted_staging in
    firmware while compatibility.md, the emulator and the host's DeviceStatus all
    call it release_all_count. Added CdcDiagnostics::release_all_count, incremented
    it in the STOP_AND_RELEASE_ALL branch, and report that field at GET_STATUS
    instead.
    I2 - three transitions where firmware, emulator and the doc disagreed about
    staging state:
    - STOP_AND_RELEASE_ALL now aborts a pending write on the firmware side too,
    matching what compatibility.md has always said and what the emulator has
    always done.
    - HELLO now aborts a pending write on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
2026-08-28 I4: write docs/hardware/ch375-compatibility.md
    The plan's Locked File Structure and Task 3 Step 1 both named this file as a
    Create, and the Completion Gate's last bullet is entirely about it, but it was
    never written. Documents what exists today:
    - The eight descriptor vectors in tests/vectors/hid_descriptors/, what each
    represents, and for the six the parser accepts or refuses, the exact
    ParseError test_hid_parser.cpp pins for it and why (truncated records,
    an endpoint bigger than the CH375's 64-byte read buffer, no usable
    interface for hubs/vendor devices).
    - A physically-verified-devices section marked pending hardware acceptance,
    carrying only what was actually observed on 202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
2026-08-28 Add failing tests for a mouse left in its own report protocol
    The mouse on the bench sends seven bytes led by a Report ID, because nothing
    ever asked it to use boot protocol - so the identifier is read as the buttons,
    the buttons as dx, and dx as dy. boot=yes in the diagnostics says only that the
    interface advertises boot support, which is not the same thing.
    The fake chip now models a control transfer the CH375 has no command for: the
    setup packet into the endpoint buffer, a SETUP token at endpoint zero, and the
    status stage that is where a device actually applies the request. It answers
    the reports its current protocol produces, so a test can drive the normalizer
    with what the device real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
    [descriptor_setup.hpp, scripted_ch375.cpp, scripted_ch375.hpp, test_ch375_descriptor_setup.cpp, test_normalizers.cpp]
2026-08-28 Ask a boot-capable device to use boot protocol
    Nothing ever selected a protocol, so every device stayed in its own. The mouse
    on the bench leads each report with a Report ID, which was read as the buttons,
    the buttons as dx and dx as dy: a left button held down for ever, no horizontal
    movement, and sideways motion arriving as vertical.
    SET_PROTOCOL is not one of the three requests the CH375 has a command for, so
    the transport gains a general control-request path - the setup packet into the
    endpoint buffer, a SETUP token at endpoint zero, then the status stage, which
    is where a device actually applies the request. Neither half waits for
    anything: the answers are the interrupts the caller alr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
2026-08-28 Stop the compatibility record saying boot=yes meant boot protocol
    The bench note read the probe's boot=yes as the mouse being in boot protocol.
    It said only that the interface advertised support, and the mouse was in its
    own report format the whole time.
    Also says plainly what happens to a mouse that does not declare the boot
    subclass: it is not asked to switch, so it is read in whatever it sends.
2026-08-29 Repair 2: call the chip search from the recovery path
    Ch375Transport::find_chip walks the home rate and every ladder rung looking
    for a chip stranded where this side abandoned it, sends four filler bytes
    between attempts to clear a half-heard command, resets the chip where it finds
    it and brings it home. It had three tests and no production callers at all.
    Wired into the recovery path on the bench it revived a channel with no power
    cycle, first time all week: found=1, and found_elsewhere off zero for the first
    time because the search had never once run. This board has no reset line to
    either CH375 (docs/hardware/ch375-wiring.md gives RXD, TXD and INT), so the
    serial port is the only lever,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
    [device.cpp, device.hpp, main.cpp, scripted_ch375.cpp, scripted_ch375.hpp, test_ch375_device.cpp, test_ch375_transport.cpp, transport.hpp]
2026-08-29 Repair 3: prove a rung with a block read, and give the ladder a floor
    Measured on the bench, keyed on the port's real rate rather than the ladder's
    index:
    byRate(9600/37500/62500/115200): ok=0/1/0/0 fail=0/0/24/24
    115200 and 62500 answer CHECK_EXIST perfectly and fail every block read with
    framing errors accumulating; 37500 carries them, and the mouse enumerated and
    delivered reports there.
    Three things follow, and they are one mechanism.
    Prove a rung by the traffic it must carry. Ch375Transport now counts block
    reads completed and failed, and Enumerating watches those counts across
    setup_.poll. Two CHECK_EXIST replies prove a divider, not a link.
    Step down on repeated block-read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
    [descriptor_setup.hpp, device.cpp, device.hpp, scripted_ch375.cpp, scripted_ch375.hpp, test_ch375_device.cpp, transport.hpp]
2026-08-29 Repair 4: an idle channel re-proves its chip
    Ch375State::Absent asks whether a device is attached and reads silence as "no
    device". It has no way to notice that its chip stopped being a configured chip
    at all - and a CH375 whose 5 V was cycled under a running U1 is back at 9600
    with no working mode, deaf at the rate this side raised it to. The channel then
    waits in Absent for ever, which is the state this project cured by reflashing
    all week, and there is no reset line to reach the chip with either.
    An idle channel now asks one CHECK_EXIST a second and re-runs chip setup when
    it goes unanswered. The question is asked and left, like every other question
    put to a chip that may not answer: a s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
    [device.cpp, device.hpp, main.cpp, scripted_ch375.cpp, scripted_ch375.hpp, test_ch375_device.cpp]
2026-08-29 Correct two comments the four repairs made false
    The reply timeout's note defended 20 ms as "far below anything a person would
    notice", which measures human perception; what it costs is two and a half of
    the other channel's 8 ms poll windows, and Core 1 ticks the two in sequence.
    The ladder's collapse note still described going "off the ladder entirely at
    the bottom", which is what parked a live channel at 9600 and is exactly what
    repair 3's floor stops.
    [device.cpp, transport.hpp]
2026-08-29 Items 1 and 2: the interrupt status is asked for and collected later
    Item 1, the live defect. poll_interrupt called get_status, whose read_reply
    spins up to kDefaultReplyTimeoutUs. Measured on hardware at 11:31 with the
    build from 10efc55: worst pass round Core 1's loop 7296 us on an idle pair of
    channels and 20 168 us - exactly one reply timeout - once one channel had a
    device attached and stuck before Ready. Core 1 ticks the two channels in
    sequence, so that channel was taking two and a half of the other's 8 ms poll
    windows every tick, and the operator saw it as "the cursor works
    intermittently, with interruptions; the keyboard does not type".
    Reading the status is also the only thing tha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
    [device.cpp, device.hpp, scripted_ch375.cpp, scripted_ch375.hpp, test_ch375_device.cpp, transport.hpp]
2026-08-29 Item 3: the two hollow tests are made to measure something
    a_chip_that_answers_nowhere_is_not_hunted_for_every_second used go_silent, so
    the search found nothing at any rate and both counters read zero whether or not
    the unanswered_probes_ >= kProbesBeforeChipSearch guard existed. It is the sole
    remaining guard on the standing constraint - never write a command at a port
    rate that has not just been proved - because the two recover_from tests that
    used to hold it were deleted with recover_from.
    It now strands the chip at 115200, where the search would find it, and looks at
    the wire: FakeCh375Chip records the port rate every command byte was written at,
    and wrote_commands_away_from(9600) says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
2026-08-29 Item 4: a chip is not declared lost on one missed byte
    Any result other than Answered-and-matched set presence_lost_, cleared
    chip_ready_ and re-ran the whole of chip setup - RESET_ALL, sixty milliseconds
    of waiting, a probe, a mode command and the climb back up the baud ladder,
    about a second of a working channel doing nothing. The far cheaper search for a
    chip that has moved is guarded by kProbesBeforeChipSearch = 3; this was guarded
    by nothing at all.
    kPresenceProbesBeforeLost = 2 now. Two, not three, and the retry is immediate
    rather than a second later - last_presence_us_ is deliberately left where it
    was on a miss - so a second opinion costs one reply timeout and a chip that
    really ha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
    [scripted_ch375.cpp, scripted_ch375.hpp, test_ch375_device.cpp]
2026-08-29 Item 5: four comments that asserted what the code does not do
    transport.hpp, poll_chip_search: "Never waits" was true of the reply and false
    of the step. A step that changes the rate calls set_port_baud, and on hardware
    PioCh375Transport::set_baud spends about 3.5 ms in two mandated sleeps -
    kFrameTailUs so the last frame leaves at the old rate, kBaudChangeUs because
    DS1 5.2 says the chip answers at neither rate for about a millisecond after the
    change. At most one rate changes per step, so 3.5 ms is the worst a step costs.
    transport.hpp, kDefaultReplyTimeoutUs: the note said the paths that ask a chip
    which is not answering do not use it as a spin. After item 1 more of them do
    not - the pre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
2026-08-29 The tick budget is measured across attach-to-Ready, and fails
    The two existing budget tests cover a chip that is deaf from the start and
    one that holds INT and answers no status. Neither reaches the stretch the
    hardware is stuck in - attached=1, ready=0 - so the 20 ms commands that run
    there survived both.
    This walks attach, Resetting, HostMode and Enumerating against a chip that
    answers its own bring-up and then stops, at each command boundary in turn,
    and measures the worst tick across the whole stretch. Measured now, before
    any conversion: 40 000 us at one stall point and 20 000 us at the rest,
    against the 20 170 us the board reported at 2026-08-29 12:06.
    It runs against the real Descri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
    [scripted_ch375.cpp, scripted_ch375.hpp, test_ch375_device.cpp]
2026-08-29 command_with_status is asked and left, so SET_USB_MODE stops spinning
    The command behind set_usb_mode at all five points of a device's life: the
    attach, the mode that ends the bus reset, the recovery cycle, the detach, and
    chip setup's own mode 5. Each spun for up to a whole kDefaultReplyTimeoutUs,
    and the channel measured on hardware at 2026-08-29 12:06 - attached=1,
    ready=0 - sits in exactly the stretch that runs them.
    begin_command_status writes the command and its argument and returns;
    poll_command_status collects the byte on a later tick and keeps it, because
    "it refused" and "it said 5FH" are different facts. A question that timed out
    leaves command_status_succeeded false: silence is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
    [device.cpp, device.hpp, test_ch375_device.cpp, test_ch375_transport.cpp, transport.hpp]
2026-08-29 get_device_rate is asked and left, and silence stops meaning full speed
    It runs once on every attach, in mode 5, which is the only mode DS2 1.2 says
    the question is valid in - so it is the first thing that happens to a channel
    after a device arrives, and the channel measured on hardware at 2026-08-29
    12:06 was stuck at attached=1, ready=0. Two commands were being spun for in
    that stretch; this is the other one.
    begin_device_rate / poll_device_rate, with PendingReply::DeviceRate as the
    owner. low_speed is written only when a byte actually came back.
    The old line was device_is_low_speed_ = get_device_rate(low) && low, which
    collapsed "the chip did not answer" into "full speed". A low-speed m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
    [device.cpp, device.hpp, main.cpp, test_ch375_device.cpp, transport.hpp]
2026-08-29 drain_pending_status is asked and left, and has one reader again
    Three production callers, not the one the review named. Chip setup drops a
    status the chip is holding after RESET_ALL; DescriptorSetup::begin and
    AutoSetupEnumerator::begin each did the same before configuring a device. All
    three blocked for a whole reply timeout on a chip holding its interrupt line
    down and answering nothing, which is the chip a bring-up is being run for.
    Chip setup's is now begin_status_drain plus ChipBringUp::Draining: the
    question goes out with RESET_ALL and the answer is collected inside the 60 ms
    restart this has to sit out anyway, so it costs nothing.
    The two in begin() are deleted rather than converte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
    [descriptor_setup.cpp, device.cpp, device.hpp, enumerator.cpp, test_ch375_descriptor_setup.cpp, test_ch375_device.cpp, test_ch375_enumerator.cpp, transport.hpp]
2026-08-29 Repair the probe's call into the transport's deferred status exchange
    The status commands became tick-spanning so a stalled channel cannot hold
    Core 1's loop for 20 ms, and ch375_probe.cpp was left calling the removed
    synchronous form - so the pico-ch375 image stopped building while the native
    suites went on passing. Native tests do not compile this file.
    The probe runs once, before the loop it would otherwise be spanned across
    exists, so it drives the same deferred exchange to completion itself rather
    than reaching for a synchronous form that no longer exists. The bound is the
    transport's own reply deadline.
    [ch375_probe.cpp]
2026-08-29 Teach the fake chip that an idle endpoint NAKs
    The fake answered every IN token with Success whether or not the device had
    anything to say, so the one thing a HID device does most of the time - nothing
    - was the one thing the suite could not see. With that modelled, three existing
    tests fail exactly the way the bench does: polling drops to one token per
    hundred milliseconds, a device that is merely idle is declared lost, and the
    collapse walks the baud ladder off 115200.
    The chip's retry policy is modelled with it, because it is what decides
    whether a NAK becomes an interrupt or a transaction that never finishes, and
    it is put back to the chip default on every working mode - the same undoin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
    [scripted_ch375.cpp, scripted_ch375.hpp, test_ch375_device.cpp]
2026-08-29 Stop reading a device with nothing to say as a device that has gone
    Two repairs to the same fault.
    The chip is told to report a NAK rather than retry it (SET_RETRY, DS2 1.3)
    once, during chip setup - and then three working modes go past before the
    device is ever polled. A working mode is already known to undo the other
    per-transaction setting, the bus speed (DS2 1.1), which is why set_usb_speed
    is re-issued after each one; the retry policy is now re-issued in the same two
    places and for the same reason. On the default the chip retries a NAK on the
    bus instead of reporting it, so a poll of an endpoint with nothing to say
    never finishes and never raises an interrupt. On the bench that was for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
    [device.cpp, device.hpp]
2026-08-29 Let the unanswered token carry the whole of the teardown
    The teardown's evidence had a second source: a status read the controller
    would not answer counted as a failed poll too. Removing it changes no test,
    including the one added here for the state it was written for - a controller
    holding INT asserted and answering no status at all, which is what the
    keyboard's channel was measured in at 11:31. The polls are still issued past
    that read and still go unanswered, so the device is still declared gone and
    everything it held is still released.
    So the branch went. This branch has shipped enough code that nothing calls and
    nothing distinguishes.
    The starved-channel test now spends every re-arm i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
    [device.cpp, test_ch375_device.cpp]
2026-08-29 Teach the fake a device that NAKs while it settles
    The mouse channel could not enumerate at all: fifty-five setup attempts,
    every one ending 0x2A, boot protocol advertised and never selected. The
    NAK-report policy that cured the idle teardown is right for a poll of an
    interrupt endpoint and wrong for a control transfer, where a NAK is
    "busy, ask again" and the asking is the chip's to do.
    The fake now models a device with settling NAKs in it and a chip that
    either waits them out on the bus or hands the first one to the MCU,
    according to the policy it holds. Two checks go red against the
    unchanged firmware: a device that NAKs never reaches Ready, and the
    policy in force during enumeration is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
    [commands.hpp, scripted_ch375.cpp, scripted_ch375.hpp, test_ch375_device.cpp]
2026-08-29 Give each phase of a channel's life the NAK policy it needs
    The retry policy is no longer one setting for the whole of a channel's
    life. Enumeration and every control transfer before it run under
    kRetryWaitOutNak, where the chip waits a NAK out on the bus - which is
    what a device that is still settling needs, and what the chip did by
    default before the previous commits set the reporting policy after each
    working mode. The moment enumeration completes and the interrupt
    endpoint starts being polled, the policy becomes kRetryReportNak, so a
    NAK arrives as evidence the device is still there and the quiet timer is
    refreshed by it.
    Set after the last working mode in each case: the enumeration pol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
    [device.cpp]
2026-08-29 Reproduce the macro's lost letters on a clock that is not the test's
    The macro rig that proved C2 fixed runs Core 0 exactly once per millisecond
    and lets the endpoint take every report it is handed. Hardware gives neither,
    and at other rates the same command stream loses letters - and loses different
    ones on each computer, which is what the operator saw: PC1 short of most of
    `PROFILE-3 `, PC2 with a wrong answer of its own.
    This rig runs both cores on a microsecond timeline with their periods as
    parameters, gives Core 1 a turn between one pop and the next - a second core
    does not wait for a drain to finish - and collects the keyboard endpoint on
    the host's own frame grid. It then asks the o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
    [test_macro_publication.cpp]
2026-08-29 Hold the keyboard state until both computers have been told it
    The macro's pacing gate waits for the command queue to be empty and for a
    millisecond to pass. Neither of those is the thing that has to be true. The
    queue empties the instant Core 0 *pops* a command, not when the state it
    produced is published, so two edges can land in one drain and the press and
    its release cancel; and drain runs before publish in Core 0's loop, so a state
    the endpoint was too busy to take last pass is overwritten before the retry
    that would have sent it. Both are the same defect: this side holds a state,
    not a queue of reports, and a state replaced before anyone saw it is a
    keystroke that never happened - or a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
    [main.cpp, output_runtime.cpp, output_runtime.hpp, spi_master.hpp, spi_master_poll.cpp]
2026-08-29 Test the two halves of an answer, and the letter that repeats
    Three mutations survived the first round of tests, and each named a real gap.
    A key release that failed to mark the state unpublished changed nothing in
    `PROFILE-3 `, because every letter there differs from the one before it: the
    host infers a release from the next report having a different key down. Ten
    of the same letter cannot be read that way - the state after the second press
    is identical to the state after the first - so the sweep now types the
    acceptance's own REPEAT macro as well, and counts the keystrokes.
    The other two were about what an answer means. A sender with nothing to send
    still has to say the far side is up to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
    [output_runtime.hpp, test_macro_publication.cpp]
2026-08-29 Commit the acceptance tooling the acceptance was run with
    The eight-profile configuration that Step 4 was accepted against was built,
    verified, deployed and restored by tools/step4_acceptance_config.py, and the
    18 tests that cover it — including the whole deploy path driven against the
    emulator through the production DeviceService — were never in the branch. So
    the evidence behind the acceptance could not be regenerated and those tests
    never ran anywhere but one machine.
    hardware-backups/ is deliberately not tracked: those files are configurations
    pulled off a board, bench state rather than source, and restoring one needs
    the file rather than its history. .test-tmp/ is scratch that agen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
2026-08-29 Stage the flip between the two reads, not around them
    The core-bridge ordering test set "no capture running" and "an answer is
    waiting" in the same pass, which both orders answer the same way. It never
    put Core 1's two stores inside Core 0's two loads, so reversing the
    production order left all three linking suites green.
    The stand-in runtime now finishes the capture on the first of the two reads,
    whichever the code under test calls first. Reading the state first sees a
    capture still running and the take that follows finds the answer; taking
    first finds nothing and the state read after it says the capture is over, so
    the pass emits no event and the answer is refused for want of a capture to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
    [test_core_bridge.cpp]
2026-08-29 Ask capture whether it swallowed the release
    The swallowed-release assertion ran through Core1Runtime, where
    BindingEngine::handle only emits an up-event for a key it remembers passing
    down. A release capture leaked was dropped downstream regardless, so
    suppressing capture's own bookkeeping left all six linking suites green. The
    behaviour was safe; the coverage was measuring the engine.
    CaptureController now has a unit suite of its own, asserting its
    CaptureDisposition directly: the release of a swallowed key, modifier and
    mouse button is swallowed, a release of something never swallowed passes
    through, and a cancelled capture still owes the releases of what it took.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
    [test_capture.cpp]
2026-08-29 Delete the RX sweep that was never written
    kRxSweepAfterFailures, rx_sweep_hit(), rx_swept() and both backing fields had
    no writer and no reader anywhere - not in the firmware, not in the
    diagnostics reply, not in a test. git grep now finds the names nowhere in the
    tree.
    rx_sweep_hit()'s comment was the reason not to leave them: it explained how
    to read a value that "means the chip really is saying nothing" against a
    sweep that does not exist, so anyone reading the permanent zero would have
    concluded something about the hardware. The one remaining mention of a sweep
    is device.cpp's note that this code deliberately does not do one, which is
    true.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
2026-08-29 End the wait with the state it was waiting for
    The queue-full branch of drain clears the queue, releases everything on both
    computers and applies nothing - but left waiting_ set, with a timestamp from
    a wait that began before the release. The next keyboard command then found a
    grace that had already expired, set both computers aside as silent without
    either having been silent, and applied the whole budget in one unpaced drain:
    presses collapsing against their own releases, and neither host seeing a
    keystroke.
    The release that pass makes is itself a keyboard state nobody has been told
    about, so the wait for it starts there. One line, and a test that fails
    without it.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
    [output_runtime.cpp, test_output_runtime.cpp]
2026-08-29 Start a profile in the routes it is stored with
    Spec section 11 gives every profile a starting KeyboardRoute and a starting
    MouseRoute. The format carries them, the validator checks them, the
    configurator writes them and ProfileView reads them - and nothing anywhere
    called those two accessors, so a profile became active and left the routes
    wherever the last one happened to put them.
    Applied in set_profile_now rather than only in swap_profile: four paths make
    a profile active - the constructor, a configuration write, boot, and a swap -
    and the boot path is the one a starting route is most about, since the device
    comes back up in the configuration's own active profile. Every one of them
    has a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
    [config_profiles.cpp, config_profiles.hpp, core1_runtime.cpp, core1_runtime.hpp, test_core1_runtime.cpp, test_core_bridge.cpp, test_macro_publication.cpp, test_macro_reports.cpp]
2026-08-29 Record report traces from real devices, which the vectors never had
    The plan asks that captured keyboard and mouse vectors normalize
    deterministically, and the corpus held descriptors only - eight of them,
    synthetic. A descriptor says what a device claims it will send; a trace says
    what it sent. The normalizers were tested against the first and never the
    second.
    These are traces off two real devices through the probe build's diagnostics:
    26 distinct keyboard reports covering letters, digits, space, Enter, F-row
    keys, a modifier alone and a modifier with a key, and 59 distinct mouse
    reports covering both axes in both directions and button presses.
    The diagnostics report a packet's size and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
2026-08-29 Replay the captured reports instead of the ones we imagined
    The normalizer suites write their own reports. That proves the code does
    what its author believed a keyboard does; it cannot prove the belief. The
    corpus recorded off real devices can, so this replays all 26 keyboard and
    59 mouse reports and pins the exact event stream - kinds, codes, and the
    signed deltas.
    What the corpus does not carry is asserted nowhere. Only the first four
    bytes of each report were observed, so keyboard reports are padded to
    eight with zeros in the four unobserved slots and mouse reports are
    truncated to the three bytes the device actually sent. Both are named in
    the test as the assumption they are.
    Co-Author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
2026-08-29 Let the device do the thousand toggles nobody should press by hand
    The roadmap asks for a thousand physical route toggles and the acceptance
    did five. Somebody pressing a key a thousand times is not observing
    anything by the ninth hundred, so the toggling is device-driven: one
    macro spends its whole 64-step budget on 32 route changes, each followed
    by one character, and 32 runs make 1024 - the roadmap's thousand, from 32
    deliberate presses.
    The character after each toggle is the load and the evidence. It goes to
    both computers, so each must end with exactly 1024 of them; a shortfall
    is the only outward sign that a start was refused or a command dropped.
    The operator script renders from the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
2026-08-29 Record what boot protocol costs, on every mouse
    The wheel does not work, and the reason is not a bad device: a
    boot-protocol mouse report is three bytes - buttons, dX, dY - with no
    wheel byte in it. The operator found it on hardware and every one of the
    59 captured reports is three bytes long, so it is recorded as current
    behaviour beside the other limits.
    It is placed under the Report ID limit because the repair is the same
    one: read the report descriptor and run the device in its own protocol
    instead of forcing boot. One change buys back both.
2026-08-29 Put the toggle run on keys the operator's keyboard has
    The acceptance asked for Insert and Home. The keyboard it is run on is a
    compact layout with neither, so the procedure could not be started at all.
    Every key the script names is now an arrow: Up runs a toggle, Down moves the
    keyboard to the other computer (F10's twin, so the stranded-modifier check
    can be made on both without an Fn layer), Right brings it back. The
    navigation cluster keeps its bindings beside them, as the Step 4
    configuration already does.
    The ceremony went with it. Left Shift is held once for the whole run instead
    of re-gripped between presses - S4c accepted that release on hardware across
    an unplug and a reconnect, an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
2026-08-29 Keep the execution record, which lived only in an ignored directory
    Two days of work were tracked in .superpowers/sdd/, which .gitignore excludes.
    That directory holds what the commits cannot: every ruling made on the
    operator's behalf and what it would cost if wrong, the measurements behind each
    hardware claim, and — most of it — the hypotheses that were refuted. Three
    confident diagnoses died to evidence in this work, and a record that keeps only
    the surviving one teaches the wrong lesson about how it was found.
    It also holds the reproduction instructions for findings nobody has fixed yet:
    what the wheel costs under boot protocol, which capabilities are written and
    never called, what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
2026-08-29 Parse a mouse report descriptor - not yet wired to anything
    Half of the wheel repair. This reads a HID report descriptor and works out
    where the buttons, axes and wheel sit and whether a Report ID prefixes the
    reports, with 397 lines of tests over it.
    Nothing calls it. `grep -rn parse_mouse_report_descriptor firmware/` finds the
    definition and nothing else, so on a board this changes exactly nothing: every
    mouse is still forced into boot protocol and still has no wheel.
    Committed in that state deliberately, and labelled as such, because this
    project has shipped twelve capabilities that were written, tested and never
    called - and an uncommitted one would have been worse than an unwired one.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
2026-08-29 Make the report-descriptor tests able to fail
    A mutation pass over the inherited suite killed six of fifteen. Three of
    the survivors were tests that named the behaviour they were meant to
    guard and did not reach it:
    - the twelve-bit axis test packs both axes back to back, so Y lands on
    bit twenty and is refused for not starting on a byte. The width check
    behind it was never executed; an axis of any width would have passed;
    - "a refused descriptor leaves the caller nothing half filled" refuses
    at the first step, where no layout has been built. The one path where
    a finished layout exists and could be written out by mistake - a real
    pointer whose fields cannot be named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
    [test_report_descriptor.cpp]
2026-08-29 Read a mouse report through the layout the mouse declared
    MouseNormalizer had three byte offsets written into it - buttons at zero,
    dX at one, dY at two - and a `set_report_id` flag that nothing outside the
    tests ever called. That is boot protocol's layout, and it is the reason
    the wheel is dead: a boot report is three bytes and stops before it.
    The flag is gone rather than joined by a second way of saying the same
    thing. In its place is the whole layout the report descriptor parser
    already produces: where each field sits, how wide it is, and which
    identifier this device's own reports carry. Fields are read only when the
    report is long enough to hold them, so under the boot layout the wheel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
2026-08-29 Read how long the report descriptor is while the configuration is open
    Fetching a report descriptor means a GET_DESCRIPTOR that says how many
    bytes to ask for, and the only place that number exists is the HID class
    descriptor sitting between an interface and its endpoints - a record this
    parser walked straight past.
    It belongs to an interface, not to a device: the composite in the corpus
    declares twenty-five bytes on its consumer interface and sixty-three on
    the keyboard behind it, and taking the wrong one asks a device for part
    of a descriptor it does not have. So the length is collected per open
    interface and carried onto the candidate only when its endpoint is found.
    Both of the record'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
    [hid_parser.cpp, hid_parser.hpp, test_hid_parser.cpp]
2026-08-29 Fetch a mouse's report descriptor and run it in its own protocol
    The parser has been sitting here since yesterday with nothing calling it.
    This is the caller.
    After the configuration is chosen, a mouse that declared a report
    descriptor is asked for it: GET_DESCRIPTOR, type 0x22, addressed to the
    interface the configuration parser picked. The controller has no command
    for that one - its GET_DESCRIPTOR knows the device and configuration
    descriptors and nothing else (DS2 1.11) - so the setup packet is assembled
    by hand, the way SET_PROTOCOL already was.
    The answer does not arrive in one piece. Endpoint zero carries eight bytes
    on a low-speed mouse and a mouse's report descriptor is fifty to a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
2026-08-29 Hand the layout to the normalizer that reads the reports
    The last link. The layout was being parsed and kept and nothing downstream
    had ever been told about it, which is where the parser was a day ago.
    It travels with the device kind, on the same Ready event and for the same
    reason: that is the moment the device has been identified and the moment
    before its first report. A keyboard ignores it - its boot report is fixed
    by the specification - and a mouse whose descriptor could not be read is
    handed boot protocol's layout explicitly rather than left with whatever the
    mouse before it declared.
    Two build lists had never heard of report_descriptor.cpp: the firmware's
    own, and the four native ta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
    [main.cpp, test_input_pipeline.cpp]
2026-08-29 Say in the probe report where the wheel is, or why there is not one
    The bring-up build prints two answers about boot protocol precisely because
    printing one of them was read as the other for weeks. The descriptor path
    adds a third question - was this mouse read through its own layout, and if
    not, which of six things stopped it - and none of it was visible.
    So one line per device: layout=own or boot, the status byte that says why,
    how many descriptor bytes arrived, and the offsets themselves. A wheel
    offset inside the report size the device is actually sending is the whole
    repair, in one place, on hardware.
    The report buffer was 900 bytes for two devices' worth of text and did not
    have room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
2026-08-29 Record what the wheel repair does and what is still only written down
    The design, how an oversized descriptor is handled at both sizes, all
    sixty-five mutations with their results, the four survivors in inherited
    parser behaviour that have no test at all, the one documented equivalent
    mutant, and every command's output.
    And plainly: every report-protocol fixture in this change is synthetic.
    The corpus holds boot reports only, because boot protocol is the only
    thing anything on this bench has ever been asked for, so what these tests
    prove is that the firmware does what HID 1.11 says - not what the mouse on
    this bench does. What would settle that is listed, in order.
    Written to .superpowers/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
2026-08-29 Fix report-protocol mouse wheel handling
    [descriptor_setup.cpp, descriptor_setup.hpp, main.cpp, report_descriptor.cpp, report_descriptor.hpp, scripted_ch375.cpp, scripted_ch375.hpp]
2026-08-30 Give the error codes the one home every protocol identifier has
    The host learned its CDC error codes from the emulator and the firmware
    from a hand-written copy, so the two could disagree without either file
    changing. The numbers now live in protocol/schema.json and reach both
    sides through generated code, which is where every other identifier on
    this link already comes from.
    [config_service.hpp]
2026-08-30 Let the hardware tests say what the device said
    The real-device file waited only for operation_succeeded, so a board that
    refused a request in two milliseconds and a board that was never plugged
    in both arrived as "not emitted in 5000 ms". Every wait now listens for
    the failure too and reports the operation, the reason and the device's
    error code. The status test was renamed to what it actually asks for -
    diagnostics - and two tests pin the shapes the investigation turned on:
    a diagnostics reply the host cannot read is a named failure, and a
    DEVICE_INFO request is refused with one byte by both implementations.
2026-08-30 Count how long the device took, rather than averaging it
    The specification bounds a percentile and a percentile cannot be recovered
    from a mean. Keeping every sample is not available either: this part has no
    filesystem and streaming timestamps out would change the latency being
    measured.
    A histogram with 20 ms and 50 ms as bucket edges answers the two questions
    the specification actually asks exactly - "at least 95% at or below 20 ms"
    is a count, not an estimate - and refuses to answer for any other bound
    rather than interpolating one.
2026-08-30 Let the device say how long it took, from the one clock it has
    A CH375 report now carries the microsecond it was read out of the
    controller. Core 1 stamps every command that report produces with it, and
    Core 0 subtracts it from the microsecond it applies the command. Both ends
    are on this board and on the same clock, so the difference is measured
    rather than estimated.
    This is U1's own interval and nothing else: not the peripheral's polling
    ahead of it, not USB or the SPI link behind it, and not the far computer.
    The device has no clock at either end of that journey, so it does not
    claim one. Commands with no originating report - macro steps, a button on
    the case - are stamped zero and left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
2026-08-30 Read the latency the device counted, and refuse to sharpen it
    The device sends bucket counts and the edges they were counted against.
    That answers "p95 <= 20 ms" exactly and does not answer "what is the p95"
    with a number, so the host brackets the percentile between two edges the
    device actually reported and refuses any bound that is not one of them.
    A p95 in the overflow bucket comes back as None rather than as the last
    edge: above 50 ms with nothing tighter known is a real answer, and it is
    not a pass. No samples raises rather than reporting zero, because a device
    that saw no input would otherwise look like the fastest ever built.
    The block is optional - the emulator has no input pipelin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
2026-08-30 Say which peripherals are on U1's own ports
    A device plugged into U1 is on U1's bus and not on either computer's, so no
    host can enumerate it and no operator transcribing a label is producing a
    measurement. Enumeration already read the device descriptor and threw its
    two identifying fields away; it now keeps them, hashes whatever report
    descriptor the device gave up, and GET_DIAGNOSTICS reports both ports
    whether or not anything is on them.
    A port with nothing on it is a fact about the run, not an absence to be
    inferred from a shorter reply. A device that gave up no report descriptor
    gets no hash rather than the hash of an empty buffer, which every such
    device would otherwise share. A boot-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
    [config_service.cpp, config_service.hpp, descriptor_setup.cpp, descriptor_setup.hpp, main.cpp, test_ch375_descriptor_setup.cpp, test_config_service.cpp]
2026-08-30 Make the HIL runner measure, and name what it cannot
    It refused every scenario before this, on the grounds that it could not
    tell a rig that exists from one that does not. It still refuses without a
    board. With one it now reads what the device counted about itself and
    decides every check the scenario names, or records the check as unmeasured
    with the reason and the rig it would take.
    There is no third state. A check that matches neither table is recorded as
    undecided rather than dropped, so a check added to a scenario later cannot
    become a silent pass, and a run with anything undecided is "partial" with
    its own exit code - never "passed".
    Two phases, because a counter that only climbs says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
2026-08-30 Write down what the runner measures and what it never will
    The ruling, in the ledger and in the report rather than only in a commit
    message: this rig measures U1's own interval, from a peripheral report
    reaching its input core to the command being applied on its output core.
    It does not measure the specification's end-to-end keystroke latency and
    cannot - there is no clock on a finger and nothing injects HID into U1's
    peripheral ports.
    The two must not be swapped because the internal figure is one term of the
    external sum and not the largest. A firmware-internal p95 of 1 ms is
    compatible with an end-to-end p95 of 35 ms, so the number would be true
    under a heading that made it false, and the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
2026-08-30 Let the device say what it is instead of the socket it is in
    Each peripheral row took its `role` from the CH375 channel the device was
    plugged into. On this bench the channels are crossed - the mouse is on the
    channel the firmware calls "keyboard" - so the report printed
    role: "keyboard" reason: "enumerated as mouse, 75 bytes of report
    descriptor, 5 buttons declared"
    The row contradicted itself, in the one artifact whose entire job is to say
    which device is which. A compatibility matrix that misnames a device is worse
    than one that omits it: the reader has no way to see the error.
    `role` is now `port.kind` - the kind enumeration read out of the device's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
2026-08-30 Put the two verified devices on the matrix by what a reader can match
    `compatibility-matrix.md` said no hardware run had been recorded. One has. It
    now carries the two devices the 2026-08-30 `peripherals` run read off U1's own
    bus, keyed by **VID, PID and report-descriptor SHA-256** rather than by brand
    and model: those are what a reader can check against their own hardware, and a
    model number is not - the same box ships different silicon across revisions.
    The keyboard gave up no report descriptor, so its hash cell says that instead
    of carrying the hash of an empty buffer, which every such device would share.
    The measured figures go with them: keyboard p95 ≤ 2 ms over 304 samples, mouse
    p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
2026-08-30 Ignore the HIL artifacts directory
    Scenario reports are recordings of one rig at one moment: they name the ports,
    the counters and the two devices attached that afternoon. The one report the
    compatibility matrix cites is committed deliberately; the rest are outputs, and
    a release build refuses a dirty tree for good reasons.
2026-08-30 Build the configuration the operator uses, not one they test with
    The two configurations that existed are acceptance rigs. They bind F1-F8 to
    the eight profiles and all four arrows to macros, which is what an acceptance
    needs and what a working day cannot survive: the function row stops renaming
    and refreshing and the arrows stop moving the cursor.
    --config operator takes five triggers and leaves the rest of the board alone.
    F9, F10 and F11 move the keyboard to PC1, PC2 and both; F12 and mouse button 4
    are the same mouse toggle, one under each hand. No macros, no profile keys,
    nothing on a key this compact keyboard does not have. One profile carries all
    of it and the other seven stay pristi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
2026-08-30 Ignore the assembled release folder
    build_release.ps1 refuses a dirty tree, so the folder it produces must not make
    the tree dirty. Its inputs are tracked and its output is reproducible from
    them, hashes included.
2026-08-30 Ask --check whether the protocol matches, not whether bytes do
    `generate_protocol.py --check` compared the generated files byte for byte
    against freshly rendered output. The generator writes LF; git hands Windows
    CRLF. On any fresh checkout the two disagree on every line, so --check exited
    1 - silently - and `build_release.ps1` refused to build with 'the generated
    protocol is out of date'. A release could only be built from a tree where
    someone had already run the generator.
    Compare by lines instead, which is the question --check is meant to answer:
    do the checked-in files still describe protocol/schema.json? A stale file now
    names itself and prints a unified diff, because an exit 1 that pr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
2026-08-30 Date the firmware images by the commit, not by the clock
    The Pico SDK stamps __DATE__ into the binary info block, so the same commit
    built on two days gave two images differing in exactly two bytes at offset
    190122 - "Aug 30 2026" against "Aug 28 2026". Everything else matched, so the
    build was already deterministic in every other respect; SHA256SUMS.txt simply
    described one afternoon rather than one commit, and the roadmap's "reproducible
    from clean checkout" was not true.
    Derive the date instead: SOURCE_DATE_EPOCH when the environment sets it (the
    cross-ecosystem convention for this), otherwise the committer date of HEAD, and
    pass it to the SDK as PICO_PROGRAM_BUILD_DATE. The field stays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
2026-08-30 Say what the completion gate can actually claim about the installer
    The gate said "Two versioned UF2 and one Windows x64 installer are reproducible
    from clean checkout." Half of that is now true and stays a gate; the other half
    was never true and cannot be made true from this repository.
    Two causes were measured. Nuitka stamps DuoInput.exe's PE TimeDateStamp with the
    build clock, so the installer's payload differs before Inno Setup is invoked.
    Inno itself is deterministic - two back-to-back compiles of an untouched probe
    project hash identically - but it records each payload file's modification time,
    and a freshly built dist folder has fresh mtimes.
    The mtime half could be normalised here.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
2026-08-30 Tick the foundation plan against what its ledger already proved
    All 35 steps of the seven foundation tasks landed on 2026-08-25 and nobody went
    back to the boxes. Each task now carries the commit range, the commits inside it
    and the ledger line that records its independent review, so a reader can check a
    tick rather than trust it.
    Two things are recorded as deviations rather than ticked quietly. Task 7's Step 1
    red state was never a crashing seed - the parsers were already hardened, and
    manufacturing a crash would have regressed the product - and Steps 2 and 4 were
    closed a day later at c27a314, when a Clang/libFuzzer toolchain existed, with the
    run counts and the empty artifact directories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
2026-08-30 Tick the input runtime plan against hardware, and name the four gaps
    Twelve of the seventeen open steps were done and never marked: Task 2 entire,
    Task 3's and Task 4's and Task 5's commits, Task 4's trace replay, and Task 7
    including the hardware acceptance of 2026-08-29. Each now carries the commits
    and the ledger line behind it, with S4a's discriminating detail kept - the
    device came back up in profile 3, the one the configuration names as active,
    which the fallback to profile 0 would not have produced.
    Five stay unticked. Three are red-state steps whose test and implementation
    landed in one commit, with no record anywhere of a failing run; a fourth is
    Task 7's, where the ledger claims t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
2026-08-30 Close three release steps, and keep the clean-VM smoke open
    The Pico build the automated gate was missing now runs; the HIL scenarios ran on
    the board; the release folder is assembled and was rebuilt after be5d35a so its
    hashes describe the tagged commit rather than an afternoon. Those three steps are
    ticked with what was measured written beside them - 304 keyboard and 33 321 mouse
    samples, p95 under 2 ms against a 20 ms budget, no gap over 50 ms.
    Under the same ticks, in the same blockquotes, is everything the run could not
    reach: end-to-end keystroke latency this rig cannot measure at all, U2's release
    on a link loss nobody staged, eight of ten peripherals, the open soak. A tick
    that hid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
2026-08-30 Say what the roadmap's gate can claim, bullet by bullet
    Fourteen of the roadmap's twenty steps were done and unmarked; each now names
    the range, the tag or the counter behind it. Six stay open and say which kind of
    open they are: two phase tags that were never created, one step whose subordinate
    plan has a hardware acceptance it can no longer run, one that recorded three of
    its four measurements, and one fail-safe review that nobody can point at - there
    is no ledger for the core firmware plan at all, so if it happened it left nothing.
    Task 2 Step 1 is left unticked although 34 of its 35 subordinate steps are done,
    on purpose: the one open step is a bullet of that plan's own gate, and leavin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
2026-08-30 Give the interface a visual language instead of Qt defaults
    There was no styling anywhere in the package: stock widgets, whatever font
    the platform happened to hand over, and spacing that came from nobody's
    decision. This adds the one module that decides how things look, and nothing
    else changes yet.
    The palette carries meaning rather than decoration - blue for what you can
    act on, green for two things that agree, amber for two that do not, red for
    failure and for the one button that overwrites the device - and the parts of
    that which are measurable are asserted: contrast against every ground a
    colour is used on, the type scale, the spacing grid, and that no two signals
    can be mistaken for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
2026-08-30 Say where the project stands without being asked
    The shell had one place that mentioned any of the three states section 18.5
    distinguishes: an asterisk in the title bar. Everything else - whether the
    file on disk is current, whether the device is holding this configuration -
    had to be found on the Overview page, one card down.
    A state strip under the toolbar now shows all three at once, and always all
    three. Any one of them alone invites the wrong conclusion; a saved file says
    nothing about what the hardware is running, so the strip never hides the two
    that happen to be settled. Each chip carries a word as well as a colour.
    The two buttons that write something now look like what they do: S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
2026-08-30 Let the operator choose which mouse button switches PCs
    The Mouse page offered "Button 1/2/3" and nothing else, so a side button
    could never be bound and the one that was already switching PCs could not
    be moved. The page now has a Detect button beside the chooser: it waits ten
    seconds for a mouse button, ignores keypresses, and rearms without handing
    out a fresh countdown. Buttons read as Left, Right, Middle (wheel) and Side
    1/2 in both languages, and applying a binding replaces the switch that was
    there instead of adding a second one.
    Observations now belong to the shell. Protocol v1 says a mouse is attached
    but never how many buttons it has, so a captured button 4 or 5 exists only
    as evi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
2026-08-30 Answer the mouse button the operator actually chose
    A binding on a mouse button fired one button along. The configuration
    format numbers buttons from one, because the validator treats zero as "no
    button", while the input pipeline numbers them from zero, because they are
    bit positions in the mouse report. The engine matches a binding against an
    event straight, and nothing translated between the two, so a binding on
    button 4 answered button 5 - and a binding on button 5 answered a bit no
    mouse ever sets, which made it dead. Rebinding a side button therefore
    looked like it did nothing: the old button kept switching and the new one
    never started.
    config_profiles renumbers on the way in, beside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
    [config_profiles.cpp, test_stored_profiles.cpp]
2026-08-30 Write down what the visual refresh actually changes
    Variant C of three mocks, with one correction the mock itself hid: its
    terracotta accent cannot ship. It sits 38 away from the red that marks the
    one button which overwrites a device, where the suite requires 100, and it
    misses AA as text on the warm ground. Moving the hue does not save it -
    away from red it runs into the amber that means "these two disagree". The
    accent becomes steel blue and terracotta keeps the icon, where no signal
    colour sits beside it.
    The spec records the measured numbers rather than the intent, so the plan
    can be checked against thresholds the test suite already asserts.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
2026-08-30 Draw the capture countdown as a ring
    Add theme.CountdownRing: a painted arc-and-numeral widget that shows
    seconds remaining. It holds no timer - whatever is counting tells it
    what to show - and owns its own accessible name via _announce(), so
    a screen reader hears the count change.
    tools/update_translations.py did not scan ui/theme.py, so the new
    "{0} s left" source under the CountdownRing context went undetected
    until ui/theme.py was added to TRANSLATED_MODULES. Filled in the
    Russian side and regenerated both catalogues.
2026-08-30 Give the capture dialog a frameless shape and a ring
    CaptureDialog now uses theme.CountdownRing instead of a plain label,
    loses its window frame, and gets an entrance animation (fade in on
    open, lift in on start). The ring owns its own accessible name from
    the seconds remaining, so the dialog no longer sets a static one that
    the first tick would silently overwrite; regenerated translation
    catalogues accordingly.
2026-08-30 Stop a faded page from keeping its effect forever
    fade_in() attached a QGraphicsOpacityEffect to the widget and started
    a QPropertyAnimation with DeletionPolicy.DeleteWhenStopped, which
    frees the animation object once it finishes but never touches the
    effect it was driving. Every page shown at least once inside the
    QStackedWidget in main_window.py therefore kept a permanent graphics
    effect. A widget carrying one renders through an offscreen buffer, and
    that is what leaked one page's widgets onto another inside the stacked
    widget -- the user saw the Profiles card and list drawn over the
    Bindings page after switching.
    No test caught it because the suite runs under QT_QPA_PLATFORM=offscreen,
    w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
2026-08-30 Stop the capture when the operator dismisses the dialog
    Escape and Cancel reach QDialog.reject(), which delivers no close event,
    so closeEvent - the only place the countdown was stopped - never fired on
    either. Going frameless took away the title-bar X, the system menu and
    Alt+F4, which were the three paths that did reach close(), so the dialog
    had no working exit left at all: the timer kept running and the dialog
    stayed connected to capture_received. On a connected device the operator's
    next keypress then reached a dismissed dialog and rewrote the binding
    under edit, or re-armed the hardware from the mouse-only page.
    Every dismissal now funnels through done(), which stops the timer and
    dis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
2026-08-30 Fade the dialogs against the desktop, not against black
    A QGraphicsOpacityEffect on a top-level window composites that window
    against its own backing store, which is black - not against what is behind
    it. Two of fade_in's three call sites are windows, so both modals rose out
    of a black rectangle before lightening into the page; a red frameless
    top-level at opacity 0.5 samples (127, 0, 0), which is the blend toward
    black rather than toward the desktop. Windows now fade through
    setWindowOpacity, which the compositor honours; a page inside a window
    keeps the effect, which is correct for a child and is what the page fade
    uses.
    The cleanup that clears the effect also moves from finished to
    state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
2026-08-30 Keep a fade from raising out of a widget that is closing
    Hanging the cleanup on stateChanged rather than finished caught a case
    finished never reached: the animation is a child of the widget it fades,
    so a widget destroyed mid-fade destroys the animation with it, and
    ~QAbstractAnimation emits stateChanged on its way out - into a handler
    whose widget is already gone. Both paths raised
    "Internal C++ object already deleted" out of a closing window. There is
    nothing to restore at that point, so both now say so.
2026-08-30 Give a frameless dialog an edge to be seen by
    Going frameless took the window border away, and the desktop's shadow with
    it, while the sheet painted QDialog in the same CANVAS the page behind it
    uses: a modal was an unbordered rectangle of the page colour, on the page.
    Dialogs are now SURFACE with a strong line around them and the card radius,
    so a modal reads as a card raised off the page. The main window keeps the
    page colour.
    This is not the scrim the design asked for in sections 4 and 5, which
    stays deferred: dimming the window behind a modal is new behaviour with
    decisions of its own to make, and this is what the legibility problem
    actually needed.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
2026-08-30 Stop showing facts nobody can act on
    The overview carried three cards of bookkeeping: firmware versions for
    both microcontrollers, the size of the compiled package, and four hashes
    with a synchronisation verdict. None of it answers a question an operator
    has while setting up a device.
    The firmware versions are worse than useless: protocol v1 reports the CDC
    protocol version and nothing about either microcontroller's firmware, so
    the field was hard-coded to "unknown" and read as a fault in the device
    rather than as an absence of anyone to ask. It is gone from the overview
    and from diagnostics alike; a row that can only say "unknown" is not a row.
    The diagnostic export keeps its fields, becau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
2026-08-30 Attach to the device without being asked to
    Connecting was a button the operator had to find and press before the
    program would talk to hardware that was already plugged in. There was
    never a decision behind it: there is one device, and the answer is always
    yes. The button is gone.
    The shell now attaches itself as soon as the window exists, and retries
    every two seconds while nothing is there, so a board plugged in later is
    picked up without a restart. The retry is silent — an empty socket is the
    ordinary state, not an event, and announcing it every two seconds would
    bury the log while telling the operator nothing the connection label does
    not already show.
    One consequence, accepted deli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
2026-08-30 Open the project the operator was working on
    Saving a project wrote a file the program had no way to read back: there
    was no Open button, no menu, and nothing remembered between runs. An
    operator who saved their work and restarted found an empty project and no
    route back to it — the file was a one-way door.
    The shell gains an Open button, remembers the path whenever a project is
    saved or opened, and reopens it silently at startup. A file that has been
    moved or deleted since is not an error worth a dialog: the operator gets
    an empty project and a line in the status bar, which is what a first run
    gives them anyway.
    Two things this exposed. QSettings built with no organisation name stores
    n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
2026-08-31 Say what an action does, not what the protocol calls it
    The action chooser and the bindings table both showed the protocol's own
    name: TOGGLE_KEYBOARD_ROUTE, SET_MOUSE_ROUTE PC2. That is precise and it
    tells an operator nothing. Someone setting up a switch box wants to know
    that a key will send the keyboard to the other computer.
    Each action now reads as what it does, with a sentence of explanation and
    the protocol identifier in its tooltip. The identifier is not gone,
    because it cannot be: the diagnostics, the export and the documentation
    all speak in identifiers, and a screenshot of this page has to be readable
    against them. It moved one hover away rather than disappearing.
    Two names sta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
2026-08-31 Write down how the device configuration is read back
    The format already stores everything needed - names, colours, routes,
    bindings, macros - and the protocol already states what a reader must
    validate. Only the parse is missing, and with it any way to recover a
    configuration that exists on the hardware but not in a file.
    The spec records the one thing that cannot survive the round trip: a text
    macro step is compiled to keystrokes before it is written and the source
    string is never stored, so it comes back as keystrokes and must be shown
    as such rather than as an empty text box.
2026-08-31 Lay out reading the device back as six testable steps
    The round trip carries the plan: parse a shipped vector, compile the
    result, compare bytes. Identical bytes are the only proof that no field
    was quietly dropped, and the three vectors already in the tree include
    Cyrillic and emoji names, a nine-step macro and the maximum macro ID.
    Every name the plan leans on was checked against the source rather than
    assumed - step_label rather than step_summary, the session flag dirty
    rather than is_dirty, and DeviceProject needing a schema_version that a
    DeviceConfig does not carry.
2026-08-31 Show what the device is running when the program opens
2026-08-31 Make an overlapping device read a no-op, not a race to clobber itself
    Review found that a second call to read_device_project() while one was
    already in flight failed BUSY and reset the reading flag before the real
    read completed, so the real read's success was silently discarded. Task 4
    makes this reachable on every startup (its own call overlaps the
    connect-triggered auto-read), so fix it now: guard read_device_project()
    against re-entry while a read is outstanding.
2026-08-31 Ask the device first, the file second
    The device wins at startup: the question someone opens this program
    with is what their hardware is currently doing. start_window now tries
    to autoconnect, reads the device's project when a device answered, and
    only falls back to reopening the last file when nothing did. Autosave
    recovery still runs last, unchanged, since it can override either.
2026-08-31 Delete the branch: try_autoconnect, then the file, unconditionally
    Review found the device/file branch added in the previous commit was a
    regression: DeviceService.is_connected goes true the instant the port
    opens, well before HELLO is answered (SynchronousTransportLink always
    delivers replies on the next event-loop tick). Branching on it right
    after try_autoconnect() meant taking the device arm before the device
    had answered anything - if the handshake then failed, reopen_last_project()
    was never called and the operator was left with a blank project despite
    having a file on disk. The explicit read_device_project() call in that
    branch also always failed BUSY, since the connect operation was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
2026-08-31 Say when a macro step came back from the device
    A TEXT step read from the device carries its keystrokes but never the
    sentence that produced them, because config_format.md says source
    Unicode is never stored. step_label() used to render that case as
    `step.source_text or ""`, an empty box indistinguishable from data
    loss. Now it says "From the device: {0} keystrokes", counting the
    (modifier, usage) pairs in the payload, without attempting to decode
    them back into text.
2026-08-31 Read the device at startup, and only at startup
    The autoconnect timer runs for the life of the window, and every successful
    connect queued a read of what the board is running. The dirty guard is no
    protection there: the operator opens their project, edits it, saves it, and
    then plugs the board in to write it - saved, so the read lands, replaces
    their project with the board's and drops session.path. Write then sends the
    board's own configuration back, and Save becomes a Save As pointed at their
    own file.
    The connect hook now queues its read once per window, on the first connect -
    the startup the specification grants the device. The flag is set on queueing,
    so a read that fails is not retried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
2026-08-31 Let go of a read whose link went away
    DeviceService.disconnect_device clears its operation before tearing the link
    down, so it reports no failure by design. MainWindow._on_operation_failed is
    therefore never reached, and the window's own in-flight flag was never
    cleared: a disconnect during a read left read_device_project refusing every
    later read for the rest of the window's life, with nothing to see.
    MainWindow.disconnect_device now clears the flag itself. It has no button
    behind it today, but that is exactly what a Disconnect button would call.
2026-08-31 Stop a post-startup device connect from replacing an open project
    The startup read (queued by MainWindow._on_operation_succeeded on the
    first successful connect) was only ever gated by _startup_read_done,
    which is spent by a *successful* connect. Starting with no device
    attached - the operator's normal habit - never spends it at startup,
    so the first connect that happened later, after the operator had
    saved their work, was still treated as startup and replaced the saved
    project.
    Per the user's decision, the device now wins only when the session has
    nothing of the operator's to lose (no file opened/saved, no unsaved
    edits). That decision has to be snapshotted at the moment a connect
    attempt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
2026-08-31 Name the keys a switch box is actually bound to
    A binding read back from the device showed as "usage 0x68". That is F13,
    and F13 upwards is exactly what someone binds a switch to, because nothing
    else on the machine uses those keys. The table stopped at F12, so the one
    range an operator is most likely to pick was the one range the program
    could not name.
    It knew 75 usages and left 153 unnamed. It now knows 111: F13 through F24,
    the keypad, PrintScreen, ScrollLock, Pause, Menu, and the two non-US keys.
    Anything still unknown reads as its number, as before — the device can
    report a usage no build knows, and that has to degrade rather than fail.
    This mattered little while bindings only came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
2026-08-31 Stop offering keys the operator has no way to press
    Naming a key and offering it are different jobs, and the previous commit
    conflated them: teaching the table F13 through F24 so a configuration read
    off the device would be legible also put fifteen keys into the chooser
    that an ordinary keyboard does not have.
    A binding on a key nobody can press is one that silently never fires. That
    is not hypothetical - it is what sits on the test board right now, because
    F13 was picked as a marker precisely for being unused, without anyone
    asking whether it could be pressed at all.
    So the two lists come apart. KEY_NAMES still names everything, because the
    device decides what arrives and "usage 0x68" tel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
2026-08-31 Write down that the device is the document
    Reading the configuration off the board at startup made an older
    assumption false: the file is no longer where the truth lives, but the
    program still treats it as an open document. It asks to save work that
    will be read back from the board regardless, and reports unsaved changes
    against a file that may never have existed.
    The whole change is one substitution - "changed" stops meaning "differs
    from the file" and starts meaning "differs from the device" - and the
    spec derives the rest from it: autosave, the last-project memory, the
    close prompt and two of the three state chips all exist only to serve
    the document model.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
2026-08-31 Fix a verification line that contradicted the spec above it
    Section 3 says loading a copy leaves the baseline alone, so whether the
    result reads as changed follows from whether it actually differs from the
    board. The verification list still carried the earlier wording, which
    asserted it always reads as unwritten.
2026-08-31 Lay out the move from document to device as six steps
    One task changes what "changed" measures; the other five delete what the
    old meaning needed - autosave, the last-project memory, the close prompt,
    and two of three state chips that had started contradicting each other.
    The plan warns twice about the same hazard, because it is the one that
    loses work irrecoverably: dirty also guards a device read from landing on
    an operator mid-edit, and moving its reference point must not weaken that.
2026-08-31 Compare the project against the device, not against a file
2026-08-31 Make the file a copy the operator asks for, not a document
    Save and Load stop remembering: save_project/open_project become
    save_copy/load_copy, always ask where to put or read the file, and
    never write to QSettings. Startup no longer reopens anything.
    load_copy replaces only the project (ProjectSession.with_project),
    keeping the baseline and device hash, so a loaded copy still reads
    as changed or unchanged based on whether it actually differs from
    the board - not on having just come off disk.
2026-08-31 Say once whether the board is behind
2026-08-31 Check the one chip speaks before a board ever answers
2026-08-31 Make a write's baseline what it sent, not what is on screen
    A write is chunks, WRITE_COMMIT and then a read-back - every step a full
    event-loop turn, and nothing disables the editor pages meanwhile. The
    success handler took the project as it stood when the last turn landed and
    declared that the board's, so an edit typed during the write became the new
    baseline: dirty went False, the title went clean, and with the close prompt
    gone the edit was lost without a word.
    The write now carries the project it compiled from, and that is what the
    baseline becomes. agreeing_with_device takes the project explicitly; a read
    still passes nothing, because there the project is what came back.
    Co-Authored-B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
2026-08-31 Stop a saved copy from making the board unreadable
    _connect_may_adopt gated the startup read on "path is None and not dirty"
    and was provably untested: hardwiring it to True left the whole suite green,
    because the two tests named as its proof exercise _startup_read_done and the
    dirty guard inside _adopt_device_project instead.
    It was also a data-loss path in its own right. path is set by exactly one
    thing - save a copy - and has had no UI surface since the file name left the
    title. Export the default configuration as a template with no board
    attached, plug the board in, and the board was never read: the chip said
    "differs from the project", Write was enabled, and pressing it destroyed the
    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
2026-08-31 Stop the status bar saying no device while one is attached
    "No device found. Load a copy from a file, or plug the device in." is shown
    with no timeout, so it stands until something replaces it. When a board
    turned up, try_autoconnect reset _said_no_device but left the text, and
    nothing on the connect path writes to the status bar - so on the workflow
    the comments call the primary one, the status bar said the board was absent
    while the connection chip said it was ready.
    The message is now cleared where the flag it belongs to is reset.
2026-08-31 Give the title and the chip one predicate to read
    The title's marker read session.dirty ("the project differs from the
    baseline") and the state chip read session.device_matches ("the compiled
    package differs from what the board holds"). The spec calls these one fact,
    and they diverge on ordinary paths - always with the title under-reporting.
    A second board plugged in after the startup read is spent is never read: the
    project has not moved, so the title stayed clean while the chip warned that
    the board in front of the operator was holding something else. The macro
    corner goes the other way: source text edited to different words with
    identical keystrokes compiles to the same package, so the ti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
2026-08-31 Refuse a second Write while one is still in flight
    A write leaves the link open, so nothing in can_write said no to a second
    press. The second press replaced the project the first write was holding,
    was rejected as BUSY, and that rejection cleared the held project - so the
    first write then landed with nothing to make a baseline out of and fell
    back to the project on screen, declaring an edit written that never left
    the host.
    Both halves are closed. write_to_device refuses while DeviceState is BUSY
    and the Write button greys out for the same span, so the refusal is one an
    operator never has to run into. And agreeing_with_device no longer treats
    an explicit None as "use mine": a sentinel sepa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
2026-08-31 Clear only the no-device message when a board turns up
    The flag records that "No device found..." was posted, not that it is
    still the message on screen. Anything said in between - a load that
    failed, "Project saved", "Project opened" - was wiped when the board
    arrived on the next autoconnect tick, so an operator could read why their
    file would not open and watch the explanation vanish.
    The status bar is now cleared only while it still holds that exact text,
    which one method both posts and recognises. Catalogue line numbers
    regenerated; no string changed.
2026-08-31 Let go of the project a write was sending when the link drops
    DeviceService.disconnect_device clears its operation before tearing the
    link down and deliberately reports no failure, so _on_operation_failed -
    the only other place that releases the held project - never runs. The
    read flag beside it was already cleared here for exactly that reason;
    the write's project had the identical hazard and was not. Nothing reads
    it again before the next write overwrites it, but that is a margin, not
    a guarantee, and this round has already seen what happens when something
    else clears it at the wrong moment. The neighbouring comment now covers
    both.
2026-08-31 Assert the write's own project became the baseline
    test_an_edit_made_during_a_write_is_not_declared_written proved only that
    the mid-write edit stayed pending. It said nothing about the other half of
    its own name: that the project which actually went down the wire is what
    the session now agrees with. Making agreeing_with_device return self left
    the test green.
    Taking the mid-write edit back must now read clean, which is true only if
    the write's rename was adopted as the baseline.
2026-08-31 Build the two identical-package tests on a state an operator can reach
    Both built a MacroStep with type=KEY_TAP and a source_text, which
    validate_project rejects ("only TEXT steps may contain source text"). The
    state they demonstrated has is_valid False and can_write False, so no
    operator ever reaches it with a writable project - the names claimed a
    corner that could not occur.
    A reachable one exists, and is the corner the design already anticipates:
    the package carries a TEXT macro's keystrokes and never the Unicode they
    came from, so a configuration read off the board arrives with no source
    text and the editor labels the step "From the device: N keystrokes".
    Typing that text back in compi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
2026-08-31 Ask every board that attaches what it is running
2026-08-31 Stop a replug from throwing away the text the operator typed
    The binary carries a TEXT step's keystrokes and never the Unicode they
    were compiled from, so a configuration read back from a board always
    comes home with source_text gone and the step reading "From the device:
    N keystrokes". After a successful write the session is clean by
    construction - which is exactly the state the dirty guard lets an answer
    through in - so unplugging the board and plugging it back in replaced
    the operator's own text with the board's lossy echo of it. No marker, no
    message, nothing on screen that had changed, and no way back.
    Compare the package the board sent against what the session already
    compiles to befo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
2026-08-31 Let the guard see the typing that is still in progress
    The editor pages turn text into a command on editingFinished, not per
    keystroke, so a field the operator is still typing into is not in the
    session at all and dirty reads False over it. That is the one state in
    which a device read is admitted - and adopting it repaints the very
    field they were typing in. The operator types a profile name with one
    hand, plugs a board in with the other, and the board's name lands in
    their field: title clean, chip "matches", no message. The mechanism
    pre-dates this branch but could only fire on the window's first attach,
    into an empty window nobody was typing into; every attach and every
    link recovery reach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
2026-08-31 Say in the spec that every attach asks, not only startup
    Eleven commits moved the read from startup to every attach and touched
    nothing in docs/, leaving section 5 titled "Startup, after this change"
    and describing a four-step startup sequence as the whole of it. Retitle
    it and add what actually happens: the read belongs to every attach, why
    the operator asked for that, and what it costs - adoption refused while
    the session is dirty or while an editor still holds uncommitted text,
    and skipped entirely when the board already holds what is on screen.
2026-08-31 Correct the comments the every-attach read left behind
    Three of them described the rule they were written under rather than the
    one in force: a test docstring saying the read belongs to startup and
    not to every connect, another explaining a status-bar hazard by a
    one-shot startup read that no longer exists, and a comment in
    read_device_project naming a startup sequence there is no longer any of.
    The tests themselves are right and stay as they are; only what they
    claim about why has moved.
    The session module's docstring said file_hash is empty until the session
    has been saved or loaded - but loading a copy in the shell goes through
    with_project, which sets no hash at all, so only a save ever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
2026-08-31 Amend the read feature's own spec, not only the other one
    The last round amended the-device-is-the-document design section 5 and left
    read-configuration-from-device saying the read happens at startup, that a
    missing device opens the last project file, and that the autosave recovery
    follows - two behaviours this branch deleted outright.
    Section 3 is now "Attach order": every attach reads, adoption is skipped when
    the board already holds the package the project compiles to, and the single
    dirty guard decides the rest after pending text has been committed. A closing
    note names which later change replaced which part rather than rewriting the
    history. Section 5's verification bullet and section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
2026-08-31 Let an emptied field stay empty instead of renaming to nothing
    Validation accepts "", so a field cleared to retype was committed as a
    rename the operator never made - and the commit runs on every device
    event, not only on focus-out, so a mouse button the board reports was
    enough to fire it mid-word. The session then went dirty and refused the
    attaching board's configuration, citing edits nobody had made.
2026-08-31 Name what the identity skip costs, and fix one stale comment
    The skip clears the dirty marker on a re-read of the same board, so
    typing a TEXT step's source back in reads as pending until a read
    happens and clean afterwards. That is accepted, not overlooked, and now
    says so where someone will find it.
2026-08-31 Stop the read spec saying the wiring is at startup
    Section 3 says every attach reads; section 4 still called the work
    "wiring at startup". One phrase, and the last one in the document
    contradicting the section above it.
2026-09-01 Stop one error slot freezing every key the keyboard holds
    An Aula F75 over its 2.4 GHz receiver sends boot reports with 0x01 in the
    first key slot and nothing in the other five - thirty-two of them in a
    twenty-second line of typing, against a hundred and fifty-six reports in
    all. Over the cable the same keyboard sends an empty report instead, which
    is why this only appeared once the receiver went in.
    The rollover guard took 0x01 in any slot as the keyboard saying it had lost
    count, and skipped the whole key comparison. HID 1.11 8.3 puts ErrorRollOver
    in every array field; one of them is not that. So nine per cent of this
    keyboard's reports were discarded, and each discarded report left held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
    [test_normalizers.cpp]
2026-09-01 Refuse a report that will not fit rather than applying part of it
    emit() reports that it had no room, and neither caller looked. Both then
    moved the state on as though everything had gone out - so an event that did
    not fit became one the far computer never received and this side believed it
    had. A release lost that way is a key held down with nothing left anywhere
    that would ever lift it, and the caller, handed a count, cannot tell that
    from a report where nothing happened.
    Nothing reaches it today: every caller passes kMaxEventsPerReport, which is
    twenty-eight against the twenty a report can produce. What made it worth
    closing is that the margin was undocumented and the note explaining it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
    [test_normalizers.cpp]
2026-09-01 Record the receiver whose key slot disagreed with the wired keyboard
    The hardware section listed two devices, both wired, and its list of things
    observed rather than assumed had three entries. A 2.4 GHz receiver has since
    been driven the same way and disagreed with both of them on a byte, so it is
    a fourth entry and the counts move to three and four.
    It is the one device on that page carried by its VID and PID instead of by
    its class. The page's rule is the right one - naming a bench's hardware
    invites a reader to read the absence of their own device as incompatibility -
    but the observation recorded here is true of this receiver and was not true
    of the wired keyboard in the same socket, and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
2026-09-01 Poll a peripheral as fast as its own link can answer
    An interrupt endpoint answers with the state held now, not with a queue of
    what happened, so a key whose whole press falls between two polls was never
    here at all. Every device was polled every 8 ms, and on an Aula F75's 2.4 GHz
    receiver that lost letters: two in thirty-nine at 8 ms, none in two hundred
    and thirty-one at 2 ms, while Windows - which polls the same receiver at
    1 ms - lost none of the same thirty-nine. The receiver also began carrying
    two keys in one report at 2 ms, having never once managed it at 8, which is
    the same fact from the other side: the states were always there and we were
    looking too seldom.
    The constant is not s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
2026-09-01 Handle Keychron M3 side-button reports
2026-09-02 Cover four unguarded keyboard descriptor refusals
    Mutation-verifying the parser found four guards no test held: a keyboard
    left in report 0 beside identified reports, a second key field inside one
    report, a report grown past 64 bytes after its keys were read, and an NKRO
    bitmap whose bit count disagrees with its declared usage range. Each guard
    was removed in turn and the suite stayed green, so each was proving nothing.
    The four tests here were watched failing against the parser with those guards
    removed, and pass with them restored.
    Claude-Session: https://claude.ai/code/session_015SKyWHZxqGv2E9qa34KqoK
    [test_report_descriptor.cpp]
2026-09-02 Normalize keyboard report protocol layouts
    The normalizer read every keyboard at boot protocol's offsets, which is the
    one layout a device can be forced into rather than asked about. It takes the
    device's own layout now: the identifier is validated and stripped, modifier
    bits are read where the descriptor put them, and keys come out of either a
    bounded little-endian array or a bitmap scanned from its declared usage
    minimum. Boot's layout is what is assumed until one arrives, so nothing
    changes for a device that has none.
    Two things the Aula's descriptor made concrete. It declares five slots, not
    six, and puts a vendor byte in the eighth position - read at boot offsets
    that byte is a key nob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
2026-09-02 Prefer keyboard HID report protocol
    The capture stage fetched a keyboard's report descriptor, kept it as evidence,
    and then forced the device into boot protocol anyway. It parses it now and
    keeps the layout, and SET_PROTOCOL goes out only when that fails.
    The Aula is why. It declares five key slots and a vendor byte in the eighth
    position; boot protocol's report has six slots and reads that vendor byte as
    a key nobody pressed.
    Every failure lands where the firmware landed before this existed - a keyboard
    typing on boot's fixed eight-byte report - but only for an interface that
    declares the boot subclass. Without one there is no fixed report behind the
    device, and boot offsets applied to a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
    [descriptor_setup.cpp, descriptor_setup.hpp, test_ch375_descriptor_setup.cpp]
2026-09-02 Route native keyboard HID reports
    The keyboard layout the descriptor path produces reached nothing: set_kind
    took only the mouse layout, so a parsed keyboard layout was read, kept,
    printed - and never given to the normalizer that reads reports. Both layouts
    go through on every Ready now, from the matching DescriptorSetup on Core 1.
    Setting the keyboard layout on every Ready, not only when a descriptor was
    read, is what stops the keyboard before it from being read into this one: a
    layout left behind drops every report of the next device, because none of
    them carries the identifier the last one used.
    The probe build prints klayout=report or klayout=boot with the layout's bit
    geometry beside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
2026-09-02 Record keyboard report protocol verification
    Software gates only. 36/36 native tests, 13/13 firmware artifact tests, and
    899 passed / 1 failed in the Python suite - the failure is the hardware-in-
    the-loop configurator test against a board still running older firmware, which
    this branch touches no file of, and which is recorded as unexplained rather
    than as harmless.
    The hardware acceptance - steps 3 through 6 of Task 6 - has not been run and
    needs an operator at the bench. Nothing here is evidence that keystrokes
    stopped being lost.
    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
2026-09-02 Give a shared schedule extra tokens, not the reports' turns
    report_poll_interval_us derives how often the endpoint carrying the reports
    must be sampled - 2 ms, because a key whose whole press falls between two
    polls was never here. A composite receiver spends every other token on its
    service endpoint, so that interval was being halved for the very endpoint it
    was derived for. Nothing said so, and no test looked.
    Measured with the probe build, both receivers attached: the Aula issued 521
    tokens a second and its keyboard endpoint saw 260 - one every 3.86 ms against
    the 2 ms it earned, which is inside the band where this receiver was already
    recorded dropping letters (two in thirty-nine at 8 m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
    [device.cpp, device.hpp, test_ch375_device.cpp]
2026-09-02 Count where a keystroke stops, in the probe build
    Four gaps had to be measured to find where letters were going, and each one
    took a flash to answer a single question. They stay, so the next run of the
    matrix answers all four from one reply.
    kerr is a histogram of ErrorRollOver values per report, with the counts of
    reports refused whole, recognised as rollover, or rejected as short or
    mislabelled - it is what disproved the theory that this receiver sends five
    of them, and it showed 28% of its reports carrying exactly one.
    down/up are the events the normalizer actually emitted. Against the characters
    that reach the computer they say whether a keystroke was read and lost later,
    or never read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
    [main.cpp, output_runtime.cpp, output_runtime.hpp]
2026-09-02 Record the bench session and mark the polling fix provisional
    The feature does what it was written to do - the Aula is read through its own
    descriptor, five slots, boot advertised and not selected. It did not stop the
    letters going missing, and four theories about why were each disproved by a
    measurement rather than by argument. The cause was elsewhere: a report
    endpoint sampled at half the interval derived for it because a service
    endpoint was taking every other token.
    Recorded with the numbers, including two mistakes of mine - reading Backspace
    keystrokes as evidence of loss after the normalizer, and reading U2 code for a
    path that goes through U1.
    The fix is provisional. Repeated words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
2026-09-02 Flash the release build and close the failing test
    The release U1 was rebuilt with the polling fix and flashed for the operator's
    day of use; U2 was byte-identical and left alone. The probe counters are
    compiled out of the release, so reading them again means flashing the probe
    build.
    The configurator HIL test that failed in step 1 now passes, and the suite is
    900 passed with nothing failing. The GET_DIAGNOSTICS size mismatch was a board
    running firmware older than the configurator, as suspected - it is no longer
    unexplained.
    Task 6 steps 4 and 5 are recorded as not performed by this session. The
    operator states they have already tested that ground and chose not to repeat
    it; nothing in th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
2026-09-03 Design a shared clipboard between the two computers
    The device cannot read a host's clipboard, so the data has to travel
    between the programs rather than through the hardware. That single fact
    decides most of this: Duo Input has to run on both machines, the second
    machine learns nothing from the board it is plugged into, and the link
    between them is a network one.
    Windows to Windows only, and content leaves a machine when someone
    pastes rather than when they copy - so a password that was copied and
    never pasted never travels at all.
    Claude-Session: https://claude.ai/code/session_01S1WX5CciVnNPCZdBdBTLSp
2026-09-03 Fix review feedback: independent fingerprint test, repr filtering, and crypto validation
    - Replace tautological fingerprint test with independent DER-to-SHA256 calculation
    that catches the mutation where DER encoding is swapped for PEM
    - Add field(repr=False) to certificate_pem and key_pem to prevent private key
    material from appearing in logs, exceptions, or repr() output
    - Add three tests for cryptographic properties: SECP256R1 curve, self-signed
    certificate (issuer == subject), and 10-year validity period
    - Expand module docstring to explain partial disk state handling: any missing
    file causes full regeneration with new fingerprint, breaking existing pairings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
    [test_identity.py]
2026-09-03 Remember exactly one computer, by its fingerprint
    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
2026-09-03 Frame what the two machines say to each other
    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
2026-09-03 Add direct mutation coverage for empty-payload protection
    The first-line check for payload length must catch empty payloads to
    prevent IndexError at payload[0] indexing. Previous test only verified
    the regex message, which could match secondary guards. New test
    verifies with zero-length payload that the check is genuinely needed.
    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
    [test_wire.py]
2026-09-03 Log fetch errors to prevent silent failures during content retrieval
    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
    [test_backend.py]
2026-09-03 Take a clipboard snapshot, and refuse the ones marked private
    QClipboard works in offscreen mode:
    - Tested with: QT_QPA_PLATFORM=offscreen
    - Result: 'прочитано: проверка' (successfully wrote and read from clipboard)
    - Conclusion: live clipboard monitoring can be tested without pytest markers
    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
2026-09-03 Add comprehensive tests for WindowsClipboardBackend class
    Coverage gaps identified in review:
    - Debounce aggregation of multiple signals
    - Bounded retry attempts with RETRY_LIMIT
    - Suppression of self-published data via _suspended
    - Idempotent start/stop operations
    - Boundary check for MAX_CONTENT_BYTES (exactly at limit is valid)
    Mutation testing confirms all guard conditions:
    - Debounce removal: 3 signals -> 3 snapshots (FAIL)
    - Retry limit removal: infinite retries, timer never stops (FAIL)
    - Boundary > to >=: rejects payloads at exact limit (FAIL)
    All 16 tests pass (7 functions + 9 class).
    [test_windows_backend.py]
2026-09-03 Fix test for _running guard: count handler invocations, not snapshots
    Previous test relied on idempotent side effects and passed even without
    the guard. New test wraps _on_data_changed with a counter and verifies
    that repeated start() results in single handler invocation per signal.
    Mutation testing: removing guard causes handler to be called 2x instead
    of 1x, confirming the guard is necessary.
    Also corrected misleading explanation in report about Qt signal
    deduplication - PySide6 does not deduplicate connect() without explicit
    Qt::UniqueConnection flag.
    [test_windows_backend.py]
2026-09-03 Fix second belt logic and encoding issues
    - Fix UTF-8 encoding in service.py (was BOM + double-encoded Cyrillic)
    - Correct second belt to prevent data loss: only reject snapshot if ALL
    formats match the received offer AND have same digests. Prevents silent
    loss of new content mixed with old (e.g., same text + new image).
    - Add comprehensive tests for all second belt scenarios: full match, new
    format mixed with old, format missing from received, etc.
    - Implement explicit AND logic to catch mutations: format must be present
    in received offer AND digest must match, not just OR.
    [test_service_rules.py]
2026-09-03 Fix two plan defects the implementers ran into
    The listener never completed a handshake: a self-signed certificate is
    refused server-side without sslErrors handling, so the connection never
    reached nextPendingConnection and the plan's own tests could not pass.
    And the echo belt discarded a whole snapshot when a single format
    matched, which loses a copy the user actually made - paste a picture
    alongside text already received, and the picture vanished silently. An
    echo is an exact repeat of what arrived, not an overlap with it.
2026-09-03 Make the pairing-mode check the same contract on both sides of the handshake
    _on_encrypted decided pairing mode by truthiness of expected_fingerprint,
    while _on_ssl_errors used `is None`. An empty-string expectation is falsy
    but not None, so the two checks disagreed: unreachable over the network
    today only because TLS tears down self-signed handshakes before the second
    check runs, not because the check itself was correct.
    [test_peer_link.py]
2026-09-03 Fix timer and signal testing with QApplication fixture
    [test_discovery_beacon.py]
2026-09-03 Inject UDP socket into Discovery constructor for proper signal testing
2026-09-03 Track ui/tray.py and ui/clipboard_page.py for translation, tighten fingerprint test
    Both files had strings invisible to the translation coverage check because
    neither was in TRANSLATED_MODULES, so their English catalogue entries were
    silently missing. Add both, fill the Russian catalogue with the identical
    Russian text and the English catalogue with real English translations
    (fill_english() copies the Russian source verbatim when it assumes English
    source text, so each of the 17 new entries was checked and corrected by hand).
    Also rewrite the fingerprint test to assert the full fingerprint is shown
    rather than only its first 16 characters, since the old assertion would not
    have failed had t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
2026-09-03 Gate pairing behind mutual PAIR_CONFIRM, not an open TLS door
    An unpaired node accepted any incoming TLS certificate and immediately
    enabled clipboard exchange, because expect(None) stayed in effect
    whenever there was no trusted peer instead of only during pairing.
    Split pairing into its own PAIR_REQUEST/PAIR_CONFIRM handshake that
    only shows the code; the operational link (attach_link/CONNECTED) now
    starts only once both sides have agreed, and the listener refuses
    every certificate outside an active pairing window.
2026-09-03 Wire shared clipboard into the production runtime
2026-09-03 Guard identity persistence against a torn three-file write
    load_or_create() wrote the key, certificate, and origin id as three
    separate file writes; an interruption between them could leave a
    consistent-looking triple that actually pairs a fresh key with a
    stale certificate, or a stale origin id with a fresh certificate,
    silently breaking TLS or peer recognition. Validate the triple on
    read instead: the key must match the certificate's public key, the
    origin file must match the certificate's embedded id, and both PEM
    files must parse. Any disagreement or corruption now regenerates the
    identity wholesale, exactly like a missing file already did.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
    [test_identity.py]
2026-09-03 Fix coordinator link-loss, forget-peer and manual-address bugs (I1-I4, M4)
    Subscribe link.disconnected on every path that creates a working link, not
    just the outgoing one, so a dropped incoming or just-paired link is noticed
    (I1). forget_peer() now stops the retry/silence timers and discovery, and
    _try_connect() refuses to search without a trusted peer, so a forgotten node
    stops broadcasting its identity forever after 30s (I2). set_manual_address()
    closes and detaches the previous link before dialing a new one, so a live
    link no longer doubles every announcement (I3). _drop() now carries its
    reason into a distinct PROTOCOL_MISMATCH state instead of retrying forever
    against a peer that will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
    [test_coordinator.py, test_peer_link.py]
2026-09-03 Log clipboard drops instead of failing silently, fix stale docstring (I5, M2)
    windows_backend.snapshot_from() now logs a warning naming the format and
    size when a snapshot over the 32 MiB ceiling is dropped, instead of
    disappearing without a trace. service.on_local_snapshot() catches the
    ValueError describe() raises for an oversized payload it did not filter
    itself, logs it and declines to publish - the same outcome as the platform
    boundary's silent drop, so both paths now agree on one convention (log, no
    crash) instead of one throwing and one dropping quietly.
    _fetch()'s docstring stopped claiming that new local snapshots are ignored
    during the wait: the suspend flag only guards publish(),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
    [test_service_rules.py, test_windows_backend.py]
2026-09-03 Reject a boolean seq/size in ClipboardOffer.from_dict (M7)
    isinstance(x, int) accepts bool since bool subclasses int, so a wire message
    with seq=true or size=false would have parsed as seq=1 / size=0 instead of
    being refused. discovery.decode_beacon() already excludes bool for its
    integer fields; from_dict() now follows the same convention.
2026-09-03 Wire the shared-clipboard and autostart toggles to the runtime (C1, C2, I6, I7)
    The sharing_toggled/autostart_toggled signals on the page and tray were
    declared and emitted, but connected to nothing - the switch existed but
    could not turn anything on or off. configure_runtime() now builds a
    _ClipboardRuntime that starts or stops the coordinator, backend and tray on
    either toggle, persists both settings, and reads them back at startup so the
    page and tray always agree (the tray no longer forces itself to
    checked=True regardless of what was saved). No socket opens until the
    switch is actually turned on.
    _ClipboardRuntime is a QObject parented to the application rather than a
    plain object: PyS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
    [test_autostart.py]
2026-09-03 Correct the design spec's key algorithm and drop an unused timeout (I8, M1)
    The spec said ECDSA P-256; the code has always generated and required
    RSA-2048, because Qt's Windows Schannel backend could not import the EC
    private keys cryptography produced - the switch was forced, not aesthetic,
    and identity.py rotates any leftover EC identity it finds on disk. The spec
    now says RSA and states why, so the next reader does not have to
    reverse-engineer the discrepancy.
    Also removes the spec's claim of a separate 5-second "first response"
    timeout: content arrives as one CONTENT frame, not a stream, so this layer
    has no observable boundary between "the peer started answering" and "the
    peer finished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
2026-09-03 Make the window always tray on close; build the tray unconditionally
    MainWindow.closeEvent no longer branches on clipboard/enabled: it always
    hides the window and ignores the close event, so the shared-clipboard
    setting no longer controls residency (product decision, 2026-09-03).
    That only works if a tray icon always exists to reopen or quit the
    program, so _ClipboardRuntime now builds and shows the TrayIcon in its
    constructor instead of inside _start(), and wires open/quit/toggle signals
    there too. _start()/_stop() only attach and detach the coordinator's
    signals (state_changed, etc.) to the already-existing tray; the coordinator,
    trust store and backend are still built only when the check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
2026-09-04 Design file transfer through the shared clipboard
    A spike settled the question the design rests on: the shell accepts a
    COM object from the clipboard as real files, streams gigabytes through
    it, draws its own progress and cancel, and leaves nothing behind when a
    transfer fails. A person confirmed the one part automation could not -
    Ctrl+V in a live Explorer window.
    The cost is named rather than hidden: the project stops being
    single-threaded, because COM calls us from its own threads. One small
    bridge is the only place those two worlds meet, and nothing else in the
    package learns about threads.
2026-09-04 Plan the file transfer, riskiest piece first
    Eight tasks. The bridge between the shell's threads and the event loop
    comes second, not last: everything else stands on it, and a race that
    surfaces late is a race nobody can reproduce on demand.
    The plan leans on the spike's proven code rather than inventing
    signatures - the COM scaffolding already ran against a live Explorer and
    a real Ctrl+V, and that is worth more than anything written from memory.
2026-09-04 Keep the clipboard spikes that mapped Windows paste behavior
    These probes are how the file-transfer plan learned what Explorer and
    CFSTR_FILECONTENTS actually do; they belong with the plan, not in an
    untracked corner.
    Claude-Session: https://claude.ai/code/session_01RmoXTgoCfwoLSm6F9JfQaK
